rezaxr14/solar-panel-cleaning-robot/WORD-PDF-Docs/پروژه مکاترونیک فاز دوم بهراد مشهدی زمانی جلایر رضا ندیمی.pdf

ده

شک

ن
د ن ا

ي
و

ونن

فن
ومو

عل

گزارش پرژه ی مکاترونیک 1

### فاز دوم پروژه ربات تمیز کننده صفحات خورشیدی

### توسط:

### رضا ندیمی

### بهراد مشهدی زمانی جالیر

استاد درس:

### دکتر هادی

### نیمسال اول 1404-1405

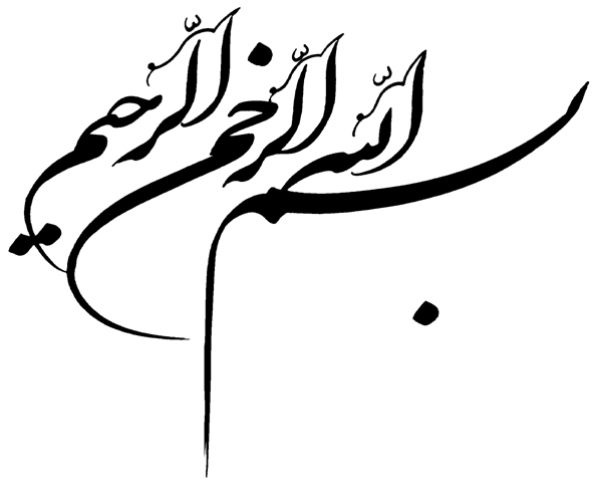
[picture p71: figure]

## فهرست

1-1پ یشگفتار | : 8
بخش دوم : فرآيند طراحی، سايزي نگ و انتخاب اجزای مکانیکی و الکترونیکی11 |
.2-1 مقدمه: رويکرد سیستمی در طراحی سخت افزار رباتیک12 |
2-2 .تحلیل دينامیکی ، سايزينگ موتور اصلی و طراحی سیستم انتقال قدرت: 12 |
2-2-1 .مدلسازی نیروهای مؤثر بر سیستم حرکتی ربات12 |
2-2-2 .اعمال ضريب ايمنی و تعیین نیروی طراحی 1۳ |
2-2-۳ .محاسبه گشتاور مورد نیاز در چرخ ها: 1۳ |
2-2-۴ .طراحی سیستم چرخ دنده و نسبت انتقال 1۳ |
2-2-۵ .محاسبه گشتاور موتور با لحاظ راندمان گیربکس 1۴ |
2-2-۶ .توزيع توان بین حرکت و سیستم برس تمیزکاری: 1۴ |
.2-2-7تحلیل کیفی و مهندس ی سیستم محرکه اصلی و انتقال قدرت 1۵ |
2-2-7 .تحلیل فیزيکی عبور از مانع ارتفاع ی و اعتبارسنجی گشتاور سیستم محرکه 1۶ |
2-۳ .بررسی، مقايسه و معرفی موتورهای الکتريکی موجود در بازار: 17 |
2-۳-1 .معرفی موتور گیربکسدار مدل37ZGA 18 | :
2-۳-2 .معرفی موتور پلهای23 NEMA : 19 |
2-۳-۳ .معرفی موتور گیربکسدار(23IG (Shayang : 21 |
2-۴ .انتخاب و سايزينگ سرووموتور چرخ جانبی برای عبور از ناهمترازی 22 |

2-۴-1 .محاسبه نیروی نرمال مؤثر بر سیستم2۳ |
2-۴-2 .تحلیل هندسی تماس چرخ جانبی با مانع 2۳ |
.2-۴-۳ محاسبه نیروی الزم برای باال رفتن از ناهمترازی 2۴ |
2-۴-۴ .محاسبه گشتاور مورد نیاز سرووموتور 2۴ |
2-۴-۵ .جمعبندی و نتیجهگیری مهندسی 2۵ |
2-۵-1 .معرفی سرووموتور – Delta سر ی2B-ASDA 2۵ |
2۵ | L7Nسری LS / Mecapion – | سرووموتور | معرفی. 2-۵-2
2۶ | Sigma-7 (SGM7E)سری Yaskawa – | سرووموتور | معرفی. 2-۵-۳
2-۶ .انتخاب و تحلیل سنسورهای مورد استفاده در سیستم27 |
2-۶-1 .سنسور موقعیتيابی 27 |
2-۶-2 .سنسور تشخیص پله و اختالف سطح) اولتراسونیک( 29 |
2-۶-۳ .سنسور تشخیص لبه)سنسور نوری( ۳1 |
2-۶-۴ .مقا يسه و انتخاب سنسورهای تشخیص لبه(Sensors Optical / IR (۳۳ |
-2-۶-۴سامانه بینايی و عمقياب ی مبتنی بر دوربینMini ZED : ۳۵ |
2-۶-۶ .انتخاب و تحلیل واحد پردازش مرکزی(32ESP (۳۶ | :
بخش ۳ : شبیه سازی ۳9 |
-۳-1مقدمه : ۴0 |
-۳-2شبیه سازی و طراحی سه بعدی در سالیدورک: ۴0 |
-۳-2-1تحلیل مکانیزم پولی–تسمه تنظیم ارتفاع برس: ۴1 |
-۳-2-2تحلیل انتخاب آرايش خروجی گیربکس و تخصیص آن به مکانیزم برس۴2 |
-۳-2-۳تحلیل خواص جرمی اسمبلی ربات تمیزکننده پنل خورشی دی۴۴ |
۳-2-۴مکانیزم چرخ های جانبی برای عبور از عدم همراستايی پنلها ۴7 |
۳-2-۵انکودر افزايشی شیاردار برا ی تعیین موقعیت خطی ربات: ۴9 |
-۳-۳شبیه سازی در متلب : ۵1 |
۶0 | Abstract

## فهرست اشکال

شکل1-2 تصویر موتور 37ZGA | 19
شکل 2-2 دیناشیت مربوط به موتور مورد نظر | 19
شکل 2-3 تصویر موتور پله ای 23NEMA | 21
شکل2-4 دیتاشیت برای موتور 23NEMA | 21
شکل2-5 تصویر موتور (23IG(SHAYANG | 22
شکل 2-6 لیست سررو های مورد نظر | 27
شکل 2-7 تصویر انکودر های انتخابی | 29
شکل 2-8 لیست سنسور های التراسونیک پ یشنهادی | 31
شکل9-2 سنوسر های نوری | 3⁵
شکل 2-10تصویر بلوک دیاگرام فعالیت های ربات | 38
شکل 3-1 طراحی سه بعدی ربات | 41
شکل3-2 تثویر موتور dc وگی ر بکس مورد نظر برای طراحی و خروجی های ان | 43
شکل | 3-3 44
46 | Mass Properties 3-3شکل
شکل | 3-5 47
شکل | 3-6 47
شکل 3-7نمونه تصویر وجود عدم هم راستایی در پنل های خورشیدی | 49
شکل 3-8 تصویر چرخ کناری در ربات برای جابجایی در عدم هم راستایی پنال های خورشیدی | 49
شکل 3-9 شبیه سازی ربات در سیمولینک | 53
شکل 3-10 سیکل رفت وبرگشت سهمرحله ای نشان | 54
شکل3-11 سرعت زاویه ای شفت موتور | 5⁵
شکل 3-12 تراژکتوری سفارشی 40 ثانیه ای با چرخشهای زمانی تتا | 57
شکل3-13 فایل ها ی کد برای باز کردن سیمولینک | 59
شکل3-14 سیمولینک های مورد نظر برای دریافت انیمیشن | 59

### چکیده

در مرحله اول اين پروژه، تمرکز بر تعريف نیازمندیهای عملکردی ربات و انتخاب قطعات کلیدی بود. تحلیل وظايف ربات منجر به

تعیین الزامات دقیق در زمینه گشتاور، سرعت و دقت حرکتی شد. در بخش انتخاب اکچويتورها ، بر اساس اين الزامات، محرکهای

اصلی )مانند موتورها يا جکهای خطی( با در نظر گرفتن نسبت توان به وزن بهینه انتخاب گرديدند. همزمان، فرآيند سايزينگ دقیق

برای اطمینان از ظرفیت کافی تمامی اجزای محرک انجام شد.

برای بخش حسگرها ، ترکیبی از سنسورهای موقعیت، نیرو و بینايی )در صورت لزوم( انتخاب شدند تا بازخورد دقیق محیطی و

وضعیت داخلی ربات فراهم شود. اين سنسورها بر اساس قابلیت اطمینان، نرخ نمونهبرداری و سازگاری با سیستم کنترل مرکزی

دسته بندی و نهايی شدند. در نهايت، تمامی اين اجزا در قالب يک طراحی مفهومی يکپارچه شدند. اين طراحی شامل شماتیک اولیه

مکانیزمها، محل قرارگیری اجزا و برآوردهای اولیه مصرف انرژی است که زيربنای طراحی تفصیلی مراحل بعدی خواهد بود. اين فاز

با موفقیت و تايید فنی تمامی انتخابهای اولیه به پايان رسید.
کلید واژه : انتخاب م حرک ، انتخاب سنسور ، طراحی مکانیکی، مدلسازی

# مقدمه

## 1-1پیشگفتار:

اين گزارش به تشريح فرآيند طراحی و توسعه يک سیستم رباتیک اختصاص دارد که هدف آن انجام حرکت در طول صفحه های خورشیدی و تمیز کاری در عین حال جابجايی به صفحات بعدی و تشخیص موانع و رد کردن ان ها در صورت توان است. طراحی رباتهای پیچیده نیازمند يک رويکرد سیستمی و چندرشتهای است که از تحلیل دقیق نیازمندیها آغاز شده و تا انتخاب دقیق اجزای سخت افزاری و نرمافزاری ادامه میيابد.

مرحله اول پروژه، که در اين گزارش ارائه میشود، بر پايهريزی چارچوب فنی و انتخاب اجزای حیاتی متمرکز بود. اين فاز شامل تعیین مشخصات عملکردی مورد نیاز، تجزيه و تحلیل بارگذاری ها و سپس انتخاب دقیق قطعاتی است که تضمین کننده دستیابی به اهداف طراحی باشند. در اين راستا، فرآيند اکچويتور سايزينگ به دقت انجام شد تا اطمینان حاصل شود که تمامی اجزای محرک )موتورها و سرووها( دارای توان و گشتاور کافی برای حرکت مطلوب هستند. همزمان، انتخاب مجموعهای از سنسورهای مناسب برای پايش وضعیت داخلی و تعامل با محیط، به عنوان ستون فقرات سیستم کنترل، مورد توجه قرار گرفت. اين تصمیمات اولیه، که نتیجه تلفیق تئوری مکانیک و دادههای عملکردی است، اساس طراحی فیزيکی و ساختار نهايی ربات را تشکیل میدهند.

## -1-2 هدف از اين الگو و دستورالعمل

هدف اصلی تدوين اين الگو و دستورالعمل، ايجاد چارچوبی منسجم و استاندارد برای فرآيند طراحی، مستندسازی و توسعه سیستم رباتیک است. اين سند با هدف اطمینان از انطباق تمامی مراحل طراحی با نیازمندیهای عملکردی، الزامات فنی و استانداردهای ايمنی تدوين شده است. هدف ديگر، تسهیل فرآيند تصمیمگیریهای مهندسی از طريق ارائه متدولوژی دقیق برای انتخاب قطعات )مانند موتور، سروو و سنسورها( و اکچويتور سايزينگ بر اساس تحلیلهای کمی و کیفی است.

اين الگو همچنین به منظور تضمین تداوم دانش فنی در تیم طراحی، ايجاد شفافیت در مراحل اجرايی و امکانپذيرسازی ارزيابیهای دقیق در فازهای بعدی )مانند ساخت و تست( عمل میکند. در نهايت، اين دستورالعمل راهکاری برای کاهش خطاهای طراحی، بهینه سازی مصرف انرژی و اطمینان از قابلیت اطمینان سیستم نهايی در شرايط عملیاتی واقعی ارائه میدهد.

### .1-2-1 توانايی عبور از موانع و عبورپذيری در محیط های ناهموار

يکی از اهداف بنیادين در طراحی اين ربات، تضمین قابلیت عملکرد پايدار در محیطهای دارای مانع و ناهمواری های سطحی است که در شرايط عملیاتی واقعی اجتنابناپذير هستند. برای تحقق اين هدف، استراتژی »عبور از موانع« در مرحله انتخاب اکچويتورها و طراحی مکانیسم چرخش محورهای محرک لحاظ شده است. با انجام محاسبات دقیق اکچويتور سايزينگ و اطمینان از گشتاور کافی، سیستم قادر است با غلبه بر نیروی اصطکاک و مقاومت ناشی از تغییر شیب، موانعی با ارتفاع مشخص را بدون گیر کردن يا از دست دادن تعادل پشت سر بگذارد. مکانیزم تعلیق و چیدمان چرخ ها/پاهای ربات به گونه ای بهینه سازی شده که در هنگام برخورد با مانع، نیروی عمودی الزم برای باال آوردن بدنه و عبور از آن با کمترين مصرف انرژی و حداکثر پايداری تأمین شود. اين قابلیت به ربات اجازه میدهد تا در صورت وجود خرابیهای سطحی، تیرهای سیمکشی، يا بلوکهای مانع، مسیر خود را به صورت مستقل و بدون نیاز به دخالت اپراتور ادامه دهد که اين امر برای اپلیکیشن های خودگردان حیاتی است.

### .1-2-2 مديريت انطباق و جابجايی در پنل های دارای اختالف ارتفاع

در سناريوی های عملیاتی که ربات بايد روی سطوحی نظیر پنل های خورشیدی يا ديوارهای بتنی حرکت کند، وجود اختالف ارتفاع يا شکافهای جزئی بین پنلها چالش اصلی محسوب میشود. اين گزارش تشريح میکند که چگونه سیستم طراحی شده با بهرهگیری از قابلیتهای کنترلی پیشرفته و انتخاب سروو-موتورهای با دقت باال، قادر است اين اختالف ارتفاعها را به صورت ايمن مديريت کند. هدف، جلوگیری از ايجاد شوک به بدنه و سنسورها و همچنین پیشگیری از لغزش يا سقوط ربات در زمان جابجايی روی لبههاست. با تحلیل دينامیک حرکت و تنظیم دقیق گشتاور سرووها، ربات میتواند با شیبهای مجاز و اختالف ارتفاعهای طراحیشده )مثالً تا چند سانتیمتر(، به تدريج و با هماهنگی محورهای مختلف حرکت کند تا نیروی ضربانی به حداقل برسد. اين رويکرد اطمینان حاصل میکند که حتی در صورت وجود ناهمواری های پیشبینینشده يا تغییرات جزئی در نصب پنلها، ربات همچنان ثبات خود را حفظ کرده و وظیفه خود را با موفقیت به انجام میرساند.

### .1-2-۳ استراتژی جابجايی طولی پس از تکمیل عملیات روی صفحات )سیستم ريلی عقب(

با توجه به نیاز به بازرسی يا تعمیر مداوم صفحات متعدد، طراحی مکانیکی ربات شامل يک سیستم ريلی اختصاصی در قسمت
1( است که امکان جابجايی سريع و دقیق پس از اتمام عملیات روی يک صفحه را فراهم می | عقب
کند. اين ريل به عنوان يک مسیر
2 | هدايتکننده
عمل کرده و با حذف وابستگی ربات به اصطکاک سطح زمین در لحظه جابجايی، دقت موقعیتيابی را افزايش میدهد.
هدف از اين طراحی، حذف زمان توقف طوالنی و کاهش فرسايش چرخ ها در حین تغییر محل از يک صفحه به صفحه مجاور است. پس از اتمام کار روی هر صفحه، سیستم میتواند بدنه را با استفاده از سروو-موتورهای ريلی به آرامی روی اين ريل جلو ببرد و در موقعیت شروع صفحه بعدی مستقر شود. اين مکانیزم نه تنها سرعت عملیات را افزايش میدهد، بلکه با ايجاد يک مسیر فیزيکی
۳ را در جابجايیهای تکراری به صفر نزديک میکند و امکان انجام عملیاتهای پی | مشخص، احتمال خطای مسیر
درپی را بدون نیاز
به تنظیم مجدد دستی فراهم میسازد.

### .1-2-۴ اصالح انحراف افقی و هم راستايی خودکار

يکی از چالشهای فنی در حرکت روی سطوح بزرگساخته، عدم دقت در قرارگیری اولیه يا انحراف جزئی محور حرکت ربات نسبت
۴ | به محور اصلی صفحات
است. برای مقابله با اين مسئله، در طراحی ربات امکانی لحاظ شده است تا در صورت وجود انحراف افقی،
ربات بتواند به صورت خودکار وضعیت خود را اصالح کرده و به مسیر صحیح بازگردد. اين قابلیت از طريق هماهنگی بین دادههای سنسورهای موقعیتياب )مانند اينورسینج يا سنسورهای فاصلهسنج( و کنترلوهای سروروها اعمال میشود. اگر ربات در هنگام حرکت روی ريل يا سطح پنل، نسبت به محور مرکزی انحراف داشته باشد، سیستم کنترلی با تغییر سرعت نسبی بین چرخهای چپ و راست )در رباتهای دو چرخ( يا با استفاده از مکانیزمهای چرخش مستقل، زاويه بدنه را اصالح کرده و آن را همراستا با مسیر میکند. اين

1 Rear Rail System
2 Guide Path
3 Deviation
4 Misalignment

۵ | مکانیزم »همراستايی خودکار
« تضمین میکند که حتی با وجود خطاهای اولیه در جايگذاری يا تغییرات مسیر، ربات همیشه در
مسیر مطلوب باقی مانده و از برخورد به لبه های پنلها يا افتادن از مسیر جلوگیری میشود که اين امر برای ايمنی و دقت عملیات حیاتی است.

5 Self-Alignment

## بخش دوم : فرآيند طراحی، سايزينگ و انتخاب اجزای مکانیکی و الکترونیکی

### .2-1 مقدمه: رويکرد سیستمی در طراحی سخت افزار رباتیک

اين بخش به تشريح روش شناسی جامع و محاسبات دقیق مهندسی مورد استفاده در فاز طراحی سختافزاری سیستم رباتیک میپردازد. هدف اصلی، استنتاج پارامترهای بهینه برای تمامی اجزای فعالکننده و حسکننده است، به گونهای که قیود دينامیکی و سینماتیکی مدل ربات به طور کامل محقق گردد. رويکرد اتخاذ شده، مبتنی بر تحلیل مدلسازی سیستم های دينامیکی و بهینه سازی پارامترهای کنترل است.

در گام نخست، با توجه به مشخصات طراحی شده در فاز مفهومی، نیازهای گشتاور و سرعت زاويهای برای هر درجه آزادی استخراج شد. اين استخراج، مبنای محاسبات سايزينگ اکچويتور قرار گرفت. برای اطمینان از توان الزم برای غلبه بر اينرسی، نیروی گرانش و نیروهای خارجی ناشی از عبور از موانع )مطابق با بخش -1 1-۳(، موتورهای اصلی بر اساس منحنیهای عملکردی انتخاب شدند. به موازات آن، سروو-موتورهای کمکی که مسئولیت تنظیم دقیق وضعیت و تصحیح خطاهای کوچک را بر عهده دارند، بر اساس الزامات مربوط به رزولوشن و زمان پاسخ دستهبندی و انتخاب گرديدند.

در ادامه، طراحی مکانیزم انتقال قدرت )شامل چرخدندهها و اتصاالت( بر اساس تحلیل مفهوم نسبت انتقال )( صورت پذيرفت تا تطابق بهینهای بین فضای عملیاتی موتور )حداکثر سرعت دورانی( و گشتاور مورد نیاز در مفاصل نهايی برقرار شود. سرانجام، برای حلقه بسته کنترل ، انتخاب سنسورها )شامل رمزگذارها ، سنسورهای اندازهگیری نیرو/گشتاور و سنسورهای ناوبری( با در نظر گرفتن معیارهايی چون نويز ، پهنای باند فرکانسی و يکپارچگی دادهها انجام شد. اين ترکیب هماهنگ از اجزای فعال و غیرفعال، زيربنای پیادهسازی الگوريتمهای پیشرفته کنترل حرکت در مراحل بعدی خواهد بود.

### 2-2 .تحلیل دينامیکی، سايزينگ موتور اصلی و طراحی سیستم انتقال قدرت:

### 2-2-1 .مدلسازی نیروهای مؤثر بر سیستم حرکتی ربات

با توجه به عملکرد ربات بر روی پنلهايی با زاويه شیب مشخص، اولین گام در سايزينگ اکچويتور، تحلیل نیروهای وارد بر سیستم حرکتی است. در اين پروژه، زاويه شیب پنلها برابر با:

2-1 =25∘ θ

در نظر گرفته شده است. مؤلفه نیروی وزن ربات در راستای شیب، که نیروی غالب در حرکت رو به باال محسوب میشود، از رابطه زير محاسبه میگردد:

Fgravity=mgsin(θ) | 2-2
با جايگذاری مقادير عددی:
)≈116.12N | 2-۳ 25∘ Fgravity=28.01×9.81×sin(

عالوه بر نیروی ناشی از گرانش، اثر عبور از موانع، ناهمواری سطح و مقاومتهای پیشبینینشده نیز لحاظ شده است. اين نیرو به صورت محافظه کارانه برابر با:

Fobstacle≈165.15N | 2-۴
در نظر گرفته شد. در نتیجه، نیروی پايه وارد بر سیستم برابر است با:
Fbare=Fgravity+Fobstacle=281.27N | 2-۵

### 2-2-2 .اعمال ضريب ايمنی و تعیین نیروی طراحی

به منظور تضمین عملکرد ايمن سیستم در شرايط غیرايدهآل، از ضريب ايمنی مکانیکی:

S.F1=2.25 | 2-۶
استفاده شده است. نیروی طراحی نهايی به صورت زير محاسبه میشود:
Fdesign=Fbare×S.F1 | 2-7

2-8

Fdesign=281.27×2.25≈632.86N

اين مقدار، مبنای محاسبات گشتاور چرخ ها و در نهايت موتور اصلی قرار گرفته است.

### 2-2-۳ .محاسبه گشتاور مورد نیاز در چرخ ها:

قطر خارجی چرخ ها برابر با ۶0 میلیمتر است، بنابراين شعاع مؤثر چرخ:

r=0.06m | 2-9
گشتاور کل مورد نیاز در مجموعه چرخ ها از رابطه زير به دست میآيد:
Twheels,total=Fdesign×r | 2-10
Twheels,total=632.86×0.06≈37.97N | 2-11
با توجه به اين که سیستم حرکتی از دو چرخ محرک استفاده میکند، گشتاور مورد نیاز برای هر چرخ برابر است با:
Twheel=Twheels,total/2≈18.98N | 2-12

### 2-2-۴ .طراحی سیستم چرخ دنده و نسبت انتقال

برای تطبیق گشتاور مورد نیاز چرخ ها با محدوده کاری موتور، از يک سیستم انتقال قدرت چندمرحلهای استفاده شده است. اين سیستم شامل چهار چرخدنده است که به صورت دو به دو با يکديگر درگیر هستند:

مرحله اول: نسبت دنده :

N1 = 92/20 | 2-1۳
مرحله دوم: نسبت دنده:
N2= 220/40 | 1۴-2

نسبت انتقال کل سیستم از حاصلضرب اين دو مرحله به دست میآيد:

I=92/20×220/40=25.3 | 2-1۵

اين نسبت انتقال، نقش کلیدی در افزايش گشتاور خروجی و کاهش سرعت زاويهای ايفا میکند و به گونهای انتخاب شده است که هم نیاز حرکتی ربات و هم نیاز عملکردی برس تمیزکاری را پوشش دهد.

### 2-2-۵ .محاسبه گشتاور موتور با لحاظ راندمان گیربکس

با در نظر گرفتن راندمان گیربکس:

η=85%=0.85 | 2-16
گشتاور مورد نیاز موتور از رابطه زير محاسبه میشود:
Tmotor= Twheel/I×η | 2-17
Tmotor=18.98/25.3×0.85≈0.88N | 2-18

اين مقدار، حداقل گشتاور نامی مورد نیاز موتور اصلی است که مبنای انتخاب موتور قرار گرفته است .

### 2-2-۶ .توزيع توان بین حرکت و سیستم برس تمیزکاری:

يکی از ويژگیهای مهم طراحی اين سیستم، استفاده همزمان از خروجی گیربکس برای حرکت ربات و چرخش برس تمیزکاری است. به دلیل نسبت انتقال باال، سرعت خروجی موتور به دو شاخه تقسیم میشود:

شاخه اول: ورودی چرخ های حرکتی با سرعت خطی طراحیشده برابر با:

v=10m/min | 2-19
شاخه دوم: ورودی برس تمیزکاری که به دلیل استفاده از نسبت های دنده متفاوت، دارای سرعت زاويهای باالتر نسبت به چرخ ها است.

اين افزايش سرعت برس، منجر به بهبود کیفیت عملیات تمیزکاری بدون نیاز به موتور مجزا شده و در نتیجه باعث کاهش وزن، مصرف انرژی و پیچیدگی سیستم میگردد. چنین طراحی ای نشاندهنده يک رويکرد بهینه سازی چندهدفه در طراحی مکانیکی– مکاترونیکی سیستم است.

### .2-2-7 تحلیل کیفی و مهندسی سیستم محرکه اصلی و انتقال قدرت

در طراحی سیستم حرکتی ربات، رويکرد اصلی بر پايه تحلیل جامع رفتار دينامیکی ربات در شرايط واقعی بهرهبرداری بنا نهاده شده است. با توجه به اين که ربات موظف به حرکت بر روی سطوح شیب دار با زاويه قابل توجه است، نیروی محرکه مورد نیاز نهتنها بايد بر مؤلفه وزن در راستای شیب غلبه کند، بلکه بايد توانايی مقابله با اثرات ناشی از ناهمواری سطح، اصطکاکهای متغیر و عبور از موانع موضعی را نیز داشته باشد. از اين رو، طراحی سیستم محرکه با ديدگاه محافظهکارانه و با لحاظ ضرايب ايمنی مناسب انجام شده تا عملکرد پايدار سیستم در بدترين شرايط کاری تضمین شود.

در اين راستا، ابتدا نیازمندیهای حرکتی ربات شامل سرعت خطی هدف، پايداری حرکتی و قابلیت عبور از موانع مشخص گرديد. سپس با تحلیل بارگذاری مکانیکی وارد بر چرخها، گشتاور مورد نیاز در سطح تماس با زمین استخراج شد. اين تحلیلها نشان داد که استفاده مستقیم از موتور بدون سیستم انتقال قدرت، نه از نظر گشتاور خروجی و نه از نظر بهرهوری انرژی، گزينه مناسبی نخواهد بود. به همین دلیل، طراحی يک سیستم چرخ دنده چندمرحلهای به عنوان واسط بین موتور و مصرف کننده نهايی نیرو، در دستور کار قرار گرفت.

سیستم انتقال قدرت طراحیشده شامل چهار چرخدنده است که به صورت دو مرحله کاهش دور به يکديگر متصل شدهاند. اين آرايش، امکان دستیابی به نسبت انتقال باال را فراهم میکند، در حالی که توزيع بار بین مراحل مختلف باعث کاهش تنشهای مکانیکی و افزايش طول عمر اجزا میشود. نسبت انتقال کل سیستم به گونهای انتخاب شده است که موتور در ناحیه کاری بهینه خود از نظر گشتاور و راندمان عمل کرده و در عین حال، گشتاور کافی برای حرکت ايمن ربات بر روی شیب تأمین گردد.

يکی از مالحظات مهم در اين طراحی، لحاظ کردن راندمان واقعی سیستم انتقال قدرت است. با توجه به تلفات ناشی از اصطکاک، لقی دندهها و اتالف انرژی در ياتاقانها، راندمان گیربکس کمتر از حالت ايدهآل در نظر گرفته شد. اين موضوع باعث شد انتخاب موتور نه صرفاً بر اساس گشتاور تئوريک، بلکه بر مبنای گشتاور مؤثر در خروجی گیربکس انجام شود. چنین رويکردی، ريسک کمکاری موتور و افزايش دمای کاری در شرايط بارگذاری باال را به حداقل میرساند.

از منظر معماری سیستم، طراحی انتقال قدرت به نحوی انجام شده است که يک موتور واحد بتواند به طور همزمان دو وظیفه کلیدی را انجام دهد: تأمین نیروی حرکتی ربات و به حرکت درآوردن برس تمیزکاری. در اين ساختار، خروجیهای مختلف گیربکس با نسبتهای دور متفاوت مورد استفاده قرار گرفتهاند، به طوری که سرعت چرخش برس به صورت ذاتی بیشتر از سرعت چرخهاست. اين اختالف سرعت کامالً هدفمند بوده و منجر به افزايش اثربخشی فرآيند تمیزکاری بدون نیاز به افزايش توان موتور يا افزودن اکچويتور مجزا میشود.

اين رويکرد يکپارچه در طراحی سیستم محرکه، نمونه ای از بهینه سازی مکاترونیکی است که در آن، کاهش وزن کلی، سادهسازی سیستم، کاهش مصرف انرژی و افزايش قابلیت اطمینان به صورت همزمان مدنظر قرار گرفته اند. در نهايت، نتايج حاصل از اين فرآيند طراحی نشان میدهد که موتور انتخابشده، در کنار سیستم چرخدنده طراحیشده، قادر است الزامات حرکتی و عملکردی ربات را با حاشیه ايمنی مناسب برآورده سازد و بستر الزم برای پیادهسازی الگوريتمهای کنترلی دقیق در مراحل بعدی پروژه را فراهم کند.

### 2-2-7 .تحلیل فیزيکی عبور از مانع ارتفاعی و اعتبارسنجی گشتاور سیستم محرکه

عالوه بر حرکت پايدار ربات بر روی سطوح شیب دار، يکی از چالشهای مهم در عملکرد سیستم حرکتی، توانايی عبور از موانع موضعی ناشی از تغییرات ناگهانی ارتفاع، اختالف تراز بین پنلها و ناهمواری های سطحی است. اين وضعیتها معموالً منجر به افزايش لحظه ای گشتاور مورد نیاز در چرخها شده و میتوانند بهعنوان شرايط بحرانی در طراحی سیستم محرکه در نظر گرفته شوند. از اين رو، بررسی فیزيک عبور از مانع بهعنوان يک سناريوی حدی، نقش مهمی در اعتبارسنجی سايزينگ موتور و سیستم انتقال قدرت ايفا میکند.

در اين تحلیل، ارتفاع مانع برابر با:

H=10mm=0.01m | 2-20
در نظر گرفته شده است که مقدار متداولی برای اختالف ارتفاع بین سطوح کاری ربات محسوب میشود. همچنین، با توجه به نتايج بخشهای پیشین، گشتاور نامی موتور برابر با:
Tmotor=0.88N | 2-21
فرض شده است. گشتاور قابل دستیابی در چرخها با در نظر گرفتن نسبت انتقال کل گیربکس و راندمان سیستم انتقال قدرت از رابطه زير به دست میآيد:
Twheel=Tmotor×GR×η | 2-22
Twheel=0.88×25.3×0.85=18.92N | 2-2۳
در لحظه ای که چرخ با مانع تماس پیدا میکند، شرايط تماس از حالت غلتش يکنواخت خارج شده و چرخ ناچار است حول لبه مانع دوران کند. در اين وضعیت، فاصله افقی مؤثر بین مرکز چرخ و نقطه تماس با مانع بهعنوان بازوی گشتاور مقاوم عمل میکند. اين فاصله بر اساس هندسه چرخ و ارتفاع مانع به صورت زير محاسبه میشود:

2-2۴ ⁰.5 )

2 −(r−h)

2
x=(r
که با جايگذاری شعاع چرخ m0.03=r و ارتفاع مانع m0.01=h :
≈0.022m | 2-2۵ ⁰.5 )

2
x=(2(0.03)(0.01)−(0.01)
در ادامه، گشتاور مورد نیاز برای عبور از مانع از حاصلضرب نیروی وارد بر چرخ در اين بازوی مؤثر به دست میآيد. با در نظر گرفتن نیروی معادل وارد بر سیستم حرکتی برابر با:

F≈275N | 2-2۶
گشتاور مقاوم الزم برای عبور از مانع به صورت زير محاسبه میشود:
Treq=F×x | 2-27
Treq=275×0.022≈6.15N | 2-28
در نهايت، برای ارزيابی حاشیه ايمنی سیستم در اين سناريوی بحرانی، ضريب ايمنی عبور از مانع به صورت نسبت گشتاور در دسترس چرخ ها به گشتاور مورد نیاز تعريف میشود:
F.S= Twheel/ Treq | 2-29
F.S=18.92/6.15≈3.08 | 2-۳0
مقدار به دستآمده برای ضريب ايمنی نشان میدهد که گشتاور خروجی سیستم محرکه بهطور قابل توجهی بزرگتر از گشتاور الزم برای عبور از مانع ارتفاعی مورد نظر است. اين نتیجه بیانگر آن است که موتور و سیستم انتقال قدرت طراحی شده، حتی در شرايط بحرانی عبور از موانع، دارای حاشیه ايمنی کافی بوده و از نظر مکانیکی دچار کمبود گشتاور نخواهند شد.

در نتیجه، اين تحلیل بهعنوان يک اعتبارسنجی تکمیلی تأيید میکند که گشتاور سايزشده در بخشهای پیشین، نهتنها برای حرکت يکنواخت ربات روی شیب مناسب است، بلکه توانايی عبور از موانع موضعی نظیر تغییرات ارتفاع سطح را نیز به صورت مطمئن فراهم میکند. بر اين اساس، در بخش بعدی میتوان با اطمینان وارد مرحله بررسی و مقايسه موتورهای الکتريکی موجود در بازار شد.

### 2-۳ .بررسی، مقايسه و معرفی موتورهای الکتريکی موجود در بازار:

پس از انجام تحلیلهای دينامیکی، تعیین بارگذاری واقعی سیستم حرکتی و محاسبه گشتاور و سرعت مورد نیاز موتور اصلی، گام بعدی در فرآيند طراحی، تطبیق نتايج تئوريک با گزينههای عملی موجود در بازار است. در اين مرحله، هدف صرفاً يافتن موتوری با گشتاور نامی کافی نیست، بلکه انتخاب يک راهحل مهندسی بهینه است که مجموعه ای از معیارهای عملکردی، الکتريکی، مکانیکی و اقتصادی را بهصورت همزمان برآورده سازد.

موتورهای الکتريکی تجاری، علیرغم شباهت ظاهری، دارای تفاوتهای قابلتوجهی در مشخصاتی نظیر منحنی گشتاور–سرعت، راندمان، توان نامی، ولتاژ کاری، جريان مصرفی، کالس عايقی، قابلیت کار پیوسته و سازگاری با سیستمهای کنترلی هستند. از اين رو، انتخاب موتور بدون بررسی دقیق ديتاشیتها و مقايسه سیستماتیک گزينه ها میتواند منجر به افزايش مصرف انرژی، کاهش طول عمر سیستم و يا محدوديت در عملکرد دينامیکی ربات شود.

در اين بخش، ابتدا مجموعهای از موتورهای الکتريکی متداول و در دسترس در بازار که از نظر مشخصات کلی با نیازمندیهای استخراج شده در بخشهای پیشین همخوانی دارند، معرفی میشوند. سپس هر موتور از منظر پارامترهای کلیدی نظیر گشتاور نامی و بیشینه، سرعت کاری، توان خروجی، بازه ولتاژ و جريان، ابعاد فیزيکی، جرم و قابلیت اتصال به گیربکس مورد تحلیل قرار

میگیرد. در ادامه، مزايا و محدوديتهای هر گزينه در کاربرد خاص اين ربات بررسی شده و در نهايت، مناسبترين موتور بهعنوان انتخاب نهايی پروژه پیشنهاد میشود.

اين رويکرد مرحله ای، تضمین میکند که انتخاب موتور نه بر اساس در دسترس بودن يا تجربههای پیشین، بلکه بر مبنای يک فرآيند مهندسی مستند، قابل دفاع و منطبق با الزامات عملکردی سیستم انجام پذيرد.

### 2-۳-1 .معرفی موتور گیربکسدار مدل۳7ZGA :

موتور 37ZGA يکی از موتورهای DC گیربکسدار پرکاربرد در سامانههای رباتیکی و مکانیزمهای حرکتی با ابعاد متوسط است که به دلیل ترکیب مناسب گشتاور خروجی، ابعاد فشرده و سادگی راهاندازی، در بسیاری از کاربردهای عملی مورد استفاده قرار میگیرد. اين موتور معموالً به يک گیربکس سیارهای يا اسپُر با قطر اسمی حدود ۳7 میلیمتر مجهز است که امکان دستیابی به گشتاورهای نسبتاً باال در سرعتهای خروجی پايینتر را فراهم میکند.

بر اساس اطالعات ارائه شده در ديتاشیت، گشتاور نامی خروجی موتور 37ZGA برابر با 1 نیوتنمتر است. اين مقدار گشتاور بیانگر توانايی موتور در تولید گشتاور پايدار و پیوسته در شرايط کاری نرمال، بدون ورود به ناحیه اضافهبار يا افزايش غیرمجاز دما و جريان مصرفی است. در نتیجه، گشتاور نامی 1 m·N بهعنوان يک معیار محافظهکارانه و قابل اتکا برای طراحی سیستم محرکه در نظر گرفته میشود.

در چارچوب طراحی انجامشده در اين پروژه، مقدار گشتاور نامی موتور 37ZGA با نیازهای استخراج شده از تحلیلهای دينامیکی و استاتیکی )حرکت روی شیب و عبور از مانع ارتفاعی( همخوانی اولیه دارد. بهويژه، با در نظر گرفتن وجود سیستم انتقال قدرت و امکان افزايش گشتاور مؤثر در سطح چرخ ها، اين موتور میتواند بهعنوان يک گزينه ی بالقوه برای تأمین گشتاور مورد نیاز سیستم حرکتی مطرح شود.

از سوی ديگر، استفاده از موتورهای گیربکسدار نظیر 37ZGA موجب کاهش نیاز به طراحی گیربکس سفارشی، سادهسازی معماری مکانیکی و افزايش قابلیت اطمینان کلی سیستم میشود. اين ويژگیها، در کنار دسترسی مناسب اين موتور در بازار و پشتیبانی گسترده از نظر قطعات يدکی، آن را به گزينهای عملی برای پیادهسازی نمونهی واقعی سیستم تبديل میکند.

در ادامه اين بخش، با مقايسهی دقیقتر موتور 37ZGA با ساير گزينه های موجود در بازار از نظر گشتاور، سرعت، راندمان، ابعاد و سازگاری با طراحی مکانیکی، امکان انتخاب نهايی موتور مناسب برای سیستم محرکه فراهم خواهد شد.

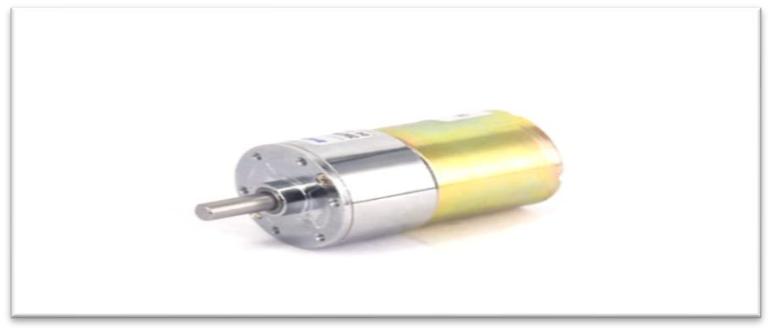
[picture p72: figure]

شکل1-2 تصوير موتور ۳7ZGA

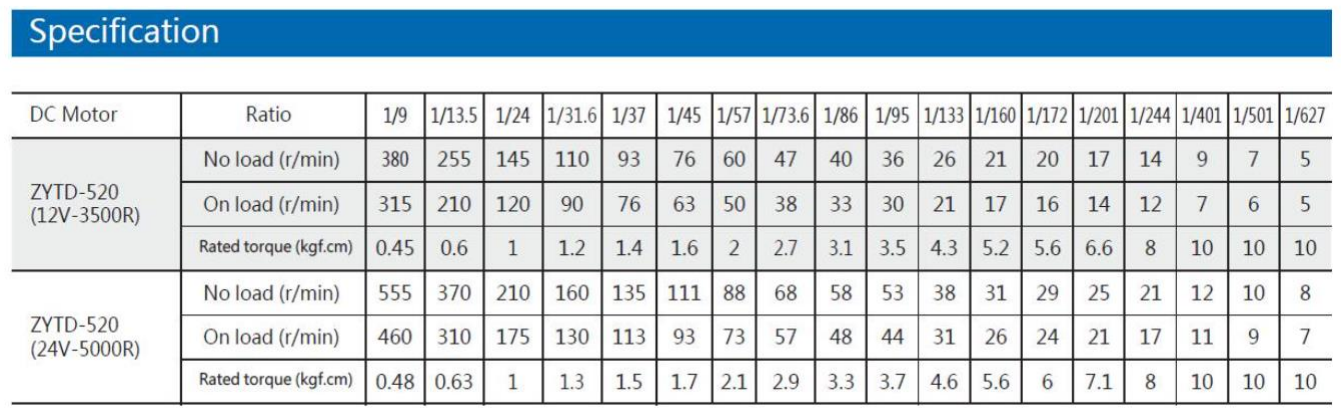
[picture p73: figure]

شکل -2 2 ديناشیت مربوط به موتور مورد نظر

### 2-۳-2 .معرفی موتور پله ای2۳ NEMA :

موتور 23 NEMA يکی از استانداردترين و پرکاربردترين موتورهای پلهای
۶
در سامانههای حرکتی صنعتی، نیمهصنعتی و
رباتیکی است. عبارت 23 NEMA به يک استاندارد ابعادی مشخص )ابعاد فلنج ۵7 × ۵7 میلیمتر( اشاره دارد که باعث شده اين موتور توسط شرکت های متعدد در سراسر جهان تولید شده و با طیف وسیعی از درايورها، کوپلینگها و اجزای مکانیکی سازگار باشد.

بر اساس مشخصات در نظر گرفتهشده در اين پروژه، گشتاور نامی موتور 23 NEMA برابر با 0٫9 نیوتن متر است. اين مقدار گشتاور، برای کاربردهايی که نیاز به کنترل دقیق موقعیت و سرعت در دورهای پايین دارند، مقدار متداول و قابل اتکايی محسوب

6 Stepper Motor

میشود. موتورهای پلهای از جمله 23 NEMA قادرند بدون استفاده از فیدبک موقعیت، حرکتهای گسسته و قابل پیشبینی ايجاد کنند که اين ويژگی در بسیاری از سامانههای حرکتی مزيت محسوب میشود.

از منظر تناسب با اين پروژه، موتور 23 NEMA چند ويژگی مهم دارد. نخست آنکه گشتاور مناسب آن در سرعتهای پايین، امکان تأمین نیروی محرکه الزم برای حرکت آرام و کنترل شده ربات را فراهم میکند. دوم، ساختار ساده و عدم نیاز ذاتی به انکودر يا سیستم کنترلی پیچیده، موجب کاهش پیچیدگی نرمافزاری و سختافزاری سیستم میشود. اين موضوع به ويژه در مراحل اولیه توسعه و ساخت نمونه آزمايشگاهی اهمیت دارد.

از نظر تولیدکنندگان، موتورهای 23 NEMA توسط شرکت های متعددی در سطح بینالمللی تولید میشوند که از جمله برندهای شناختهشده میتوان به Leadshine، Wantai، StepperOnline و Motor Oriental اشاره کرد. اين تنوع تولیدکننده موجب شده است که اين موتور در بازههای قیمتی مختلف و با کیفیتهای متفاوت در بازار موجود باشد.

از منظر دسترسی، موتور 23 NEMA يکی از در دسترسترين موتورهای صنعتی در بازار ايران محسوب میشود. اين موتور بهطور گسترده توسط فروشندگان تجهیزات اتوماسیون، CNC و رباتیک عرضه شده و تهیه آن بههمراه درايورهای سازگار، قطعات يدکی و متعلقات مکانیکی بهسادگی امکانپذير است. اين مزيت عملیاتی، ريسک تأمین قطعه و هزينههای نگهداری سیستم را بهطور قابل توجهی کاهش میدهد.

در مجموع، موتور پلهای 23 NEMA با وجود گشتاور نامی 0٫9 نیوتن متر، به دلیل استاندارد ابعادی، تنوع تولیدکننده، سهولت تأمین در بازار ايران و سادگی پیادهسازی کنترلی، میتواند بهعنوان يک گزينهی عملی و قابل اتکا برای سیستم حرکتی مورد بررسی قرار گیرد. با اين حال، انتخاب نهايی میان اين موتور و ساير گزينه ها نیازمند مقايسه دقیقتر از نظر راندمان، مصرف انرژی، رفتار دينامیکی و تطابق با نیازهای حرکتی پروژه خواهد بود که در ادامه به آن پرداخته میشود.

شکل 2-۳ تصوير موتور پله ای 2۳NEMA


تصوير2-۴ ديتاشیت برای موتور 2۳NEMA

### 2-۳-۳ .معرفی موتور گیربکسدار)2۳IG )Shayang :

موتور Shayang مدل 23IG يکی از موتورهای گیربکسدار صنعتی است که توسط شرکت Motor Shayang تولید میشود. اين شرکت يک تولیدکننده چینی فعال در حوزه موتورهای الکتريکی، موتورهای گیربکسدار و راهکارهای حرکتی برای کاربردهای صنعتی و رباتیکی است و محصوالت آن بهطور گسترده در بازارهای آسیايی و خاورمیانه مورد استفاده قرار میگیرند. سری 23IG بهطور خاص برای کاربردهايی طراحی شده است که نیاز به گشتاور نسبتاً باال در ابعاد جمعوجور دارند.

بر اساس مشخصات در نظر گرفتهشده در اين پروژه، گشتاور نامی خروجی موتور (23IG (Shayang برابر با 0٫98 نیوتنمتر است. اين مقدار گشتاور، بیانگر توانايی موتور در تأمین گشتاور پیوسته و پايدار در شرايط کاری نرمال بوده و میتواند بدون ورود به ناحیه اضافهبار، نیازهای حرکتی سیستم را برآورده سازد. نزديکی اين مقدار به گشتاور نامی ساير گزينههای بررسیشده، امکان مقايسه مستقیم و منصفانه میان موتورها را فراهم میکند.

از منظر تناسب با اين پروژه، موتور 23IG چند مزيت کلیدی دارد. نخست، وجود گیربکس داخلی باعث میشود گشتاور خروجی بهصورت مستقیم و بدون نیاز به طراحی يا انتخاب گیربکس خارجی در دسترس باشد که اين موضوع منجر به سادهسازی طراحی مکانیکی و کاهش حجم کلی سیستم میشود. دوم، رفتار يکنواخت موتورهای گیربکسدار در سرعت های پايین، آن را برای کاربردهايی که نیاز به حرکت کنترلشده و پايدار دارند، مناسب میسازد.

از نظر دسترسی و تأمین، موتورهای Shayang از جمله سری 23IG در بازار ايران به طور نسبی در دسترس هستند و توسط برخی تأمینکنندگان تجهیزات صنعتی و رباتیکی عرضه میشوند. اين موضوع، در کنار قیمت رقابتی محصوالت اين برند نسبت به نمونههای اروپايی يا ژاپنی، موجب شده است که اين موتور در پروژههای عملی و نمونهسازی، گزينهای اقتصادی و قابل اجرا محسوب شود.

در مجموع، موتور (23IG (Shayang با گشتاور نامی 0٫98 نیوتنمتر، ابعاد فشرده، وجود گیربکس داخلی و دسترسی مناسب در بازار، میتواند بهعنوان يکی از گزينههای قابل بررسی برای سیستم محرکه اين پروژه مطرح شود. انتخاب نهايی اين موتور در مقايسه با ساير گزينهها، نیازمند ارزيابی دقیقتر از نظر راندمان، دوام، رفتار دينامیکی و سازگاری با ساختار مکانیکی طراحیشده خواهد بود که در ادامه به آن پرداخته میشود.

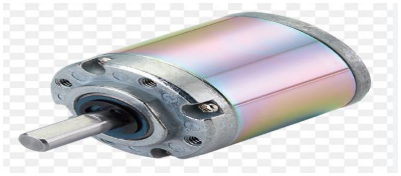
[picture p74: figure]

شکل2-۵ تصوير موتور )2۳IG)SHAYANG

### 2-۴ .انتخاب و سايزينگ سرووموتور چرخ جانبی برای عبور از ناهم ترازی

در محیط های واقعی، مسیر حرکت ربات همواره کامالً همتراز و همراستا با محور حرکتی اصلی نیست. اختالف سطح جانبی، فاصله بین پنلها و ناهماهنگیهای موضعی در امتداد عرض مسیر میتوانند منجر به ايجاد ناهمترازی شوند. در چنین شرايطی، چرخهای اصلی بهتنهايی قادر به حفظ پايداری حرکتی نبوده و احتمال گیرکردن، افزايش تنش مکانیکی يا انحراف مسیر وجود دارد. بهمنظور

رفع اين چالش، از چرخ جانبی کمکی مجهز به سرووموتور استفاده میشود که وظیفه آن کمک به عبور ربات از موانع جانبی و شکافهای عرضی است.

در اين طراحی، حداکثر اندازه ناهمترازی يا فاصله جانبی قابل عبور برابر با:

w=50mm=0.05m | 2-۳1
در نظر گرفته شده است که بیانگر بدترين حالت ناهمواری عرضی مسیر است. هدف از اين بخش، محاسبه نیروی الزم برای باال رفتن چرخ جانبی از اين مانع و در نهايت تعیین گشتاور طراحی مورد نیاز سرووموتور است.

### 2-۴-1 .محاسبه نیروی نرمال مؤثر بر سیستم

با توجه به جرم کل سیستم برابر با:

m=28.01kg | 2-32

و حرکت ربات روی سطحی با زاويه شیب:

2-۳۳ =25∘ θ
نیروی نرمال کل وارد بر سیستم از رابطه زير محاسبه میشود:
Ntotal=m⋅g⋅cos(θ) | 2-۳۴
)≈249.0N | 2-۳۵ 25∘ Ntotal=28.01×9.81×cos(

با فرض توزيع متقارن بار بین چرخ های جانبی، نیروی نرمال مؤثر بر هر چرخ جانبی برابر با نصف مقدار کل در نظر گرفته میشود:

Naux=Ntotal/2 | 2-۳۶
Naux≈124.5N | 2-۳7

### 2-۴-2 .تحلیل هندسی تماس چرخ جانبی با مانع

در لحظه تماس چرخ جانبی با لبه ناهمترازی، چرخ به جای غلتش آزاد، حول لبه مانع دوران میکند. در اين وضعیت، بازوی نیروهای وارد بر چرخ نقش تعیینکنندهای در نیروی مورد نیاز برای باال رفتن از مانع دارد.

نصف عرض شکاف جانبی بهعنوان فاصله افقی بین مرکز چرخ و لبه مانع در نظر گرفته میشود:

x=w/2=0.025m | 2-38

با فرض شعاع چرخ جانبی برابر با:

r=0.03m | 2-39

فاصله عمودی مؤثر بین مرکز چرخ و نقطه تماس )بازوی نیروی باالرونده( از رابطه هندسی زير محاسبه میشود:

2-40 ⁰.5 )

2 −x

2
y=(r
≈0.01658m | 2-41 ⁰.5 )

2 −0.025 ²
y=(0.03

### .2-۴-۳ محاسبه نیروی الزم برای باال رفتن از ناهم ترازی

برای شروع حرکت چرخ جانبی به سمت باال و عبور از مانع، تعادل گشتاورها حول لبه مانع برقرار میشود. در اين حالت، نیروی باالرونده چرخ Fclimbبايد گشتاوری معادل گشتاور ناشی از نیروی نرمال ايجاد کند:

Fclimb⋅y=Naux⋅x | 2-۴2
از اين رابطه، نیروی الزم برای باال رفتن چرخ جانبی به دست میآيد:
Fclimb=124.5×0.025/0.01658≈187.7N | 2-۴۳
اين نیرو، حداقل نیرويی است که سرووموتور بايد در تماس چرخ با مانع ايجاد کند تا عبور از ناهمترازی ممکن شود.

### 2-۴-۴ .محاسبه گشتاور مورد نیاز سرووموتور

گشتاور خام مورد نیاز در محور چرخ جانبی از حاصلضرب نیروی باالرونده در شعاع چرخ به دست میآيد:

Tbare=Fclimb⋅r | 2-۴۴
Tbare=187.7×0.03≈5.63N | 2-۴۵
با توجه به وجود عوامل عدم قطعیت نظیر اصطکاک، تلفات مکانیکی، ضربههای لحظهای و نیاز به حاشیه ايمنی مناسب، گشتاور طراحی نهايی با در نظر گرفتن يک گشتاور اضافی و ضريب ايمنی محاسبه میشود:
Tdesign=(Tbare+1.5)×2.25 | 2-۴۶

Tdesign≈(5.63+1.5)×2.25≈12.12N | 2-۴7

## 2-۴-۵ .جمعبندی و نتیجهگیری مهندسی

نتايج اين تحلیل نشان میدهد که برای عبور ايمن از ناهمترازی های جانبی تا حداکثر ۵0 میلیمتر ، سرووموتور چرخ جانبی بايد قادر به تأمین حداقل گشتاور طراحی 12 نیوتنمتر باشد. اين مقدار گشتاور شامل اثرات هندسی، توزيع بار، و ضرايب ايمنی الزم برای عملکرد پايدار سیستم در شرايط واقعی است.

بر اين اساس، استفاده از يک سرووموتور با گشتاور نامی باالتر از مقدار محاسبه شده، تضمین میکند که ربات در مواجهه با ناهمترازی های جانبی و شرايط ، بدون گیرکردن يا ايجاد تنشهای مخرب مکانیکی، قادر به حفظ پايداری و ادامه حرکت خواهد بود. اين بخش، مبنای انتخاب نهايی سرووموتور چرخ جانبی در مراحل بعدی طراحی قرار میگیرد.

### 2-۵-1 .معرفی سرووموتور – Delta سری2B-ASDA

سرووموتورهای Delta سری 2B-ASDA از جمله سرووهای AC صنعتی پرکاربرد هستند که بهطور گسترده در سامانههای اتوماسیون، رباتیک و ماشین آالت دقیق مورد استفاده قرار میگیرند. اين سری با تمرکز بر پاسخ دينامیکی مناسب، پايداری عملکرد و سهولت يکپارچه سازی با سیستم های کنترلی طراحی شده است و به همین دلیل گزينه ای متداول در پروژههای مهندسی کاربردی محسوب میشود.

يکی از ويژگیهای کلیدی 2B-ASDA، توانايی آن در تأمین گشتاور پايدار در بازه وسیعی از سرعتها است که برای کاربردهايی نظیر چرخ جانبی اصالح ناهمترازی اهمیت بااليی دارد. در چنین کاربردی، سرووموتور بايد بتواند در لحظات تماس با مانع، افزايش ناگهانی بار را بدون افت عملکرد يا ناپايداری کنترلی تحمل کند. معماری کنترلی اين سری بهگونهای است که پاسخ مناسبی در برابر اغتشاشات مکانیکی و تغییرات بار لحظه ای ارائه میدهد.

از منظر کنترلی، سروودرايوهای 2B-ASDA از حلقههای بسته موقعیت، سرعت و گشتاور پشتیبانی میکنند که اين موضوع امکان پیادهسازی استراتژی های کنترلی دقیق برای اصالح همراستايی سیستم را فراهم میسازد. همچنین، سازگاری مناسب با انکودرهای با رزولوشن باال، دقت عملکرد چرخ جانبی را در عبور از ناهمترازیهای عرضی تضمین میکند.

با توجه به دسترسی مناسب در بازار ايران، پشتیبانی فنی قابل قبول و قیمت رقابتی، سرووموتور 2B-ASDA Delta میتواند بهعنوان يکی از گزينه های عملی و اقتصادی برای تأمین گشتاور مورد نیاز چرخ جانبی در اين پروژه در نظر گرفته شود.

L7N | سری LS / Mecapion – | سرووموتور | معرفی | . 2-۵-2

سرووموتورهای Mecapion LS سری N7L از محصوالت رده صنعتی با تمرکز بر کارايی دينامیکی باال و دقت کنترلی مناسب هستند. اين سری حاصل همکاری فناورانه شرکت LS با برند Mecapion بوده و بهعنوان يکی از گزينههای قابل اعتماد در کاربردهای رباتیکی و سیستمهای حرکتی نیمهسنگین شناخته میشود.

ويژگی برجسته سری N7L، عملکرد نرم و پايدار آن در شرايط بارگذاری متغیر است. در کاربرد چرخ جانبی، سرووموتور بايد بتواند بهصورت لحظه ای گشتاور الزم برای باال رفتن از ناهمترازی را تولید کرده و بالفاصله پس از عبور از مانع، به وضعیت پايدار بازگردد. ساختار الکترومکانیکی اين سری بهگونه ای طراحی شده است که اين تغییرات سريع بار، منجر به نوسانات شديد يا خطای کنترلی نشود.

از منظر طراحی مهندسی، سری N7L برای کار در سیستم هايی با چرخه های کاری مکرر و بارهای گذرا مناسب است. اين موضوع با ماهیت عملکرد چرخ جانبی که بهصورت مقطعی و فقط در شرايط Misalignment فعال میشود، همخوانی بااليی دارد. همچنین، قابلیت تنظیم دقیق پارامترهای کنترلی، امکان تطبیق رفتار سروو با مدل دينامیکی سیستم مکانیکی طراحی شده را فراهم میسازد.

با توجه به کیفیت ساخت مناسب، پايداری عملکرد و حضور اين برند در بازار صنعتی ايران، سرووموتور N7L Mecapion/LS میتواند بهعنوان گزينهای میانی بین راهکارهای اقتصادی و سرووهای ردهباالی صنعتی مطرح شود.
Sigma-7 )SGM7E(سری Yaskawa – | سرووموتور | معرفی | . 2-۵-۳

سرووموتورهای Yaskawa سری -Sigma7 به عنوان يکی از پیشرفته ترين و دقیقترين سرووهای AC صنعتی در سطح جهانی شناخته میشوند. اين سری با هدف دستیابی به بیشترين دقت، پاسخ دينامیکی بسیار سريع و حداقل نوسان مکانیکی طراحی شده و در کاربردهای حساس رباتیکی، تجهیزات پزشکی و سیستمهای حرکتی با دقت باال مورد استفاده قرار میگیرد.

مدل E7SGM از اين سری، با بهرهگیری از انکودرهای با رزولوشن بسیار باال و الگوريتمهای کنترلی پیشرفته، قادر است تغییرات بار ناگهانی را با کمترين تأخیر و بیشترين پايداری جبران کند. در کاربرد چرخ جانبی برای عبور از ناهمترازی، اين ويژگی باعث میشود فرآيند باال رفتن از مانع بهصورت کامالً کنترلشده و بدون ضربه های مکانیکی شديد انجام شود.

يکی از مزايای مهم سری -Sigma،7 کاهش محسوس ارتعاشات و نويز مکانیکی در سرعتهای پايین و گشتاورهای باال است. اين ويژگی در لحظه تماس چرخ جانبی با لبه مانع، نقش کلیدی در افزايش عمر قطعات مکانیکی و جلوگیری از تنش های ناخواسته ايفا میکند. از ديدگاه مهندسی سیستم، استفاده از چنین سروويی باعث میشود رفتار واقعی سیستم به مدل تئوريک طراحی شده بسیار نزديک باشد.

اگرچه سرووموتورهای -Sigma Yaskawa7 از نظر هزينه در رده باالتری نسبت به ساير گزينهها قرار دارند، اما از منظر قابلیت اطمینان، دقت عملکرد و پايداری بلندمدت، يکی از بهترين انتخابها برای کاربردهای بحرانی و حرفهای محسوب میشوند و میتوانند گزينه مرجع برای انتخاب نهايی در اين پروژه باشند.

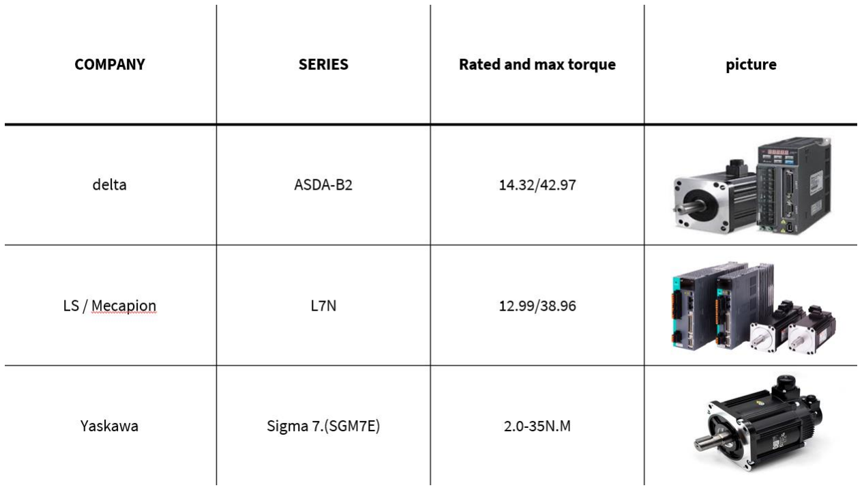
[picture p75: figure]

تصوير 2-۶ لیست سررو های مورد نظر

### 2-۶ .انتخاب و تحلیل سنسورهای مورد استفاده در سیستم

در اين پروژه، سنسورها بهمنظور تأمین اطالعات ضروری برای کنترل حرکت، تشخیص موانع و افزايش ايمنی عملکرد سیستم انتخاب شدهاند. ترکیب سنسورهای موقعیتی و محیطی به سیستم اجازه میدهد تا هم از وضعیت داخلی خود )موقعیت و جابجايی( و هم از شرايط مسیر حرکت آگاهی داشته باشد. در ادامه، سنسورهای مورد استفاده بهصورت مجزا معرفی میشوند.

### 2-۶-1 .سنسور موقعیت يابی

انکودر موقعیت به عنوان اصلیترين سنسور بازخورد حرکتی در سیستم، وظیفه اندازهگیری جابجايی زاويه ای و موقعیت نسبی اجزای متحرک را بر عهده دارد. اطالعات استخراج شده از اين سنسور بهطور مستقیم در حلقه بسته کنترل موقعیت و سرعت مورد استفاده قرار میگیرد و نقش کلیدی در دستیابی به حرکت دقیق و تکرارپذير سیستم ايفا میکند.

استفاده از انکودر در اين پروژه امکان پايش دقیق حرکت چرخ ها و محرکها را فراهم کرده و موجب میشود خطاهای ناشی از لغزش، تغییر بار يا اغتشاشات مکانیکی تا حد امکان جبران شوند. اين سنسور مبنای اصلی تحلیل های کنترلی و محاسبات موقعیتی سیستم محسوب میشود.

سنسور انکودر به عنوان منبع اصلی بازخورد موقعیتی سیستم، نقش تعیینکنندهای در دستیابی به دقت حرکتی مورد نیاز پروژه دارد. در اين بخش، دقت قابل دستیابی سیستم انکودر–چرخ بر اساس مشخصات مکانیکی و رزولوشن انکودر مورد تحلیل قرار میگیرد تا انطباق آن با نیازهای طراحی بررسی شود.

دقت مورد نیاز سیستم

دقت مطلوب برای اندازهگیری جابجايی خطی سیستم برابر با:

Desired Accuracy=1 mm | 2-۴8
محاسبه محیط چرخ

با فرض قطر چرخ برابر با mm 60=D، محیط چرخ از رابطه زير محاسبه میشود:

C=3.14×60=188.5 mm | 2-۴9
رزولوشن انکودر و تعداد پالسها

انکودر مورد استفاده دارای:

PPR=120 slots | 2-۵0

و نسبت تبديل کل سیستم برابر با:

Ntotal=25.3 | 2-۵1

بنابراين، تعداد کل پالسها به ازای يک دور کامل چرخ برابر است با:

2-۵2 Total Pulses per Wheel Revolution=PPR×Ntotal =120×25.3=3036 pulses

محاسبه رزولوشن خطی سیستم

رزولوشن خطی سیستم، که نشاندهنده میزان جابجايی خطی متناظر با هر پالس انکودر است، از رابطه زير به دست میآيد:

Resolution= Circumference/Total Pulses | 2-۵۳
=188.5/3036=0.062 mm
محاسبه ضريب اطمینان دقت

برای بررسی کفايت دقت سیستم نسبت به نیاز طراحی، ضريب اطمینان دقت بهصورت زير تعريف میشود:

2-۵۴

S.F= Desired Accuracy/Achieved Resolution =1.0/0.062=16.1

نتیجهگیری

نتايج محاسبات نشان میدهد که رزولوشن خطی سیستم انکودر– چرخ برابر با 0٫0۶2 میلیمتر است که بهطور قابل توجهی دقیقتر از دقت مورد نیاز طراحی )1 میلیمتر( میباشد. ضريب اطمینان دقت بهدستآمده برابر با 1۶٫1 بوده که نشاندهنده حاشیه ايمنی بسیار مناسب در اندازهگیری موقعیت است.

بنابراين، انکودر انتخاب شده نهتنها نیازهای دقت سیستم را برآورده میکند، بلکه از منظر مهندسی، ظرفیت کافی برای جبران خطاهای ناشی از لغزش، نويز اندازهگیری و اغتشاشات مکانیکی را نیز فراهم میسازد.

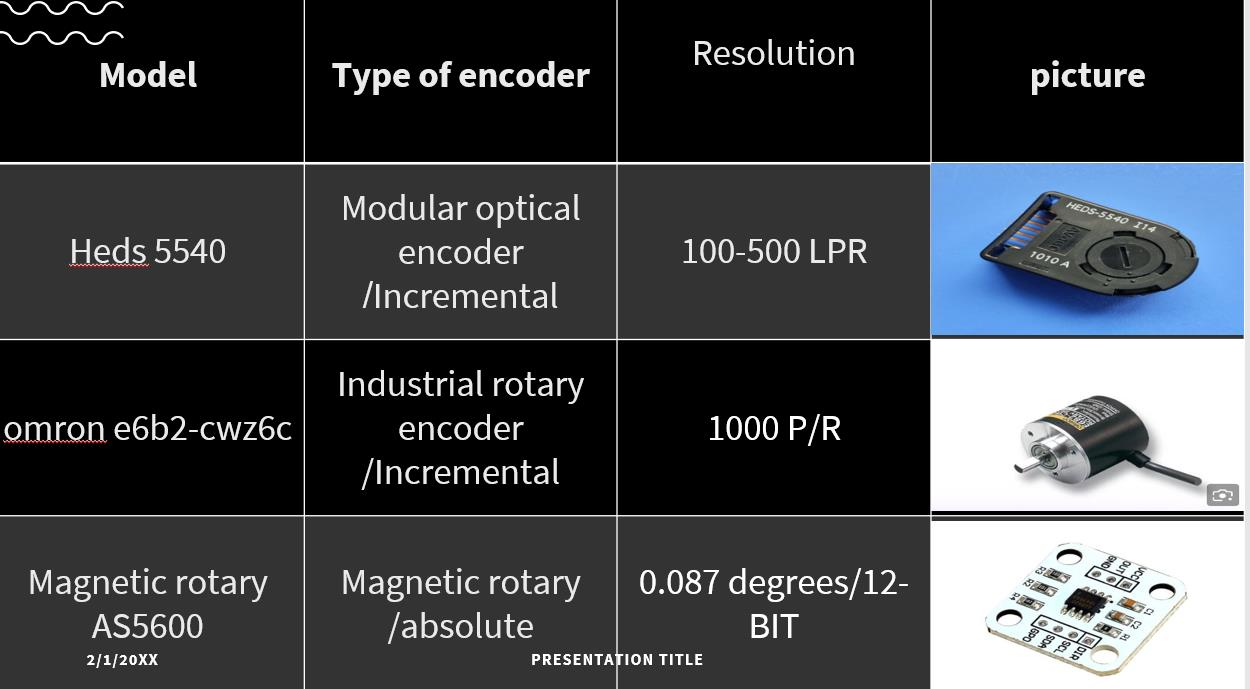
[picture p76: figure]

شکل 2-7 تصوير انکودر های انتخابی

### 2-۶-2 .سنسور تشخیص پله و اختالف سطح ) اولترا سونی ک(

سنسور اولتراسونیک برای تشخیص تغییرات ناگهانی ارتفاع، پلهها و موانع پیشرو در مسیر حرکت سیستم مورد استفاده قرار گرفته است. اين سنسور با اندازهگیری فاصله تا سطح مقابل، امکان شناسايی اختالف سطح را پیش از تماس مستقیم مکانیکی فراهم میکند.

نقش اصلی اين سنسور در سیستم، ايجاد آگاهی پیشدستانه نسبت به موانع ارتفاعی است تا کنترلکننده بتواند پیش از رسیدن چرخ ها به مانع، استراتژی حرکتی مناسب را فعال کند. به اين ترتیب، خطر ضربههای ناگهانی، تنشهای مکانیکی و ناپايداری حرکتی کاهش میيابد.

اختالف ارتفاع پله نسبت به موقعیت نصب سنسور از رابطه زير محاسبه میشود:

Δh=dmeasured−Hmount | 2-۵۵

که در آن dmeasured فاصله اندازهگیریشده توسط سنسور و Hmount ارتفاع نصب سنسور از سطح مرجع است.

تحلیل ناحیه پوشش پرتو اولتراسونیک

با توجه به زاويه پخش پرتو سنسور اولتراسونیک، عرض ناحیه پوششيافته پرتو روی سطح زمین از رابطه زير به دست میآيد:

W=2×Hmount×tan(θ/2) | 2-۵۶

با فرض:

2-۵7 =15∘ Hmount=50 mm,θ

داريم:

)≈13.1 mm | 2-۵8 7.5∘ W=2×50×tan(
اين مقدار نشان میدهد که سنسور قادر است تغییرات ارتفاع را در يک ناحیه نسبتاً متمرکز تشخیص دهد که برای شناسايی لبه پلهها مناسب است.

تحلیل دقت و ضريب اطمینان تشخیص پله

برای بررسی قابلیت تشخیص حداقل اختالف ارتفاع مورد نیاز، ضريب اطمینان تشخیص به صورت زير تعريف میشود:

S.F=Δhmin/R+N | 2-۵9

که در آن:

Δhmin حداقل ارتفاع پله مورد انتظار،

R رزولوشن سنسور،

N میزان نويز اندازهگیری است.

با فرض:

Δhmin=10 mm,R=3 mm,N=1 mm | 2-۶0
خواهیم داشت:
S.F=10/3+1=10/4=2.5 | 2-۶1
نتیجهگیری

نتايج بهدستآمده نشان میدهد که سنسور اولتراسونیک انتخابشده قادر است اختالف ارتفاعهای حداقل 10 میلیمتر را با ضريب اطمینان 2٫۵ تشخیص دهد. اين مقدار بیانگر کفايت دقت و پايداری عملکرد سنسور در مواجهه با نويز و محدوديتهای ذاتی اندازهگیری است و استفاده از اين سنسور را برای تشخیص پله و موانع ارتفاعی در سیستم توجیهپذير میسازد.


شکل 2-8 لیست سنسور های التراسونیک پیشنهادی

### 2-۶-۳ .سنسور تشخیص لبه)سنسور نوری(

سنسور مادون قرمز )IR )بهمنظور تشخیص لبه ها، انتهای مسیر و نواحی فاقد سطح پشتیبان در سیستم به کار گرفته شده است. اين سنسور با تحلیل بازتاب يا عدم بازتاب پرتو مادون قرمز از سطح مقابل، قادر به شناسايی شرايطی نظیر لبه پله، شکاف يا سقوط احتمالی است.

کاربرد اصلی سنسور IR در اين پروژه، خطرناکايش ايمنی حرکتی سیستم و جلوگیری از ورود ناخواسته به نواحی خطرناک است. اين سنسور بهعنوان يک اليه حفاظتی مکمل در کنار سنسور اولتراسونیک عمل کرده و اطالعات کیفی مهمی را برای تصمیمگیریهای کنترلی فراهم میسازد.

مشخصات کلیدی سیستم به شرح زير در نظر گرفته شده است:

زمان پاسخ مطلوب:

Tdesired<5 ms | 2-۶2
سرعت حرکت ربات:
v=10 m/min=166.7 mm/s | 2-۶۳
فاصله نصب سنسور از لبه ايمن:
Xs=50 mm | 2-۶۴
فرکانس مدوالسیون نوری:
f=38 kHz | 2-۶۵
تحلیل زمان واکنش سیستم

زمان واکنش کل سیستم از مجموع تأخیر اجزای مختلف تشکیل میشود:

Treact=Tsensor+TMCU+Tdriver | 2-۶۶
با فرض:

2-۶7

Tsensor = 1ms
TMCU = 1ms

Tdriver = 2ms
محاسبه فاصله واکنش:

فاصلهای که سیستم در مدت زمان واکنش طی میکند از رابطه زير محاسبه میشود:

Dreact=v×Treact = 166.7×0.004=0.67 mm | 2-۶8
محاسبه فاصله ترمز:

با فرض شتاب ترمزگیری ثابت به مقدار:

2-۶9 mm/s²
a=1000
و استفاده از معادله حرکت يکنواخت شتاب دار:
=2adbrake | 2-70 ² −v0

2
v
با قرار دادن:

2-71 mm/s²
v=0, v0=166.7 mm/s a=−1000
dbrake=13.89 mm | 2-72

محاسبه فاصله توقف کل:

فاصله توقف کل سیستم برابر است با مجموع فاصله واکنش و فاصله ترمز:

Dstop=Dreact+dbrake=14.56mm | 2-7۳
تحلیل ضريب اطمینان مکانیکی

برای ارزيابی ايمنی مکانیکی سیستم در تشخیص لبه، ضريب اطمینان بهصورت زير تعريف میشود:

S.Fmechanical= Xs/ Dstop =3.43 | 2-7۴

تحلیل ايمنی نوری

به منظور کاهش اثر نور محیط و افزايش نسبت سیگنال به نويز، سنسور IR با مدوالسیون فرکانسی ۳8 کیلوهرتز بهکار گرفته شده است. اين روش موجب افزايش قابلتوجه Ratio Noise-to-Signal شده و ضريب اطمینان نوری سیستم را در حدود:

S.Foptical≈100 | 2-7۵
قرار میدهد که نشاندهنده پايداری بسیار باالی تشخیص در شرايط نوری مختلف است.

نتیجهگیری

نتايج تحلیل نشان میدهد که سیستم تشخیص لبه مبتنی بر سنسور IR، با فاصله توقف کل 1۴٫۵۶ میلیمتر و ضريب اطمینان مکانیکی ،۳٫۴۳ از حاشیه ايمنی مناسبی برخوردار است. همچنین، استفاده از مدوالسیون نوری ۳8 کیلوهرتز موجب افزايش چشمگیر ايمنی نوری و کاهش حساسیت به نويز محیطی شده است.

در نتیجه، سنسور IR انتخابشده بهطور کامل الزامات ايمنی، سرعت پاسخ و قابلیت اطمینان مورد نیاز سیستم را برآورده میسازد.

### 2-۶-۴ .مقايسه و انتخاب سنسورهای تشخیص لبه)Sensors Optical / IR)

با توجه به اهمیت تشخیص دقیق و قابلاعتماد لبهها و پرتگاهها در ايمنی حرکتی سیستم، چندين فناوری سنسور نوری مورد بررسی و مقايسه قرار گرفت. هدف از اين مقايسه، انتخاب سنسوری با توازن مناسب میان دقت، سرعت پاسخ، پايداری در شرايط محیطی، پیچیدگی يکپارچهسازی و هزينه بوده است. جدول ارائهشده، خالصهای از سنسورهای منتخب در چهار رده عملکردی مختلف را نشان میدهد.

– E18-D80NK (Modulated IR) | اقتصادی | سنسور

سنسور NK80D18-Eبه عنوان يک گزينه اقتصادی و پرکاربرد مبتنی بر مادونقرمز مدولهشده انتخاب شده است. استفاده از مدوالسیون نوری )معموالً در حوالی ۳8 کیلوهرتز( باعث افزايش ايمنی در برابر نور محیط و کاهش تداخل نوری میشود. اين سنسور با ساختار ساده، خروجی ديجیتال و نصب آسان، گزينهای مناسب برای کاربردهای عمومی تشخیص لبه با هزينه پايین محسوب میشود و برای پروژههايی با محدوديت بودجه، انتخابی منطقی است.

– Sharp GP2Y0D810Z0F (Optical Triangulation)باال | دقت با | سنسور

سنسور F0Z810D0Y2GP Sharpاز فناوری مثلث بندی نوری (Triangulation Optical (بهره میبرد که دقت تشخیص فاصله باالتری نسبت به سنسورهای IR ساده فراهم میکند. اين نوع سنسورها نسبت به تغییرات بازتاب سطح حساستر بوده و دقت مکانيابی بهتری در فاصلههای کوتاه ارائه میدهند. اين ويژگی، آن را به گزينهای مناسب برای کاربردهايی با نیاز به دقت باالتر در تشخیص لبه و اختالف سطح تبديل میکند.

– VL53L0X / VL53L1X (Time-of-Flight) | پیشرفته | و | دقیق | فوق | سنسور

سنسورهای X0L53VLو X1L53VLمبتنی بر فناوری (ToF (Flight-of-Timeهستند که با اندازهگیری زمان پرواز پالس نوری، فاصله را با دقت بسیار باال محاسبه میکنند. اين سنسورها در برابر نور محیط عملکرد پايداری داشته و دقت میلیمتری ارائه میدهند. اگرچه پیچیدگی نرمافزاری و هزينه اين سنسورها باالتر است، اما برای کاربردهای پیشرفته، تحقیقاتی يا صنعتی با الزامات دقت بسیار باال، گزينهای ايدهآل محسوب میشوند.

– Omron E3F3 (Industrial Photoelectric) | مقاوم | و | صنعتی | سنسور

سنسور 3F3E Omronبه عنوان يک سنسور فتوالکتريک صنعتی برای محیطهای کاری سخت، ارتعاشدار و آلوده طراحی شده است. اين سنسور از نظر دوام مکانیکی، پايداری عملکرد و عمر کاری در سطح صنعتی قرار دارد و برای کاربردهای طوالنیمدت و صنعتی بسیار مناسب است. اگرچه هزينه و ابعاد آن نسبت به گزينههای ديگر بیشتر است، اما قابلیت اطمینان باالی آن در شرايط سخت، اين هزينه را توجیه پذير میسازد

جمعبندی انتخاب

با توجه به تحلیلهای انجامشده، سنسور IR مدولهشده )مانند NK80D18-E )به عنوان گزينه اصلی پروژه انتخاب شده است، زيرا:

- زمان پاسخ آن با الزامات ايمنی سیستم همخوانی دارد،
- ايمنی نوری مناسبی در برابر نور محیط ارائه میدهد،
- پیچیدگی پیادهسازی پايین و هزينه مناسبی دارد.

در عین حال، جدول مقايسه نشان میدهد که در صورت تغییر سطح نیازمندیها )افزايش دقت يا شرايط صنعتی سخت(، گزينههای جايگزين با فناوریهای پیشرفته تر نیز قابل استفاده خواهند بود.

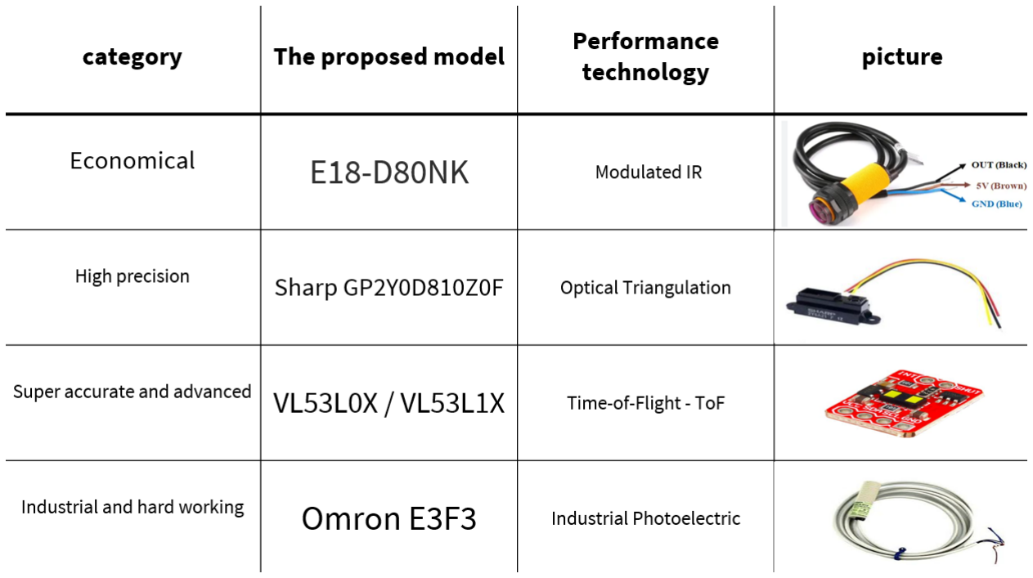
[picture p77: figure]

شکل-2 9 سنوسر های نوری

### -۶-۴ -2سامانه بینايی و عمق يابی مبتنی بر دوربینMini ZED :

به منظور ارتقای قابلیت ادراک محیطی سیستم و فراهمسازی اطالعات فضايی فراتر از تشخیص نقطهای سنسورهای نوری، از دوربین استريو Mini ZED به عنوان سامانه بینايی ماشین و عمقيابی سهبعدی استفاده شده است. اين دوربین با بهرهگیری از بینايی استريو، امکان استخراج نقشه عمق و بازسازی سه بعدی محیط اطراف ربات را بهصورت همزمان فراهم میکند .

معرفی فنیMini ZED

به منظور ارتقای سطح ادراک محیطی سیستم و غلبه بر محدوديتهای ذاتی سنسورهای نقطه ای، از دوربین استريو Mini ZED بهعنوان سامانه بینايی ماشین و عمق يابی سهبعدی استفاده شده است. اين دوربین با بهرهگیری از دو حسگر تصويری همزمان، امکان استخراج نقشه عمق پیوسته از محیط را از طريق محاسبه اختالف ديد میان تصاوير فراهم میسازد و بدين ترتیب اطالعات فضايی سه بعدی از سطوح، لبهها و اختالف ارتفاعها در اختیار سیستم کنترلی قرار میدهد. برخالف سنسورهای مادونقرمز يا ToF که صرفاً در يک نقطه يا راستای محدود اندازهگیری انجام میدهند، Mini ZED قادر است ساختار کلی محیط را در میدان ديد وسیعتری تحلیل نمايد.

در کاربرد حاضر، ربات با محیطی شامل پنلهای متوالی، تغییرات ارتفاع، لبهها و ناهنجاریهای سطحی مواجه است که تشخیص آن ها تنها با اتکا به سنسورهای موضعی میتواند منجر به تصمیمگیری های واکنشی و بعضاً ناپايدار شود. دوربین Mini ZED اين امکان را فراهم میکند که اختالف ارتفاع پنلها، شیب سطح و وجود لبه ها در فاصلهای پیش از رسیدن ربات به ناحیه بحرانی شناسايی شوند و بدين ترتیب تصمیمگیری ها از حالت صرفاً واکنشی به سطحی پیشبینانه ارتقا يابد. اين ويژگی بهويژه در افزايش ايمنی حرکت و پايداری عملکرد سیستم در سرعتهای باالتر نقش کلیدی ايفا میکند.

در معماری حسگری پیشنهادی، Mini ZED بهعنوان يک سنسور سطح باال در اليه ادراک سیستم عمل میکند، در حالی که سنسورهای مادونقرمز، ToF و انکودرهای حرکتی نقش سنسورهای سطح پايین و ايمنی را بر عهده دارند. دادههای عمق و تصوير استخراج شده از دوربین، برای تحلیل کلی محیط و شناسايی ساختارهای هندسی مورد استفاده قرار میگیرند، در حالی که سنسورهای نوری موضعی با زمان پاسخ بسیار کوتاه، تشخیص نهايی لبهها و شرايط بحرانی را در فاصله نزديک انجام میدهند. انکودرها نیز با تأمین اطالعات دقیق موقعیت و سرعت، همزمانسازی دادههای حرکتی با دادههای بینايی را ممکن میسازند.

ترکیب دادههای حاصل از Mini ZED با خروجی سنسورهای نوری و حرکتی، يک چارچوب Fusion Sensor چنداليه ايجاد میکند که منجر به افزايش دقت، قابلیت اطمینان و ايمنی سیستم میشود. در اين چارچوب، دوربین استريو وظیفه تشخیص زودهنگام و تحلیل پیوسته محیط را بر عهده دارد، در حالی که سنسورهای نقطه ای بهعنوان اليه افزونه ايمنی، صحت تشخیص را در ناحیه نزديک تأيید میکنند و در صورت بروز اختالل در پردازش تصوير يا شرايط نوری نامناسب، امکان واکنش مستقل و سريع را فراهم میسازند. اين افزونگی عملکردی، ريسک خطاهای ادراکی را به طور قابلتوجهی کاهش میدهد.

در مجموع، استفاده از دوربین Mini ZED در کنار سنسورهای IR، ToF و انکودرها، يک سامانه ادراکی ترکیبی و مقیاسپذير ايجاد میکند که ضمن پوشش نیازهای فعلی پروژه، بستر مناسبی برای توسعه الگوريتم های پیشرفتهتر پردازش تصوير، تصمیمگیری هوشمند و ارتقای سیستم به سطوح باالتر خودکارسازی در آينده فراهم میسازد.

### 2-۶-۶ .انتخاب و تحلیل واحد پردازش مرکزی)۳2ESP ):

به منظور پیادهسازی واحد پردازش مرکزی سیستم کنترلی و حسگری، از ريزکنترل گر 32ESP استفاده شده است. انتخاب اين پردازنده بر مبنای الزامات پروژه شامل پردازش همزمان دادههای چندسنسوره، ارتباط بالدرنگ با سامانههای ادراکی، پاسخدهی سريع به شرايط ايمنی و قابلیت توسعه پذيری نرمافزاری صورت گرفته است. 32ESP با برخورداری از معماری دوهستهای، فرکانس کاری باال و پشتیبانی ذاتی از پروتکلهای ارتباطی متنوع، بستری مناسب برای يک سامانه رباتیکی چنداليه فراهم میکند.

در معماری پیشنهادی، 32ESP نقش واحد پردازش سطح پايین و بالدرنگ را بر عهده دارد. دادههای سنسورهای موضعی شامل سنسورهای مادونقرمز تشخیص لبه، سنسورهای ToF و انکودرهای حرکتی، مستقیماً به 32ESP متصل شده و با تأخیر بسیار کم پردازش میشوند. اين امر امکان پیادهسازی منطقهای ايمنی، توقف اضطراری، اصالح همراستايی و کنترل حرکت را بدون وابستگی به سامانه پردازش تصوير فراهم میسازد. وجود وقفههای سخت افزاری، تايمرهای دقیق و واحدهای PWM داخلی، کنترل دقیق محرکها و واکنش آنی به شرايط بحرانی را ممکن میکند.

از سوی ديگر، 32ESP به عنوان واسط ارتباطی میان اليه ادراک سطح باال و اليه کنترلی عمل میکند. دادههای پردازششده حاصل از دوربین استريو Mini ZED که معموالً روی يک پردازنده قدرتمندتر يا سیستم جانبی پردازش میشوند، از طريق ارتباط سريال يا شبکهای به 32ESP منتقل شده و در تصمیمگیریهای حرکتی لحاظ میگردند. بدين ترتیب، پردازشهای سنگین بینايی از وظايف بالدرنگ جدا شده و پايداری زمانی سیستم تضمین میشود.

يکی از مزيت های کلیدی 32ESP، پشتیبانی همزمان از UART، C2I، SPI، PWM و ADC در کنار توان پردازشی کافی است که امکان اتصال همزمان چندين سنسور ناهمگون را بدون نیاز به سخت افزار واسط اضافی فراهم میسازد. اين ويژگی، پیچیدگی سخت افزاری سیستم را کاهش داده و قابلیت اطمینان کلی را افزايش میدهد. عالوه بر اين، قابلیت اجرای سیستم عامل بالدرنگ )FreeRTOS )بر روی 32ESP، پیادهسازی معماری نرمافزاری چندوظیفه ای را امکانپذير میسازد که در آن وظايف حسگری، کنترلی و ارتباطی بهصورت مستقل و همزمان اجرا میشوند.

در مقايسه با گزينههای رايج ديگر، مانند Uno Arduino يا Mega، 32ESP از نظر توان پردازشی، حافظه، قابلیت چندوظیفه ای و سرعت ارتباطی برتری محسوسی دارد و محدوديتهای اين بردها در مديريت دادههای چندسنسوره را برطرف میکند. در مقابل ريزپردازندههايی نظیر Pi Raspberry، 32ESP با مصرف توان کمتر، زمان پاسخ قطعیتر و عدم وابستگی به سیستم عاملهای غیر بالدرنگ، برای وظايف کنترلی و ايمنی گزينهای مناسبتر محسوب میشود. همچنین در مقايسه با برخی میکروکنترلرهای صنعتی، 32ESP تعادل بهینهای میان هزينه، دسترس پذيری، توان پردازشی و انعطافپذيری ارائه میدهد که با ماهیت پژوهشی–کاربردی اين پروژه همخوانی دارد.

در مجموع، استفاده از 32ESP بهعنوان واحد پردازش مرکزی، امکان پیادهسازی يک معماری کنترلی پايدار، مقیاسپذير و ايمن را فراهم کرده است که بهطور مؤثر دادههای سنسورهای موضعی را پردازش نموده، با سامانه بینايی Mini ZED همافزايی داشته و نیازهای کنونی و توسعه های آتی سیستم رباتیکی را بهخوبی پوشش میدهد.


شکل 2-10تصوير بلوک دياگرام فعالیت های ربات

# بخش ۳ : شبیه سازی

### -۳-1مقدمه :

به منظور ارزيابی صحت نتايج حاصل از مراحل طراحی مفهومی، تحلیل دينامیکی و سايزينگ اجزای سیستم، شبیهسازی بهعنوان يک ابزار کلیدی در اين پژوهش مورد استفاده قرار گرفته است. شبیهسازی امکان بررسی رفتار سیستم در شرايط مختلف کاری را پیش از پیادهسازی عملی فراهم میسازد و نقش مهمی در کاهش ريسک های طراحی و افزايش قابلیت اطمینان عملکرد دارد. در اين فصل، مدل ارائه شده در فصل قبل از دو منظر مکمل مورد تحلیل قرار میگیرد: شبیهسازی تحلیلی–کنترلی و شبیهسازی فیزيکی– سه بعدی.

در بخش نخست، با استفاده از محیط MATLAB، مدل دينامیکی سیستم استخراج شده و عملکرد محرک ها، سیستم انتقال قدرت و الگوريتمهای کنترلی در سناريوهای مختلف مورد بررسی قرار میگیرد. اين شبیهسازی امکان تحلیل پاسخ زمانی، رفتار گذرا، شرايط بدترين حالت و تطابق نقطه کاری موتور با مقادير طراحیشده را فراهم میسازد. در بخش دوم، شبیه سازی سه بعدی با هدف بررسی تعامل فیزيکی ربات با محیط، شامل عبور از موانع، اختالف ارتفاع پنلها و اصالح ناهمراستايی انجام میشود. ترکیب اين دو رويکرد شبیه سازی، يک اعتبارسنجی جامع و چنداليه از عملکرد سیستم ارائه داده و مبنای اطمینانی برای ورود به مرحله ساخت و آزمايش عملی فراهم میکند.

### -۳-2 شبیه سازی و طراحی سه بعدی در سالیدورک:

به منظور بررسی رفتار فیزيکی و حرکتی ربات در شرايط واقعی بهرهبرداری، شبیه سازی سهبعدی سیستم با استفاده از نرمافزار SolidWorks انجام شده است. در اين مرحله، مدل کامل ربات بهصورت اسمبلی سه بعدی شامل کلیه اجزای مکانیکی، محرکها و زيرسامانههای عملکردی ايجاد گرديد تا امکان تحلیل تعامل بین اجزا و محیط فراهم شود. استفاده از شبیه سازی سه بعدی اين امکان را فراهم میسازد که عالوه بر ارزيابی سینماتیکی و دينامیکی حرکت، اثرات هندسی، توزيع جرم، قیود حرکتی و تماسهای مکانیکی نیز بهصورت واقعگرايانه مورد بررسی قرار گیرند.

مدل سه بعدی ارائه شده شامل بدنه اصلی، سیستم حرکتی، مکانیزمهای جانبی و اجزای عملیاتی ربات است که به صورت ماژوالر طراحی شدهاند. اين رويکرد ماژوالر عالوه بر تسهیل فرآيند مونتاژ و توسعه، امکان تعريف دقیق قیود حرکتی و شبیه سازی سناريوهای مختلف کاری را فراهم میکند. همچنین، با اختصاص خواص فیزيکی نظیر جرم، مرکز جرم و اينرسی به هر يک از اجزا، مدل شبیه سازی شده قابلیت بازنمايی رفتار واقعی سیستم را دارا بوده و مبنای مناسبی برای اعتبارسنجی نتايج تحلیلهای انجامشده در فصل طراحی و سايزينگ فراهم مینمايد.

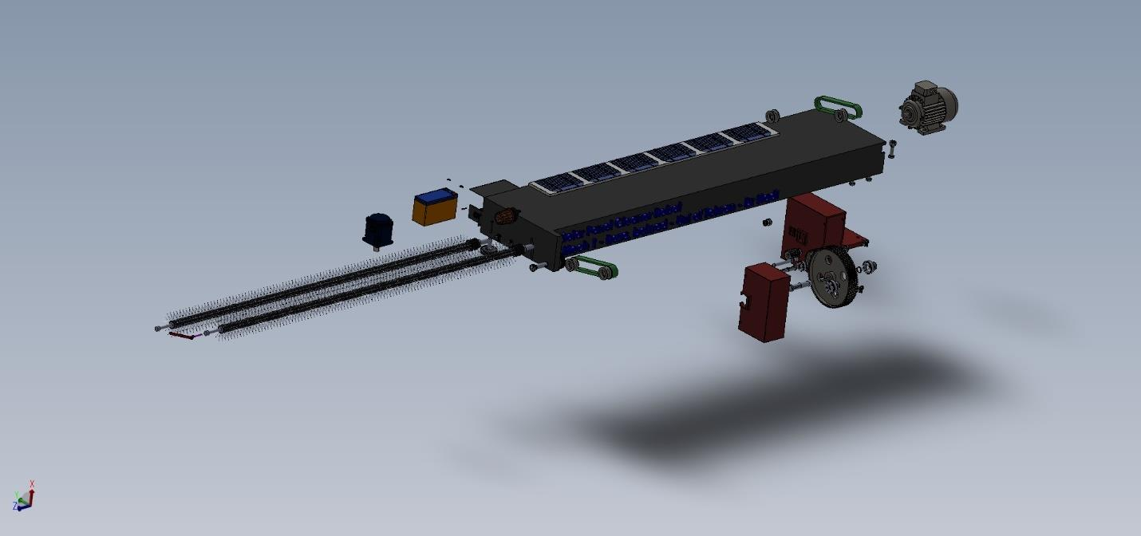
[picture p78: figure]

شکل 1-۳ طراحی سه بعدی ربات

### -۳-2-1 تحلیل مکانیزم پولی– تسمه تنظیم ارتفاع برس:

در طراحی مکانیزم برس تمیزکاری، از يک سامانه پولی–تسمه بهمنظور کنترل موقعیت عمودی يکی از برس های هرزگرد استفاده شده است. اين مکانیزم نقش کلیدی در جلوگیری از دررفتگی برس در شرايط تغییر جهت حرکت )رفت و برگشت( و همچنین تنظیم يکنواخت نیروی تماس برس با سطح ايفا میکند. با اعمال جابهجايی کنترلشده به پولی متحرک، امکان باال آوردن يا پايین بردن برس هرزگرد فراهم شده و بدين ترتیب، تنش وارد بر تسمه و برس در محدوده مجاز نگه داشته میشود.

مدلسازی سینماتیکی مکانیزم

شعاع پولی:

rp=20 mm=0.02 m | 1-۳
جابهجايی عمودی:
Δh=rp⋅Δθ=0.02×2π≈0.0314 m | 2-۳
گشتاور موردنیاز روی شفت پولی
Tp=Fdesign×rp= 50×0.02=1.0 N | 3-3
لحاظ راندمان تسمه–پولی
Tmotor=0.88 N.M / Ngear1=4.3 | ۴-۳

گشتاور مورد نیاز برای برس :

Tp=Fbrush×rp=25×0.02=0.5N,S.F=6.43 | 5-3
Tdesign=0.5×6.43/0.85≈3.78N.m | 6-3

اين نتیجه بیانگر آن است که با در نظر گرفتن اثر تقويت گشتاور ناشی از گیربکس، موتور انتخابشده نهتنها توانايی تأمین گشتاور مورد نیاز مکانیزم تنظیم برس را دارد، بلکه از حاشیه ايمنی مناسبی نیز برخوردار است. در نتیجه، عملکرد پايدار مکانیزم در شرايط کاری مختلف و در سیکلهای رفت و برگشت حرکت ربات تضمین میشود.

### -2-2 -۳تحلیل انتخاب آرايش خروجی گیربکس و تخصیص آن به مکانیزم برس

مطابق با تحلیلهای ارائهشده در بخشهای پیشین، سیستم انتقال قدرت ربات بهگونه ای طراحی شده است که يک موتور الکتريکی از طريق يک مجموعه چرخ دنده چندمرحله ای، توان و گشتاور موردنیاز دو زيرسیستم اصلی شامل مکانیزم برس تمیزکاری و سامانه حرکتی را تأمین نمايد. در اين راستا، انتخاب محل برداشت توان از گیربکس )خروجی اول يا خروجی دوم( نقش تعیینکنندهای در عملکرد نهايی سیستم دارد.

در آرايش نهايی انتخابشده، خروجی مرحله اول گیربکس به مکانیزم برس اختصاص داده شده است. دلیل اصلی اين انتخاب آن است که در صورت اتصال برس به خروجی مرحله دوم گیربکس، بهدلیل افزايش بیشازحد نسبت کاهش دور، سرعت زاويهای برس بهشدت کاهش يافته و عمالً به مقاديری میرسد که برای فرآيند تمیزکاری مؤثر کافی نخواهد بود. در چنین شرايطی، اگرچه گشتاور بااليی در اختیار برس قرار میگیرد، اما سرعت دورانی پايین باعث کاهش انرژی جنبشی تماس برس با سطح پنل شده و کارايی فرآيند پاکسازی بهطور محسوسی افت میکند.

در مقابل، با تخصیص خروجی مرحله اول گیربکس به برس، سرعت دورانی مناسبتری در محور برس حاصل میشود. اين موضوع بهويژه در شرايط کاری تعريف شده برای ربات، يعنی تمیزکاری در حالت خشک، اهمیت بااليی دارد. در حالت خشک، بهدلیل عدم حضور سیال و کاهش نیروهای مقاوم هیدرودينامیکی، نیاز اصلی فرآيند تمیزکاری، تأمین سرعت دورانی کافی برس برای جداسازی ذرات گردوغبار از سطح پنل است. آرايش انتخابشده اين امکان را فراهم میکند که حتی در سرعت حرکتی ربات در حدود 10 متر بر دقیقه، برس همچنان از سرعت دورانی قابل قبول و مؤثری برخوردار باشد و عملکرد تمیزکاری بدون افت کیفیت انجام شود.

از منظر دينامیکی، اين پیکربندی منجر به ايجاد يک توازن مطلوب بین سرعت دورانی برس و گشتاور در دسترس میشود. بهعبارت ديگر، سیستم بهجای تأمین گشتاور مازاد و غیرضروری برای برس، تمرکز خود را بر حفظ سرعت مناسب تماس قرار میدهد که در کاربرد موردنظر، معیار اصلی کارايی است. اين موضوع نهتنها باعث بهبود عملکرد تمیزکاری میشود، بلکه از اتالف توان و افزايش تنشهای غیرضروری در اجزای مکانیکی نیز جلوگیری میکند.

با توجه به تحلیل های سايزينگ موتور، انتخاب نسبت های چرخدنده و بررسی حاشیههای ايمنی ارائه شده در بخش قبل، میتوان نتیجه گرفت که مجموعه موتور و گیربکس انتخابشده بهعنوان هسته اصلی سیستم محرکه، از پتانسیل کافی برای پاسخگويی

همزمان به نیازهای حرکتی ربات و مکانیزم برس برخوردار است. آرايش خروجیها بهگونهای انجام شده است که هر زيرسیستم در محدوده بهینه عملکرد خود کار کند و اين امر نشاندهنده يک طراحی هدفمند و مبتنی بر نیازهای واقعی کاربرد است.

در مجموع، تخصیص خروجی مرحله اول گیربکس به مکانیزم برس، يک انتخاب مهندسی آگاهانه است که با در نظر گرفتن شرايط کاری، نوع تمیزکاری )خشک(، سرعت حرکتی ربات و الزامات دينامیکی سیستم انجام شده و نقش مهمی در تضمین کارايی، پايداری و قابلیت اطمینان عملکرد ربات ايفا میکند.

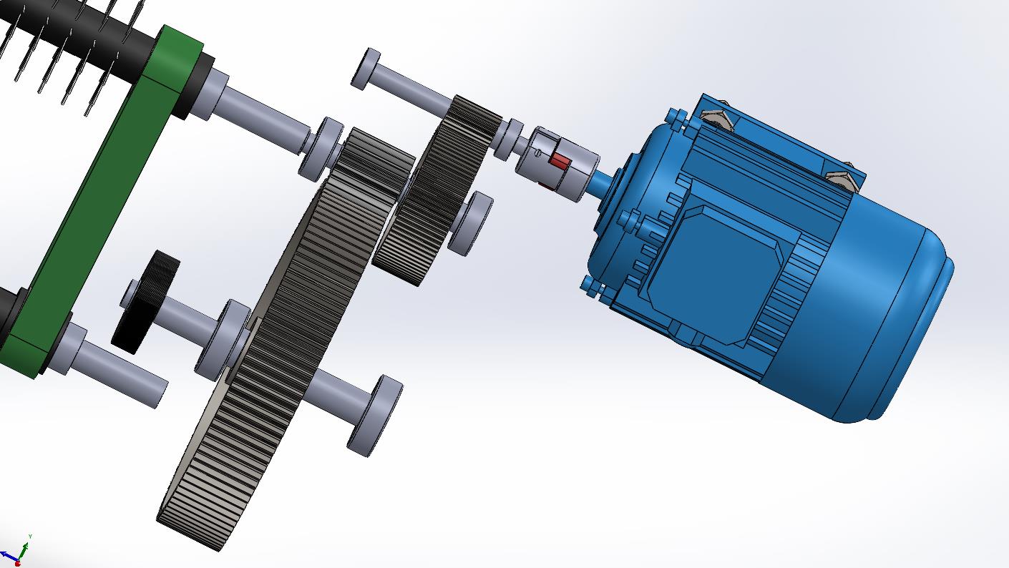
[picture p79: figure]

شکل2-۳ تثوير موتور dc وگیر بکس مورد نظر برای طراحی و خروجی های ان

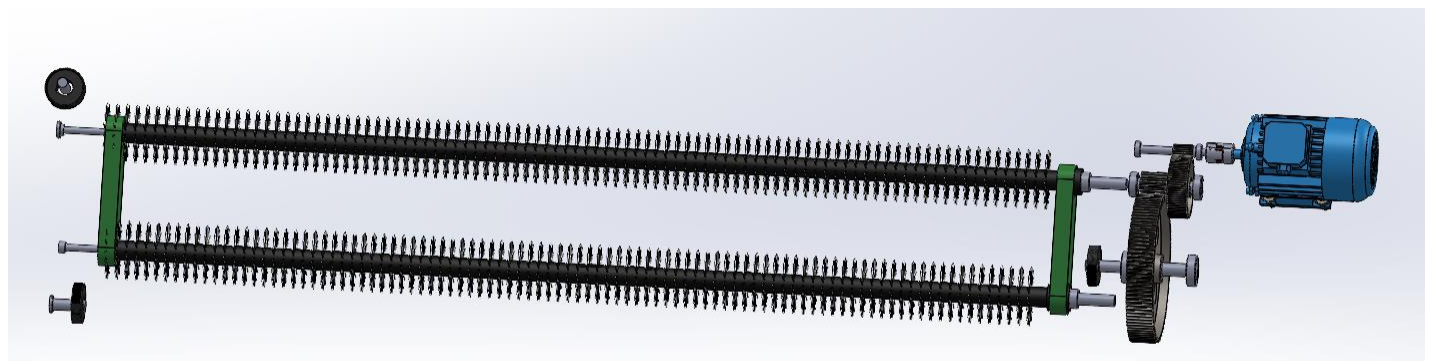
[picture p80: figure]

شکل۳-۳

### -2-۳ -۳تحلیل خواص جرمی اسمبلی ربات تمیزکننده پنل خورشیدی

خواص جرمی اسمبلی نهايی ربات تمیزکننده پنل خورشیدی با استفاده از ابزار Properties Mass در نرمافزار SolidWorks استخراج و تحلیل شده است. اين تحلیل با هدف ارزيابی پايداری دينامیکی سیستم، صحت فرضیات طراحی و اعتبارسنجی نتايج بهدستآمده از مراحل سايزينگ اجزای مکانیکی انجام شده است. بر اساس نتايج حاصل، جرم کل اسمبلی برابر با حدود kg28.01 بهدست آمد که اين مقدار در بازه پیشبینیشده در مرحله طراحی قرار داشته و با توان و گشتاور قابل تأمین توسط موتور و گیربکس انتخابشده سازگاری کامل دارد. اين میزان جرم بهگونه ای است که ضمن ايجاد نیروی نرمال کافی برای حفظ تماس پايدار با سطح پنل، منجر به افزايش بار غیرضروری بر سامانه حرکتی نشده و امکان عبور ايمن از ناپیوستگیها و درزهای بین پنلها را فراهم میکند.

مختصات مرکز جرم سیستم نشان میدهد که بخش عمده جرم ربات در نواحی پايینی شاسی و نزديک به سطح پنل متمرکز شده است، بهطوری که مرکز جرم در راستای عمودی در موقعیتی پايینتر از مرکز هندسی اسمبلی قرار دارد. اين توزيع جرمی باعث کاهش گشتاورهای واژگونی، افزايش پايداری حرکتی و بهبود رفتار دينامیکی ربات بهويژه در حرکت روی سطوح شیبدار يا لغزنده میشود. چنین آرايشی همچنین منجر به يکنواخت تر شدن توزيع نیرو بین چرخ ها و برس تمیزکاری شده و از ايجاد نوسانات ناخواسته در حین حرکت جلوگیری میکند.

تحلیل ممانهای اصلی لختی حول مرکز جرم نشان میدهد که ممان لختی حول محور عمودی سیستم بهمراتب بزرگتر از ممانهای لختی حول دو محور ديگر است. اين ويژگی بیانگر مقاومت باالتر سیستم در برابر دوران ناخواسته حول محور قائم بوده و نقش مهمی در حفظ راستای حرکتی ربات و کاهش انحرافات زاويهای ايفا میکند. چنین رفتاری بهويژه در کاربردهايی که ربات بايد مسیرهای طولی نسبتاً مستقیم را طی کند، از اهمیت بااليی برخوردار است و کنترل سیستم را سادهتر و پايدارتر میسازد.

عالوه بر اين، محاسبه ممانهای لختی حول دستگاه مختصات مرجع اسمبلی امکان استفاده مستقیم از اين داده ها را در شبیه سازی های دينامیکی فراهم میکند. اين اطالعات بهعنوان ورودی مدلهای شبیهسازی حرکتی، برای بررسی پاسخ سیستم در

شرايط شتابگیری، ترمز و عبور از ناپیوستگیهای سطح مورد استفاده قرار میگیرند و نقش کلیدی در پیشبینی رفتار واقعی ربات ايفا میکنند.

در مجموع، نتايج بهدستآمده از تحلیل خواص جرمی نشان میدهد که طراحی انجامشده از نظر جرم کل، توزيع جرم و ويژگیهای اينرسی کامالً منطبق با اهداف عملکردی سیستم است. اين نتايج نهتنها صحت فرضیات به کاررفته در مراحل سايزينگ موتور، گیربکس و مکانیزم برس را تأيید میکنند، بلکه مبنای مناسبی برای ورود به فاز شبیه سازی دينامیکی و تحلیل رفتار حرکتی ربات در شرايط کاری واقعی فراهم میآورند.


Mass Properties ۴-۳شکل

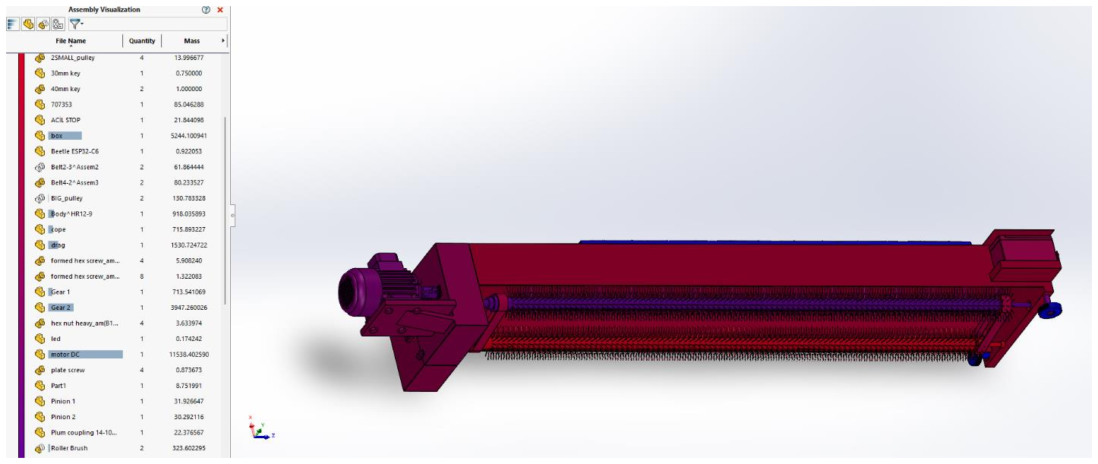
[picture p81: figure]

شکل۵-۳

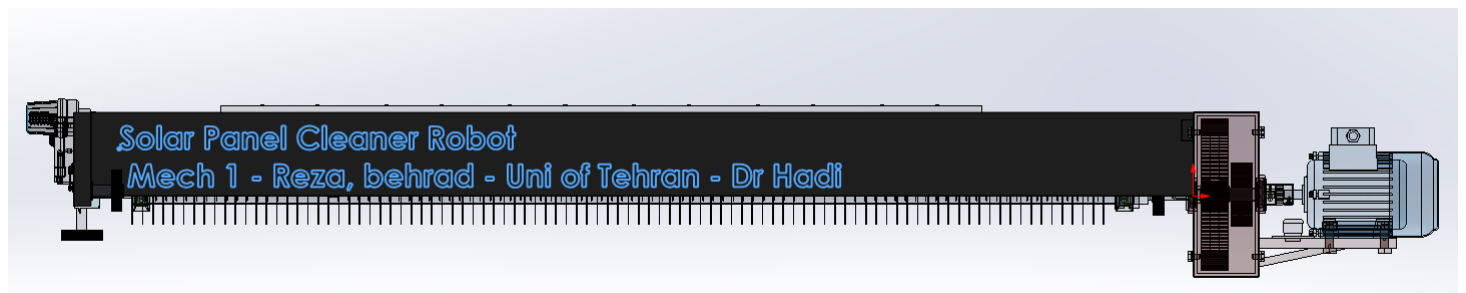
[picture p82: figure]

شکل ۶-۳

### ۳-2-۴مکانیزم چرخ های جانبی برای عبور از عدم همراستايی پنل ها

يکی از چالشهای اساسی در طراحی ربات های تمیزکننده پنل خورشیدی، وجود عدم همراستايی جانبی بین پنلهای مجاور است. اين عدم همراستايی که معموالً به دلیل خطاهای نصب، تلرانسهای سازهای يا تغییرات حرارتی ايجاد میشود، میتواند مانعی جدی برای حرکت پیوسته و پايدار ربات در راستای طولی پنلها باشد. تصاوير ارائهشده، مکانیزم چرخهای جانبی طراحیشده برای حل اين مسئله را نشان میدهند.

در تصوير اول، نمايی واقعی از آرايش پنلهای خورشیدی نمايش داده شده است که در آن اختالف جانبی بین لبههای دو پنل مجاور بهصورت واضح مشخص شده است. اين تصوير نشان میدهد که در برخی موارد، لبه پنل بعدی نسبت به پنل قبلی دارای جابهجايی افقی قابلتوجهی است )در حدود چند ده میلیمتر(. چنین شرايطی، در صورت نبود مکانیزم جبران کننده، میتواند باعث برخورد شاسی ربات با لبه پنل، گیرکردن سیستم حرکتی يا خروج ربات از مسیر حرکتی شود.

در تصوير دوم، مدل سهبعدی مکانیزم پیشنهادی در طراحی حاضر نمايش داده شده است. در اين آرايش، مجموعه ای از چرخ های جانبی هدايتکننده در دو طرف شاسی تعبیه شدهاند که وظیفه آنها، تعامل کنترلی با لبههای جانبی پنلها است. اين چرخها بهگونه ای طراحی شدهاند که در صورت بروز عدم همراستايی، ابتدا با لبه پنل بعدی تماس پیدا کرده و نیروی جانبی الزم را برای اصالح تدريجی موقعیت ربات اعمال کنند. بهاينترتیب، ربات بدون نیاز به توقف کامل يا انجام مانورهای پیچیده کنترلی، قادر به تطبیق مسیر حرکتی خود با موقعیت واقعی پنل بع دی خواهد بود.

از منظر عملکردی، اين مکانیزم نوعی غیرفعال را فراهم میکند. بهعبارت ديگر، اصالح مسیر ربات نه از طريق اعمال فرمان کنترلی مستقیم، بلکه از طريق برهمکنش مکانیکی بین چرخهای جانبی و لبه پنل انجام میشود. اين رويکرد باعث کاهش پیچیدگی سیستم کنترلی، افزايش قابلیت اطمینان و کاهش وابستگی عملکرد ربات به دقت باالی سنسورها میشود.

همچنین، قرارگیری چرخ های جانبی در ارتفاع و موقعیتی کنترلشده نسبت به مرکز جرم ربات، موجب میشود که نیروهای جانبی ايجادشده در فرآيند اصالح مسیر، منجر به ناپايداری يا ايجاد گشتاورهای واژگونی قابلتوجه نشوند. اين موضوع با نتايج تحلیل خواص جرمی و پايین بودن مرکز جرم سیستم همراستا بوده و به حفظ پايداری حرکتی ربات کمک میکند.

در مجموع، مکانیزم چرخهای جانبی ارائهشده، يک راهحل ساده اما مؤثر برای عبور از ناپیوستگیها و عدم همراستايیهای جانبی بین پنلهای خورشیدی محسوب میشود. اين طراحی امکان حرکت پیوسته، ايمن و بدون توقف ربات را در محیطهای واقعی نصب پنل فراهم کرده و نقش مهمی در افزايش قابلیت عملیاتی و تطبیقپذيری سیستم ايفا میکند.

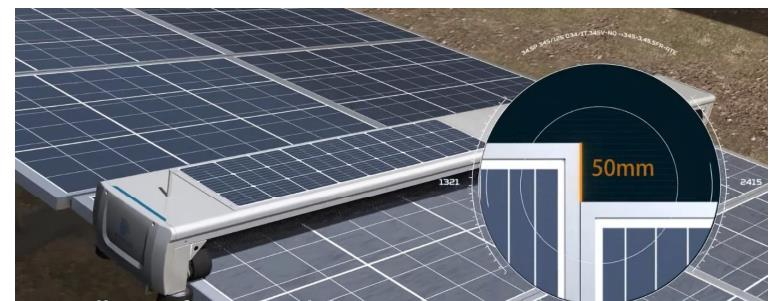
[picture p83: figure]

شکل 7-۳نمونه تصوير وجود عدم هم راستايی در پنل های خورشیدی

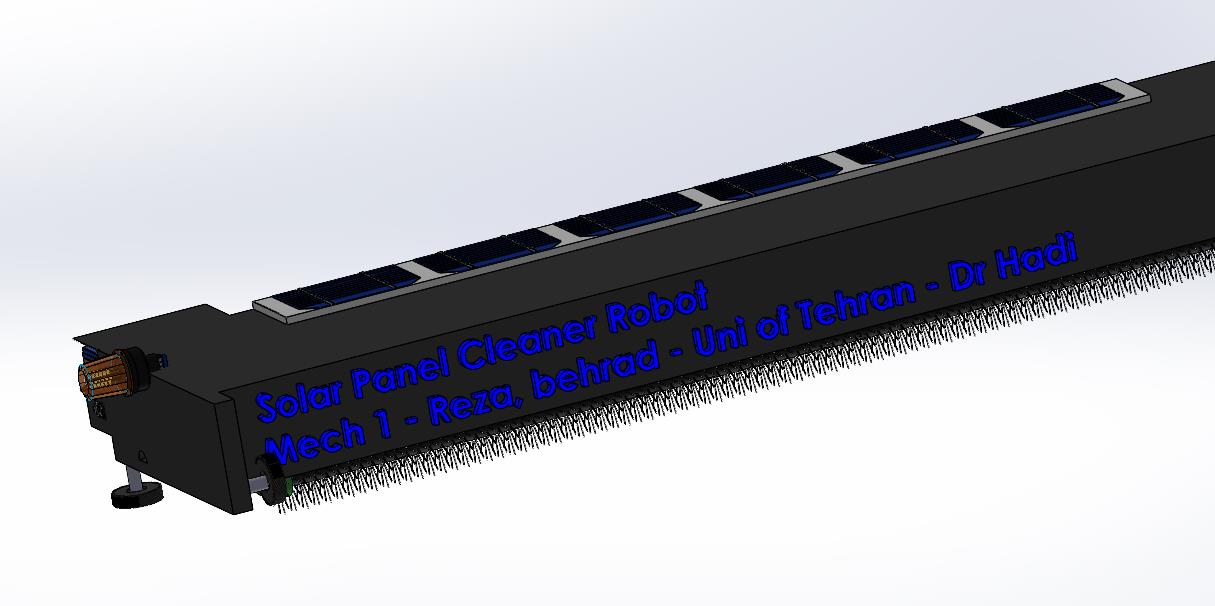
[picture p84: figure]

شکل 8-۳ تصوير چرخ کناری در ربات برای جابجايی در عدم هم راستايی پنال های خورشیدی

### -2-۵ ۳انکودر افزايشی شیاردار برای تعیین موقعیت خطی ربات:

برای تعیین موقعیت دقیق ربات تمیزکننده بر روی صفحات خورشیدی، از يک انکودر افزايشی ديسکی با 120 شیار نوری استفاده شده است که تصوير آن در شکل مربوطه نشان داده شده است. اين انکودر از نوع Encoder Incremental Optical بوده و شامل يک ديسک مدور شیاردار، منبع نور )LED مادون قرمز( و گیرنده نوری )فتوديود يا فتوترانزيستور( است. با چرخش ديسک، عبور و انسداد متناوب نور از شیارها باعث تولید پالسهای ديجیتال میشود که مستقیماً با زاويه چرخش شفت متصل به چرخ يا گیربکس متناسب است.

در اين انکودر، ديسک شامل 120 شیار يکنواخت در محیط خارجی است؛ بنابراين در هر دور کامل چرخش شفت، 120 پالس مجزا تولید میشود. اين ويژگی امکان اندازهگیری دقیق جابهجايی زاويه ای و در نتیجه، تبديل آن به جابهجايی خطی ربات را فراهم میکند. از آنجا که انکودر بهصورت مستقیم يا غیرمستقیم به محور چرخ محرک متصل شده است، سیگنالهای خروجی آن اطالعات دقیقی از حرکت واقعی ربات روی سطح پنل ارائه میدهند.

از منظر مدلسازی، رزولوشن زاويهای انکودر به صورت زير تعريف میشود:

Δθ=2π/ N | 7-۳
که در آن 120=N تعداد شیارها است. در نتیجه، حداقل زاويه قابل تشخیص توسط انکودر برابر خواهد بود با:
Δθ=2π/120≈0.052rad | 8-۳

با در نظر گرفتن شعاع مؤثر چرخ محرک R، رزولوشن خطی سیستم پوزيشنینگ به صورت زير محاسبه میشود:

Δx=R⋅Δθ=2πR/120 | 9-۳
اين رابطه نشان میدهد که با انتخاب مناسب قطر چرخ، میتوان به دقت خطی مطلوب برای حرکت روی پنلهای خورشیدی دست يافت. در طراحی حاضر، اين مقدار به حدی است که تغییرات موقعیت ربات در مقیاس کسری از میلیمتر قابل تشخیص بوده و برای کنترل حرکت يکنواخت، توقف دقیق و هماهنگی با مکانیزم برس کامالً کافی است.

از نظر عملکردی، استفاده از انکودر افزايشی شیاردار مزايای متعددی برای اين کاربرد به همراه دارد. نخست آنکه ساختار ساده و مقاوم آن، انکودر را برای محیطهای بیرونی و نیمهصنعتی مناسب میسازد؛ محیطی که پنلهای خورشیدی معموالً در معرض گردوغبار، تابش مستقیم خورشید و تغییرات دمايی قرار دارند. دوم آنکه خروجی ديجیتال پالسی اين انکودر بهراحتی توسط میکروکنترلر انتخابشده )32ESP )قابل پردازش بوده و امکان شمارش پالسها در وقفههای سختافزاری با دقت زمانی باال را فراهم میکند.

همچنین، به دلیل ماهیت افزايشی انکودر، اطالعات موقعیت بهصورت نسبی نسبت به نقطه شروع حرکت محاسبه میشود. اين ويژگی با ماهیت عملکرد ربات تمیزکننده که حرکت آن عمدتاً خطی و تکرارشونده روی رديف های پنل است، کامالً سازگار بوده و نیاز به انکودر مطلق پرهزينه را از بین میبرد. در صورت نیاز، با تعريف يک نقطه مرجع اولیه ، میتوان موقعیت مطلق ربات را نیز با دقت مناسب تعیین کرد.

در مجموع، انکودر افزايشی 120 شیاره بهکاررفته در اين سیستم، يک راهحل کمهزينه، دقیق و قابل اطمینان برای پوزيشنینگ ربات روی صفحات خورشیدی محسوب میشود. دقت زاويهای مناسب، رزولوشن خطی کافی، سازگاری با سیستم کنترلی و مقاومت در برابر شرايط محیطی، اين انکودر را به گزينهای مناسب برای کاربرد حاضر تبديل کرده و نقش کلیدی در تحقق حرکت پايدار و کنترل شده ربات ايفا میکند.

## -۳-۳شبیه سازی در متلب :

در اين بخش، مدل شبیه سازی توسعه يافته در محیط Simulinkو Multibody Simscape بهمنظور بررسی رفتار دينامیکی و سینماتیکی ربات تمیزکننده پنل خورشیدی تشريح میشود. هدف از اين مدل، ايجاد يک ارتباط مستقیم و فیزيکی بین حرکت تجويزی ربات و مدل سهبعدی واقعی استخراج شده از نرمافزار SolidWorks است، به گونهای که اثر جرم، اينرسی، قیود مکانیکی و تبديل چارچوبهای مرجع بهصورت واقعی در شبیه سازی لحاظ گردد.

ساختار کلی مدل

ساختار کلی مدل شامل سه بخش اصلی است:

.1 تولید سیگنالهای حرکتی )Signals Motion )

.2 تبديل و اعمال حرکت در چارچوبهای مرجع مختلف

.3 اتصال به اسمبلی صلب سهبعدی ربات

اين ساختار به صورت هدفمند انتخاب شده است تا امکان بررسی رفتار مکانیکی ربات در شرايط حرکتی مختلف بدون درگیر شدن مستقیم با مدلسازی پیچیده کنترل موتور فراهم شود.

ورودیهای حرکتی سیستم

در مدل حاضر، حرکت ربات توسط سه سیگنال اصلی تعريف میشود:

- )t)xsignal : جابجايی خطی ربات در راستای طول پنل خورشیدی
- )t)zsignal : جابجايی عمودی ربات برای مدلسازی عبور از ناهمواریها، پلهها يا misalignment
- )t)θsignal : زاويه چرخش ربات حول محور عرضی که بیانگر تغییر وضعیت زاويه ای ربات نسبت به سطح پنل است

اين سیگنالها بهصورت موقعیت مطلق تعريف شدهاند تا حرکت ربات بهطور دقیق و قابلکنترل بر اساس سناريوهای حرکتی مورد نظر اعمال شود. انتخاب اين رويکرد باعث میشود تحلیل شبیهسازی بر رفتار مکانیکی و سینماتیکی سیستم متمرکز شود.

مشتقگیری زمانی و تولید سرعتها

از آن جا که بلوکهای حرکتی در محیط Multibody Simscapeبرای اعمال حرکت نیازمند نرخ تغییر مکان و دوران هستند، سیگنالهای موقعیت ورودی پس از ورود به مدل، از طريق بلوکهای مشتق گیر (Δt/Δu (به سیگنالهای سرعت تبديل میشوند. برای هر يک از مؤلفه های حرکتی، فرآيند مشتقگیری بهصورت مستقل انجام شده است:

x(t)→x˙(t) , z(t)→z˙(t) , θ(t)→θ˙(t) | 10-۳

اين ساختار باعث میشود اعمال حرکت به مدل چندجسمی مطابق با الزامات فیزيکی محیط شبیه سازی انجام شود و از بروز ناپايداری عددی جلوگیری گردد.

ادغام سیگنالها و اعمال حرکت چنددرجه آزادی

پس از مشتق گیری، سیگنالهای سرعت خطی و زاويه ای در قالب يک بردار يا باس سیگنال ادغام میشوند. اين کار بهمنظور اعمال همزمان حرکت انتقالی و دورانی به ربات انجام شده است. با اين روش، حرکت ربات بهصورت حرکت صفحه ای مدل سازی شده و کوپل بین جابجايی و چرخش بهطور طبیعی در سیستم لحاظ میشود.

بلوکهای Transform و تبديل چارچوب ها

در مدل حاضر، مجموعهای از بلوکهای Transform برای تعريف و تبديل چارچوبهای مرجع استفاده شدهاند. اين بلوکها نقش اساسی در انتقال صحیح حرکت بین فريمهای مختلف دارند که شامل موارد زير است:

- چارچوب مرجع زمین )Frame World )
- چارچوب پنل خورشیدی
- چارچوب بدنه ربات
- چارچوب اجزای فرعی مانند برس و مکانیزمهای کمکی

وجود چندين بلوک Transform نشاندهنده آن است که مدل بهصورت کامالً consistent-Frame طراحی شده و حرکت ربات در هر مرحله در چارچوب مرجع صحیح اعمال میشود. اين موضوع برای جلوگیری از خطاهای سینماتیکی و نتايج غیرواقعی در شبیه سازی ضروری است.

مدل اجسام صلب

در سمت چپ مدل، چندين بلوک RIGID_1_solars مشاهده میشود که نمايانگر بخشهای ثابت سیستم مانند پنلهای خورشیدی يا اجزای محیطی هستند. اين اجسام بهصورت صلب و بدون درجه آزادی در نظر گرفته شدهاند تا شرايط مرزی واقعی محیط کاری ربات شبیهسازی شود.

در سمت راست مدل بلوک RIGID_1_assem_cleaner_panel_Solar3x قرار دارد که نمايانگر اسمبلی کامل ربات تمیزکننده پنل خورشیدی است. اين بلوک شامل خواص جرمی، مرکز جرم و ممانهای اينرسی استخراج شده از مدل سهبعدی SolidWorks بوده و رفتار دينامیکی واقعی ربات را در شبیهسازی بازتولید میکند.

سیگنالهای فیزيکی و ارتباطSimscape–Simulink :

در اين مدل، خطوط قرمز رنگ بیانگر سیگنالهای فیزيکی در محیط Simscape هستند. اين سیگنالها مستقیماً کمیت های فیزيکی مانند سرعت و نرخ دوران را منتقل میکنند و تفاوت اساسی با سیگنالهای معمول Simulink دارند. استفاده از اين نوع سیگنالها نشان میدهد که مدل حاضر يک شبیه سازی فیزيکمحور و مبتنی بر قوانین مکانیک چندجسمی است.

فلسفه طراحی مدل

مدل حاضر بهگونهای طراحی شده است که:

- حرکت ربات بهصورت تجويزی و قابلکنترل اعمال شود
- اثر جرم، اينرسی و قیود مکانیکی بهصورت واقعی لحاظ گردد
- تمرکز شبیه سازی بر اعتبارسنجی طراحی مکانیکی و رفتار حرکتی سیستم باشد

به همین دلیل، از مدلسازی مستقیم موتور، گیربکس و کنترلکننده در اين مرحله صرفنظر شده و اين بخشها بهعنوان ورودی حرکتی معادل در نظر گرفته شدهاند. اين رويکرد باعث کاهش پیچیدگی مدل و افزايش پايداری عددی شبیه سازی شده است.


شکل 9-۳ شبیه سازی ربات در سیمولینک

-3-3-1نمودار های خروجی متلب :


شکل 10-۳ سیکل رفتوبرگشت سهمرحلهای نشان در اين شکل، پروفیل حرکت ربات تمیزکننده در طول يک سیکل رفتوبرگشت سهمرحلهای نشان داده شده است. محور افقی زمان شبیهسازی )بر حسب ثانیه( و محور عمودی جابهجايی خطی را نمايش میدهد. منحنی آبی رنگ بیانگر موقعیت ربات در راستای طول پنل )X – حرکت جلو/عقب( و منحنی قرمز رنگ بیانگر موقعیت عمودی ربات )Z – حرکت باال/پايین( است. همانگونه که در عنوان نمودار ذکر شده، مسیر بر اساس روش درونیابی قطعهای pchip تولید شده است که باعث پیوستگی مشتق اول و حذف شکست های تند در سرعت و شتاب میشود؛ در نتیجه پروفیل حرکتی از نظر دينامیکی نرم و قابلقبول برای يک سیستم مکانیکی واقعی است.

منحنی آبی نشان میدهد که ربات در سه بازه زمانی مجزا، حرکت رفتوبرگشت روی سطح پنل را انجام میدهد. در هر سیکل، موقعیت X از صفر شروع شده، به حداکثر مقدار خود میرسد و سپس مجدداً به نزديکی مقدار اولیه بازمیگردد، که اين رفتار با عملکرد واقعی ربات در طی سه بار جاروبکردن سطح پنل سازگار است. شکل سینوسیمانند منحنی آبی و نبود گوشههای تیز در آن، نشاندهنده اين است که تغییرات سرعت و شتاب ناگهانی نبوده و مسیر حرکت برای جلوگیری از ضربههای مکانیکی به شاسی و سیستم انتقال قدرت، بهصورت نرم طراحی شده است.

منحنی قرمز، تغییرات ارتفاع ربات را در حین انجام اين سه سیکل نشان میدهد. در ابتدا، ربات در ارتفاع صفر )تماس با سطح شروعی پنل( حرکت میکند. سپس، در حدود زمان میانی سیکل اول، ارتفاع آن بهصورت کامالً نرم تا حدود ۳ واحد افزايش يافته و در يک بازه زمانی ثابت نگه داشته میشود. اين بخش متناظر با حالتی است که ربات به لبه يا اختالف تراز بین دو رديف پنل رسیده و برای عبور از آن، توسط مکانیزم تنظیم ارتفاع، به باال منتقل میشود. در ادامه، در حوالی آغاز سیکل سوم، ارتفاع Z مجدداً بهصورت نرم تا حدود ۶ واحد افزايش میيابد که میتواند بیانگر عبور از يک عدمهمترازی بزرگتر يا يک پله دوم در مسیر باشد. در انتهای نمودار، کاهش تدريجی ارتفاع تا صفر مشاهده میشود که نشان میدهد ربات پس از پايان سیکل کاری، به سطح اولیه باز میگردد.

تطبیق زمانی بین تغییرات X و Z نشان میدهد که افزايش ارتفاع دقیقاً در نواحیای رخ میدهد که ربات به انتهای مسیر يک پنل رسیده و آماده جابهجايی به رديف بعدی است؛ در حالی که در میانه هر سکشن تمیزکاری )بخش میانی هر قوس آبی(، ارتفاع ثابت باقی میماند تا برس با سطح پنل در تماس پايدار قرار داشته باشد. اين همزمانی و توالی منطقی بین حرکت طولی و عمودی، تأيید میکند که الگوريتم تولید مسیر، رفتار واقعی ربات در عبور از لبه ها و ناهمترازی ها را بهدرستی بازتولید کرده است.

به طور کلی، شکل بهدستآمده نشان میدهد که:

.1 مسیر حرکتی ربات در هر سه سیکل، تکرارشونده، نرم و از نظر سینماتیکی قابل قبول است؛

.2 تغییرات ارتفاع بدون پرش ناگهانی و با رمپهای صاف انجام شده که برای جلوگیری از بارهای شوکی روی مکانیزم پولی– تسمه و گیربکس ضروری است؛

.3 هماهنگی زمانی بین حرکت طولی و عمودی، با سناريوی کاری تعريفشده برای ربات )تمیزکاری چندباره يک رديف پنل
و عبور از لبه ها( مطابقت دارد.

بنابراين، میتوان نتیجه گرفت که خروجی اين بخش از شبیهسازی، مسیر حرکتی طراحیشده برای ربات را بهصورت واقعبینانه و از نظر دينامیکی قابل اجرا نمايش میدهد و بهعنوان ورودی برای مدل چندجسمی Simscape و تحلیلهای بعدی دينامیکی، کامالً معتبر و مناسب است.


شکل11-۳ سرعت زاويه ای شفت موتور

هدف از اين آزمايش بررسی رفتار دينامیکی موتور DC از نظر سرعت زاويه ای محور خروجی آن در واحد زمان است. در اين مطالعه، سرعت چرخش محور بر حسب دور بر دقیقه، در بازه زمانی ۳0 ثانیه اندازهگیری و رسم شده است. دادهها نشاندهنده تغییرات متناوبی از سرعت مثبت و منفی هستند که نشان از تغییر جهت چرخش محور موتور در طی زمان دارد.

نمودار نشان داده شده در شکل فوق، رابطه بین زمان )Time )در محور افقی و سرعت چرخش محور موتور )RPM )در محور عمودی را نمايش میدهد.

در ادامه، تحلیل دقیق ويژگیهای نمودار آورده شده است:

.1 دامنه تغییرات:

سرعت محور موتور بین حدود 10⁴×+2.5 و 10⁴×−2 دور بر دقیقه تغییر میکند. اين دامنه نشان میدهد که موتور دارای توانايی بااليی در تغییر جهت و سرعت است.

.2 رفتار تناوبی:

الگوهای نوسانی در نمودار نشان میدهند که موتور بهطور دورهای شتاب میگیرد و سپس در جهت مخالف میچرخد. اين رفتاری معمول در سیستم هايی است که از ورودی سیگنال سینوسی يا پالس PWM دوطرفه استفاده میکنند.

.3 نواحی صفر سرعت )0 = RPM):

در چند بازه زمانی )حدوداً در ،۵ ،10 ،1۵ 20 و 2۵ ثانیه(، سرعت محور به صفر میرسد. اين نقاط نرخ تغییر جهت چرخش را نشان میدهند، به عبارتی لحظهای که موتور متوقف شده و جهت حرکت عوض میشود.

.4 شیب تغییرات سرعت:

افزايش و کاهش ناگهانی در شیب نمودار بیانگر وجود گشتاورهای لحظه ای زياد و يا پاسخ سريع موتور به ورودی کنترل است. اين تغییرات سريع معموالً به علت پاسخ موتور به تغییر ولتاژ کنترلی يا سیگنال ورودی است.

.5 پايداری سیستم:

با وجود نوسانات در سرعت، دامنه رفتار موتور در بازه زمانی ثابت باقی مانده است که نشاندهنده پايداری نسبی سیستم در برابر تغییر جهت است.

نوسانات در نمودار نشان میدهند که محور موتور به صورت رفت و برگشتی میچرخد؛ يعنی ابتدا در جهت مستقیم )مثبت( با RPM زياد میچرخد، سپس سرعت کاهش يافته و وارد جهت مخالف میشود. اين نوع رفتار ممکن است مربوط به سیگنال کنترلی متناوب )مثالً موج سینوسی يا مربعی متقارن( يا سیستم بار مکانیکی متناوب باشد.

در حالت واقعی، چنین سیگنالی ممکن است از کنترلکنندهای که هدفش شبیهسازی حرکت نوسانی يا کنترل وضعیت زاويه ای است، ناشی شده باشد.


شکل 12-۳ تراژکتوری سفارشی ۴0 ثانیهای با چرخشهای زمانی تتا نمودار حاضر که تحت عنوان »تراژکتوری سفارشی ۴0 ثانیهای با چرخشهای زمانی تتا« ارائه شده است، تحلیل دينامیکی يک سیستم متحرک را در سه مؤلفه موقعیت افقی(X (، موقعیت عمودی (Z (و میزان دوران زاويهای (Theta (در واحد زمان نمايش میدهد. در اين تحلیل، محور افقی بیانگر زمان بر حسب ثانیه و محور عمودی نشان دهنده دامنه تغییرات هر متغیر است که برای موقعیتها بر حسب متر و برای دوران بر حسب درجه تنظیم شده است. با بررسی رفتار متغیر X که با رنگ آبی مشخص شده، مشاهده میشود که سیستم در بازه ابتدايی تا ثانیه ،17 يک حرکت رفت و برگشتی با اوج دامنه تقريبی 9.۳ متر را تجربه میکند و پس از يک توقف کوتاه در مبدأ، مجدداً در ثانیه 20 وارد فاز حرکتی دوم شده و با شیبی تندتر به همان اوج دامنه باز میگردد و در نهايت در ثانیه 28 به مقدار صفر میل میکند. همزمان با اين فرآيند، متغیر موقعیت Z با رنگ قرمز که از ثانیه 12 فعال شده است، رفتاری پلهای و صعودی را به نمايش میگذارد؛ به طوری که ابتدا يک نوسان کوتاه تا ارتفاع ۳ متر انجام داده و پس از بازگشت لحظه ای به صفر در ثانیه ،17 مجدداً صعود کرده و در بازه ثانیه 20 تا 27 در ارتفاع ثابت ۶ متر پايدار میماند که اين نشاندهنده حفظ ارتفاع در حین حرکت افقی است، و در نهايت با يک شیب ماليم در ثانیه ۳۳ به سطح زمین يا مبدأ باز میگردد. در اليه سوم اين تحلیل، متغیر دوران تتا با رنگ مشکی قرار دارد که رفتاری کامالً زمانبندی شده و دقیق را نشان میدهد؛ اين متغیر تا ثانیه 21 بدون تغییر باقی مانده و سپس دو پالس دورانی متقارن را تجربه میکند؛ پالس اول يک چرخش مثبت تا 2 درجه در ثانیه 22 و پالس دوم يک چرخش معکوس تا منفی 2 درجه در ثانیه 27 است که احتماالً جهت اصالح زاويه يا تغییر جهت حرکت در فاز نهايی مسیر تعبیه شده است. از منظر پیادهسازی در نرمافزار متلب، اين نمودار حاصل ادغام سه سیگنال مجزا در يک دستگاه مختصات با استفاده از دستور on hold است که در آن برای تولید دادههای X و Z از توابع تکهای يا درونيابی اسپالين جهت ايجاد انحناهای نرم استفاده شده و برای سیگنال تتا از توابع ضربهای يا گوسی با پهنای باند محدود بهره گرفته شده است تا تغییرات ناگهانی و بازگشت به صفر به دقت مدلسازی شود. هماهنگی زمانی بین اين سه پارامتر نشاندهنده يک سیستم کنترل هوشمند است که در آن تغییرات ارتفاعی و دورانی دقیقاً در لحظات کلیدی جابهجايی افقی رخ میدهند تا يک مسیر حرکتی سهبعدی پیچیده و پیشتعريف شده را با دقت باال دنبال کنند. در مجموع، اين نمودار به خوبی توانايی سیستم را در تفکیک وظايف حرکتی و حفظ پايداری در فازهای مختلف عملیاتی در يک بازه زمانی ۳۵ ثانیهای به تصوير میکشد.

فايل سیمولینک

در اين پروژه، به منظور بررسی عملکرد ربات در شرايط حرکتی مختلف، شش شبیهسازی مجزا در محیط نرمافزار MATLAB طراحی و اجرا شده است. هر يک از اين شبیه سازیها رفتار ربات را در يک سناريوی مشخص بررسی میکنند و زمان مورد نیاز برای اجرای هر سناريو در کنار فايل مربوطه مشخص شده است. هدف از انجام اين شبیهسازی ها تحلیل عملکرد سیستم کنترلی و بررسی پاسخ دينامیکی ربات در شرايط گوناگون عملیاتی میباشد.

برای نمايش بهتر رفتار حرکتی ربات، خروجی هر يک از اين شبیهسازیها به صورت انیمیشن نیز تولید شده است. اين انیمیشنها در پوشه ای با عنوان »Animation »ذخیره شدهاند و امکان مشاهده بصری نحوه حرکت ربات در طول فرآيند شبیه سازی را فراهم میکنند. استفاده از نمايش انیمیشنی کمک میکند تا تغییرات موقعیت، جهت حرکت و عملکرد کلی ربات در طول زمان به شکل دقیقتر و قابل درکتری مورد بررسی قرار گیرد.

برای اجرای صحیح شبیه سازی و جلوگیری از بروز خطا يا کمبود داده در محیط Simulink–MATLAB، الزم است قبل از اجرای مدل اصلی، تعدادی از فايلهای کدنويسی تکمیلی بهمنظور مقداردهی متغیرها و آمادهسازی فضای کاری اجرا شوند. بهصورت دقیق تر، کاربر بايد ابتدا در محیط MATLAB پنج فايل کد اصلی پروژه را در دسترس قرار دهد و سپس پیش از فشردن کلید Run در مدل Simulink، ترتیب اجرای فايلهای مقداردهی بهصورت زير رعايت شود:

و | CALCULATE_TRAJECTORY.m | ،FINAL2.m | ،FINAL.m | فايل | چهار | ابتدا
m.TRAJECTORY_CALCULATE_MODIFIED بايد بهترتیب يا بهصورت متوالی اجرا شوند تا تمامی متغیرهای مرتبط با مسیر حرکتی، پارامترهای سینماتیکی، ضرايب مکانیکی و دادههای ورودی مربوط به دينامیک در Workspace بارگذاری گردند. اين مرحله به MATLAB اجازه میدهد هنگام آغاز شبیهسازی، کلیه متغیرهای مورد نیاز برای اجرای صحیح مدل در دسترس بلوکهای Simulink بوده و هیچ ارجاع نامعینی در حین اجرا به وجود نیايد.

پس از اطمینان از اجرای کامل اين چهار فايل و حضور تمامی مقادير در فضای کاری، کاربر میتواند مدل اصلی شبیهسازی )فايل پنجم با پسوند .slx )را باز کرده و فرآيند شبیهسازی را آغاز کند. در اين حالت، مدل بهصورت خودکار از دادههای تولیدشده در مرحله پیشپردازش استفاده کرده و نتايج حرکت، نیروها و پاسخ سینماتیکی مطابق با پارامترهای تعريفشده در اسکريپت های فوق محاسبه میشود. اين روش باعث يکپارچگی بین بخش کدنويسی و شبیهسازی گرافیکی شده و تضمین میکند که نتايج حاصل از مدل با دادههای طراحی تحلیلی و محاسبات مسیر همخوانی کامل داشته باشند.

الزم به ذکر است که ساختار برنامه به گونهای طراحی شده است که پیش از اجرای فايلهای مربوط به شبیه سازی ها، چهار فايل اولیه که در ابتدای مجموعه کدها قرار دارند بايد اجرا شوند. اين فايلها شامل توابع و پارامترهای پايه مورد نیاز برای شبیه سازی هستند و اجرای آن ها موجب مقداردهی اولیه متغیرها، تعريف توابع مورد استفاده و آمادهسازی محیط شبیهسازی میشود. پس از اجرای اين فايلهای پايه، فايلهای مربوط به شش شبیهسازی مختلف بدون مشکل اجرا شده و نتايج مورد نظر از جمله نمودارها و انیمیشن های مربوط به حرکت ربات تولید خواهند شد.

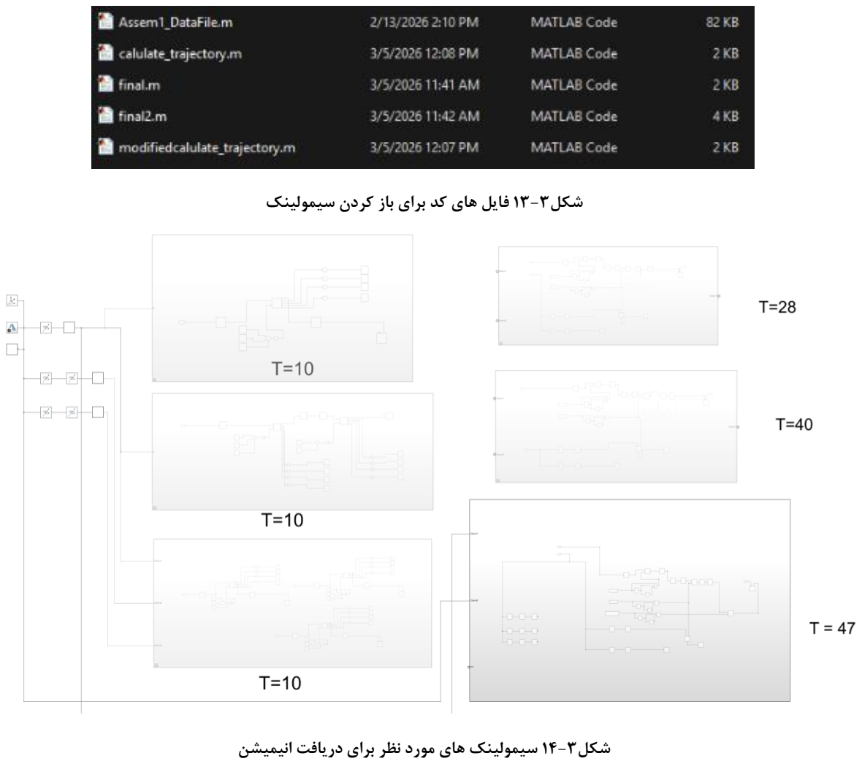
[picture p85: page 59]

شکل1۳-۳ فايل های ک د برای باز کردن سیمولینک

شکل1۴-۳ سیمولینک های مورد نظر برای دريافت انیمیشن

Abstract

In the first phase of this project, the focus was on defining the robot’s functional requirements and selecting its key components. Analysis of the robot’s tasks led to the determination of precise requirements in terms of torque, speed, and motion accuracy. In the actuator selection stage, based on these requirements, the primary actuators (such as motors or linear actuators) were selected while considering an optimal power-to-weight ratio. At the same time, a detailed sizing process was carried out to ensure sufficient capacity for all actuation components.

For the sensing system, a combination of position, force, and vision sensors (where necessary) was selected to provide accurate environmental feedback and information about the robot’s internal state. These sensors were finalized based on reliability, sampling rate, and compatibility with the central control system. Finally, all these components were integrated into a unified conceptual design. This design includes preliminary schematics of the mechanisms, the placement of components, and initial estimates of energy consumption, which form the foundation for the detailed design stages that follow. This phase was successfully completed with the technical validation of all initial selections.

Keywords: actuator selection, sensor selection, mechanical design, modeling.

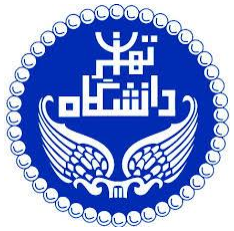
[picture p86: figure]

University of Tehran

Faculty of New Sciences and technologies

Department of Mechatronics Engineering Solar panel clear robot report phase2

By:
Reza nadimi

Behrad mashadi zamani jalayer

Lecturer:
DR.Hadi

winter 2026
