rezaxr14/solar-panel-cleaning-robot/PICS/01.png

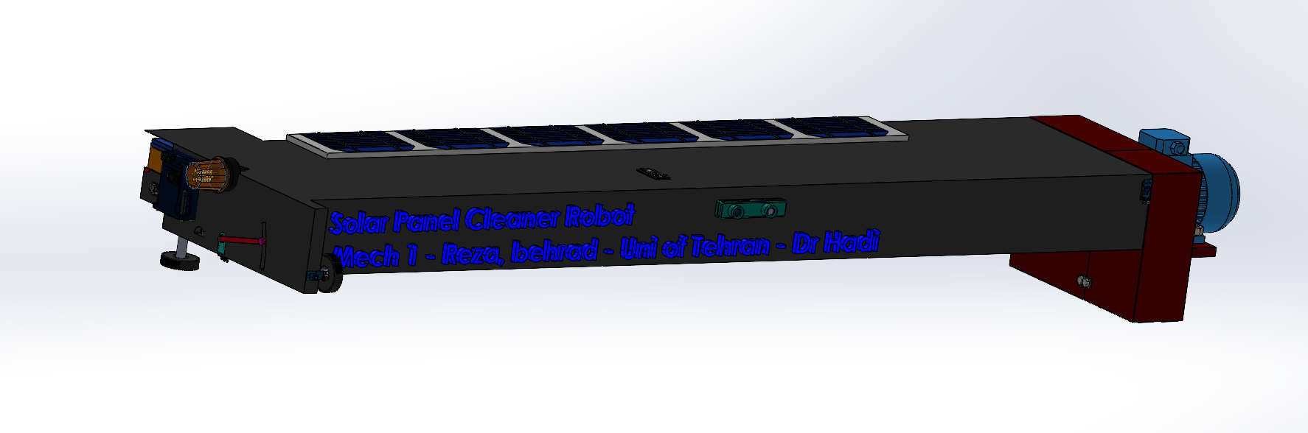
PICS/01.png
