rezaxr14/solar-panel-cleaning-robot/PICS/02.png

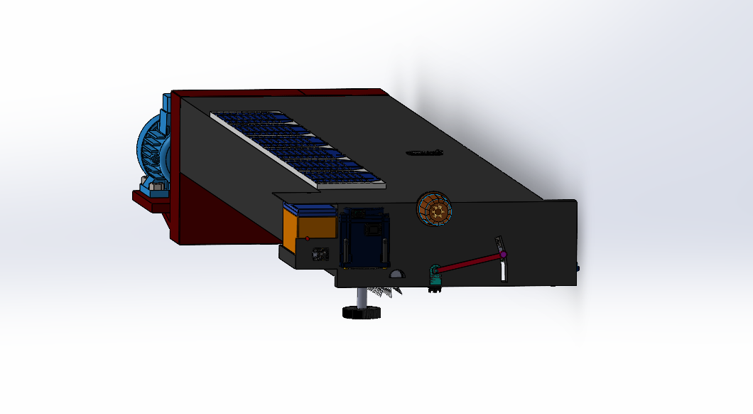
PICS/02.png
