rezaxr14/solar-panel-cleaning-robot/PICS/03.png

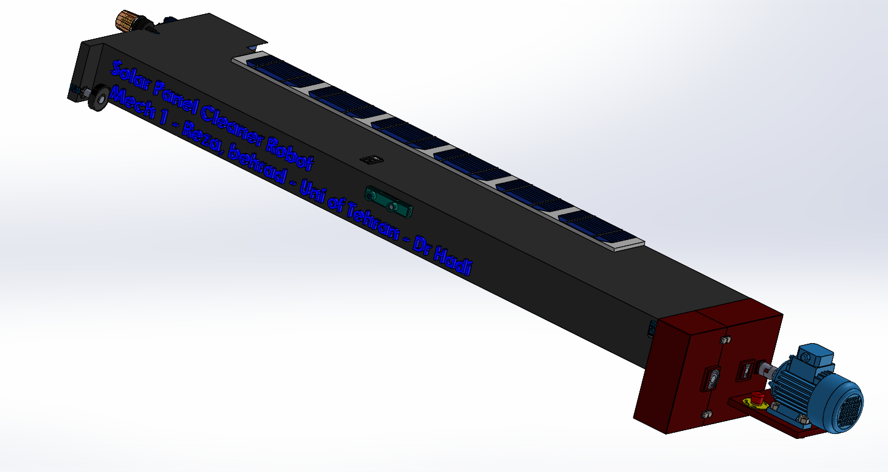
PICS/03.png
