rezaxr14/solar-panel-cleaning-robot/PICS/05.png

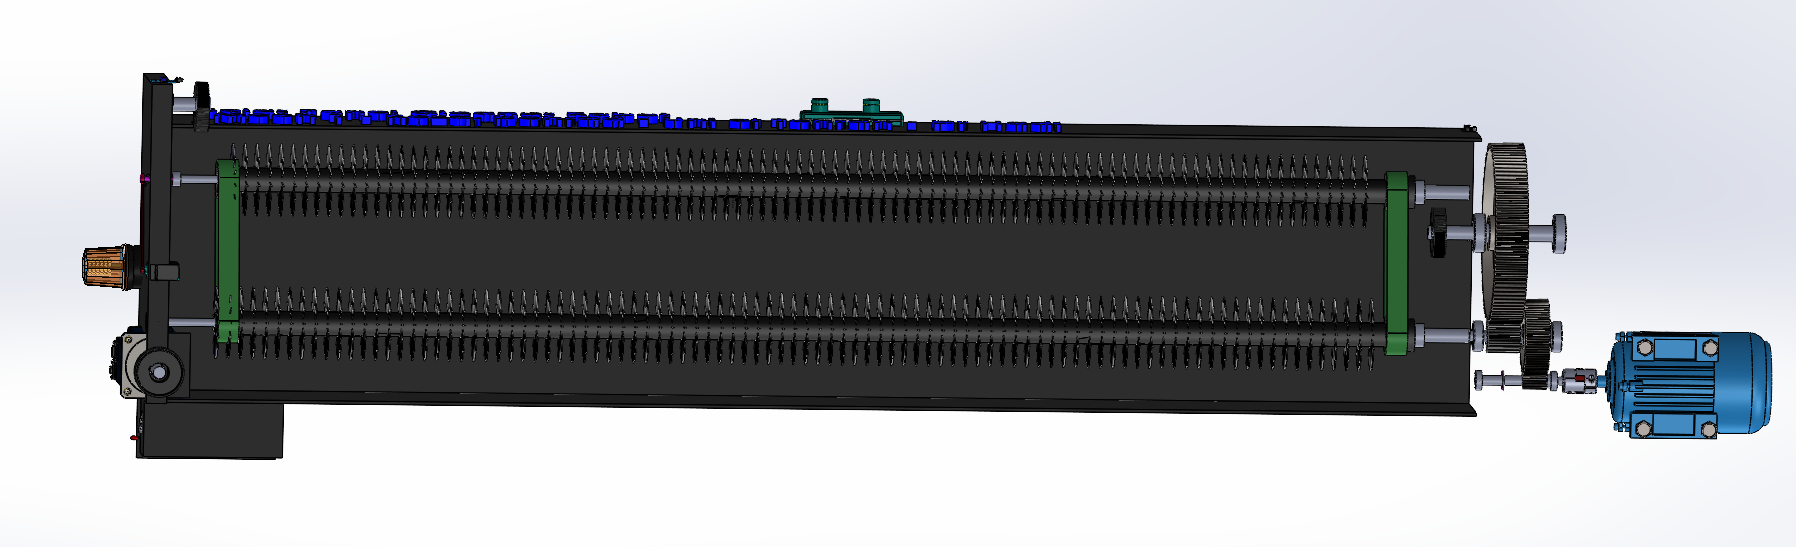
PICS/05.png
