rezaxr14/solar-panel-cleaning-robot/PICS/07.png

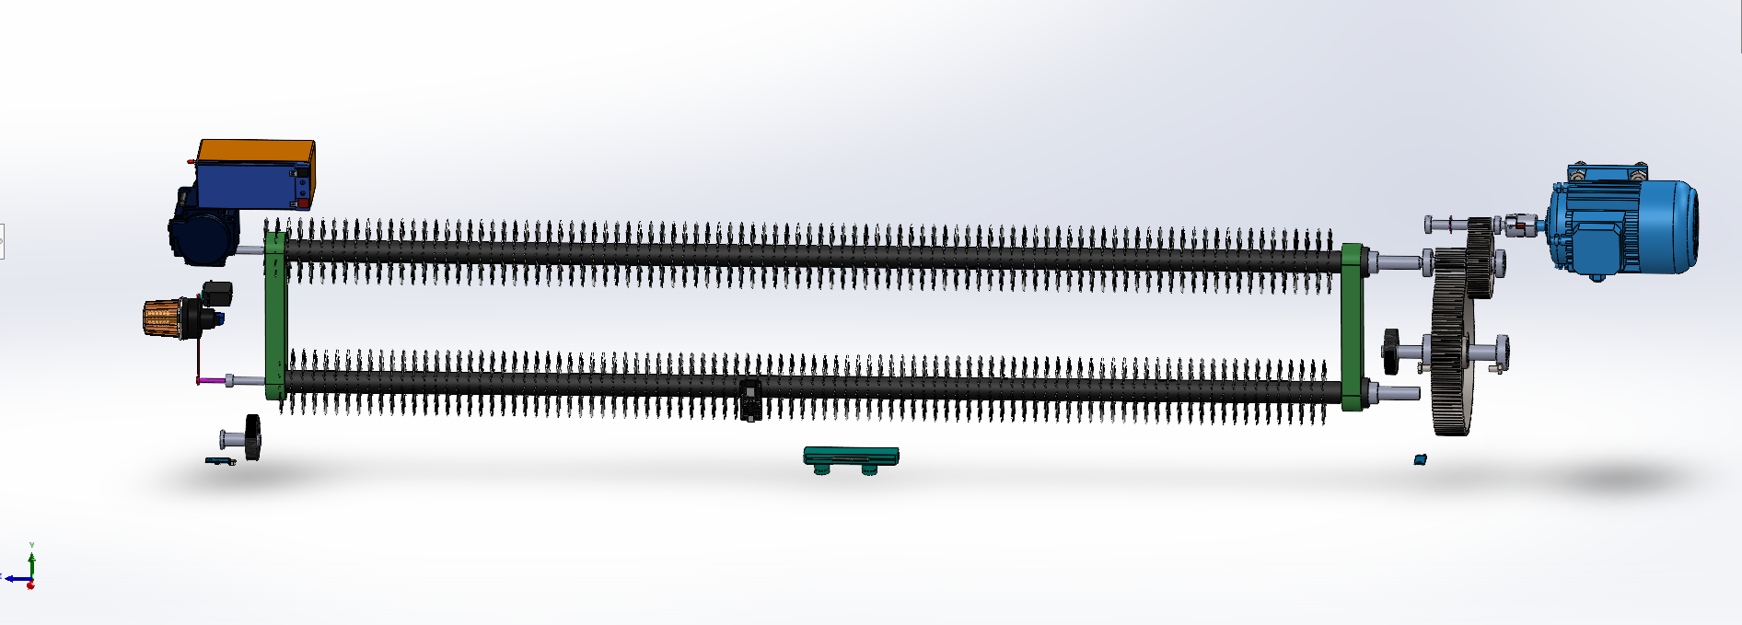
PICS/07.png
