rezaxr14/solar-panel-cleaning-robot/PICS/08.png

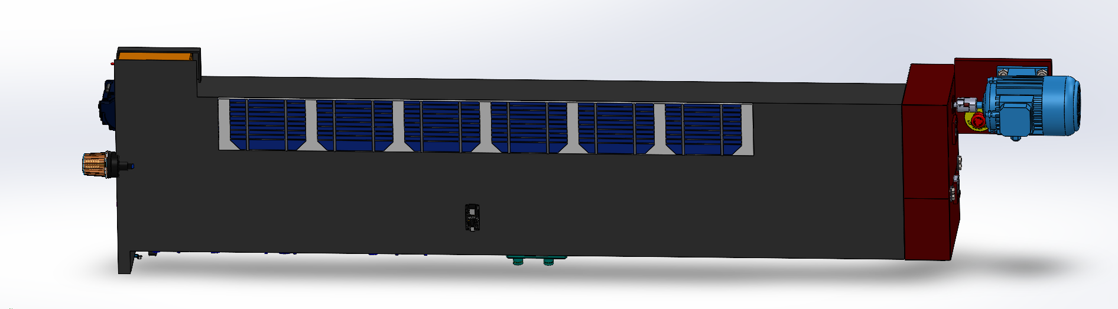
PICS/08.png
