rezaxr14/solar-panel-cleaning-robot/PICS/10.png

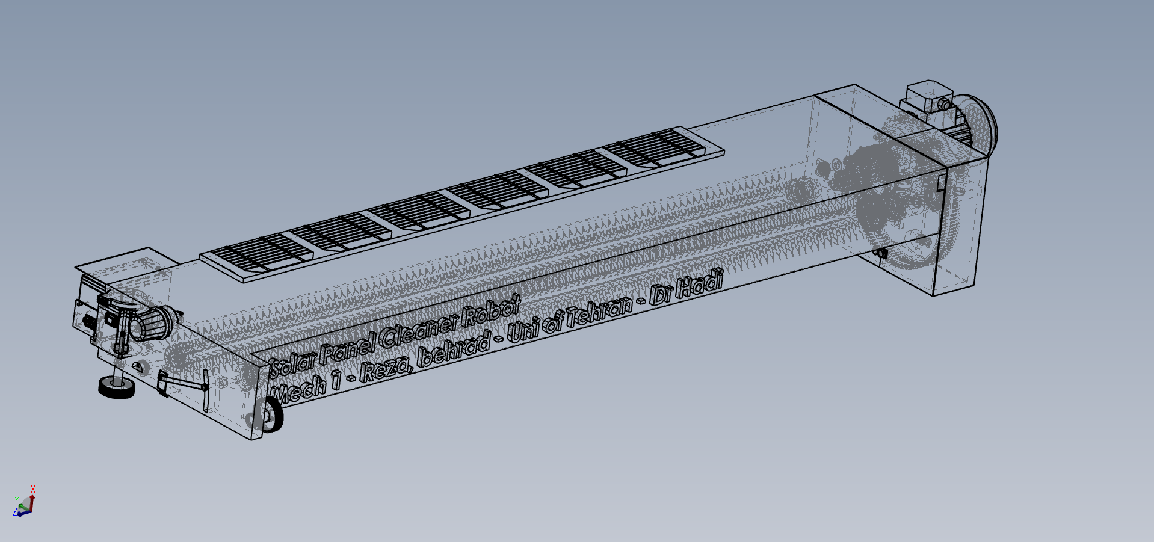
PICS/10.png
