rezaxr14/solar-panel-cleaning-robot/PICS/14.png

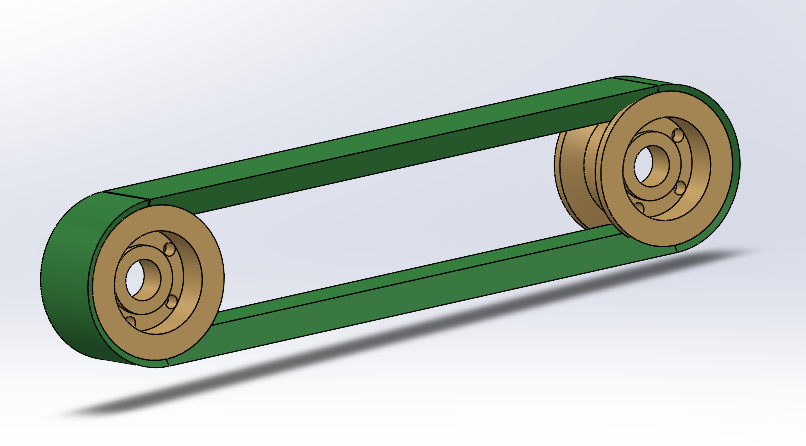
PICS/14.png
