rezaxr14/solar-panel-cleaning-robot/PICS/15.png

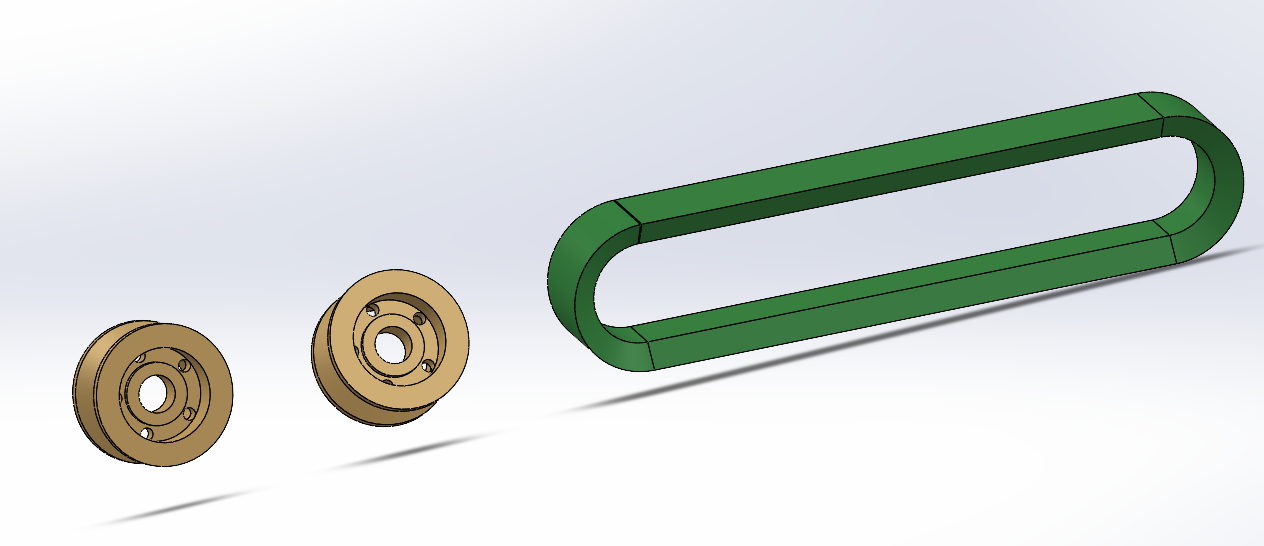
PICS/15.png
