rezaxr14/solar-panel-cleaning-robot/PICS/17.png

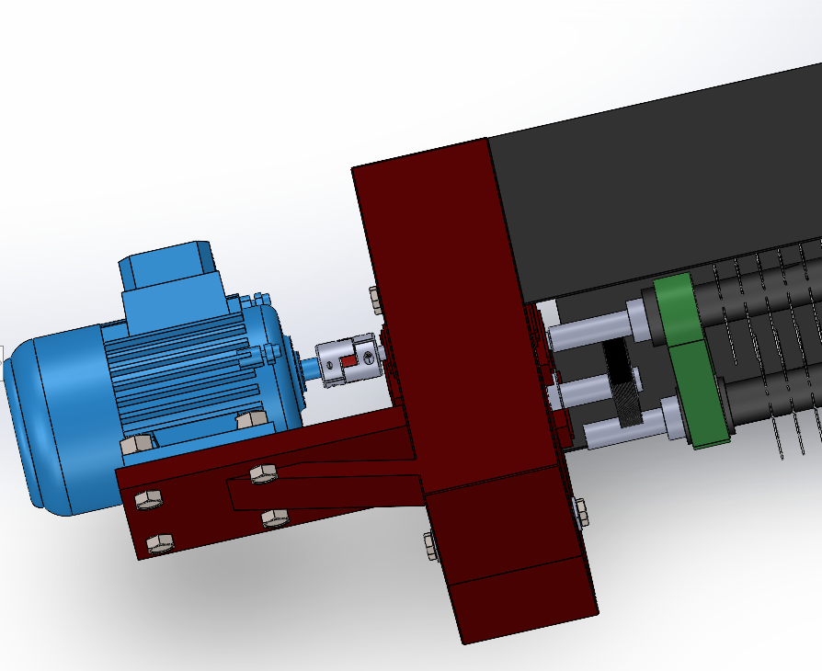
PICS/17.png
