rezaxr14/solar-panel-cleaning-robot/PICS/18.png

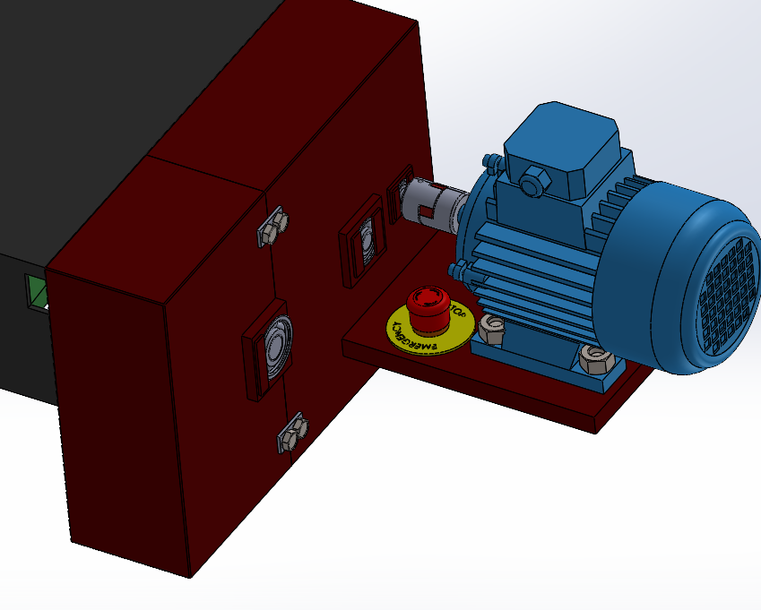
PICS/18.png
