rezaxr14/solar-panel-cleaning-robot/PICS/20.png

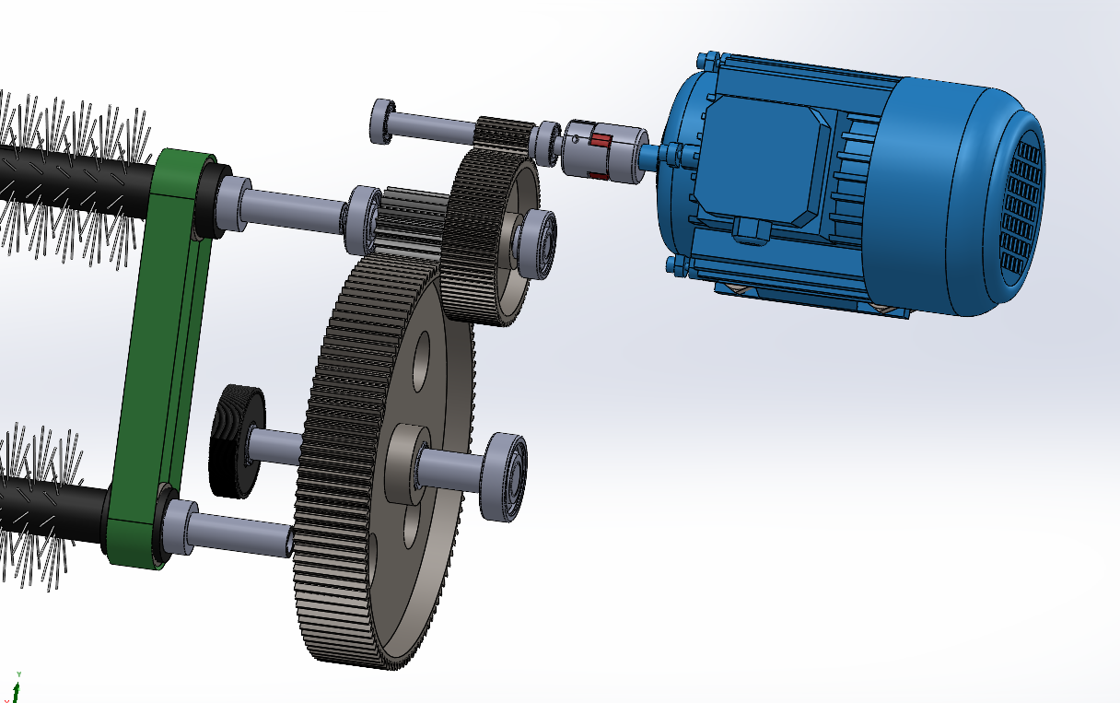
PICS/20.png
