rezaxr14/solar-panel-cleaning-robot/PICS/24.png

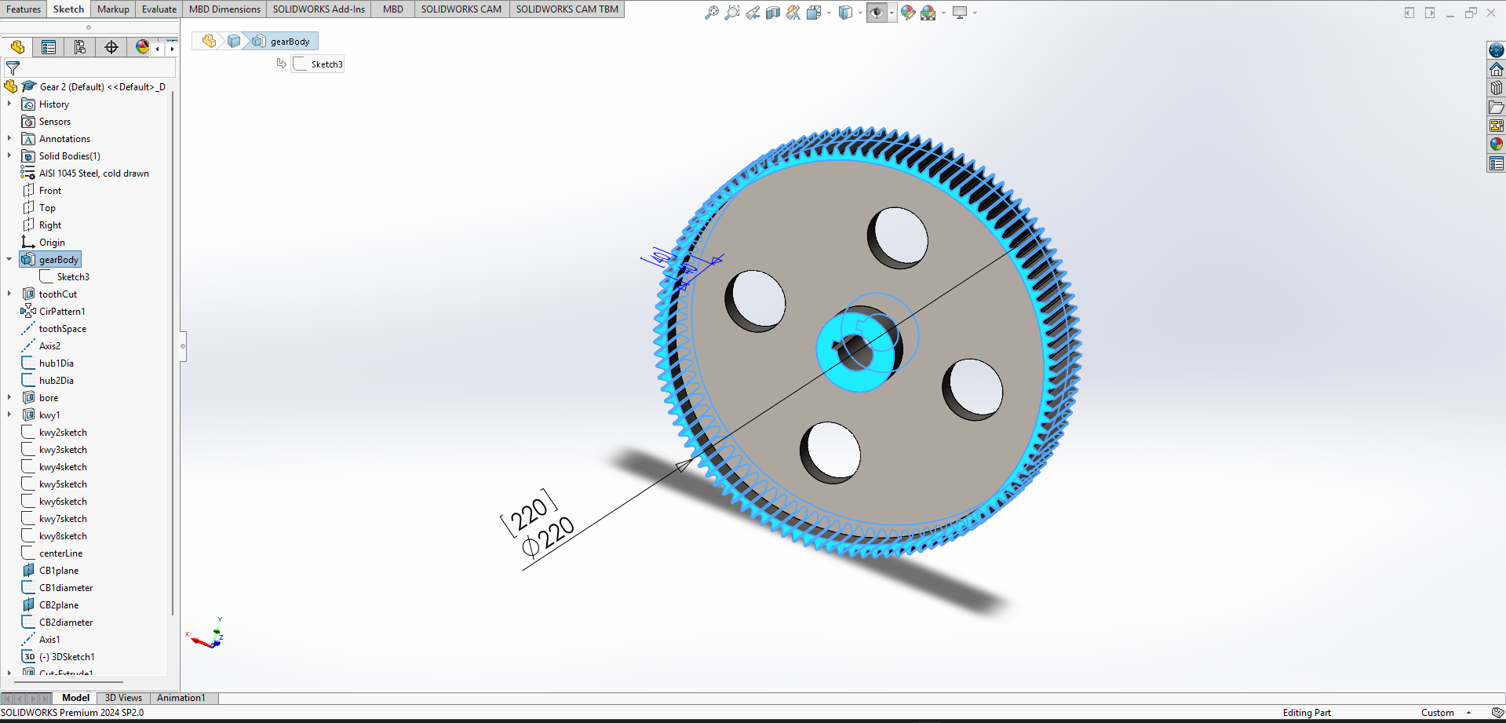
PICS/24.png
