rezaxr14/solar-panel-cleaning-robot/PICS/25.png

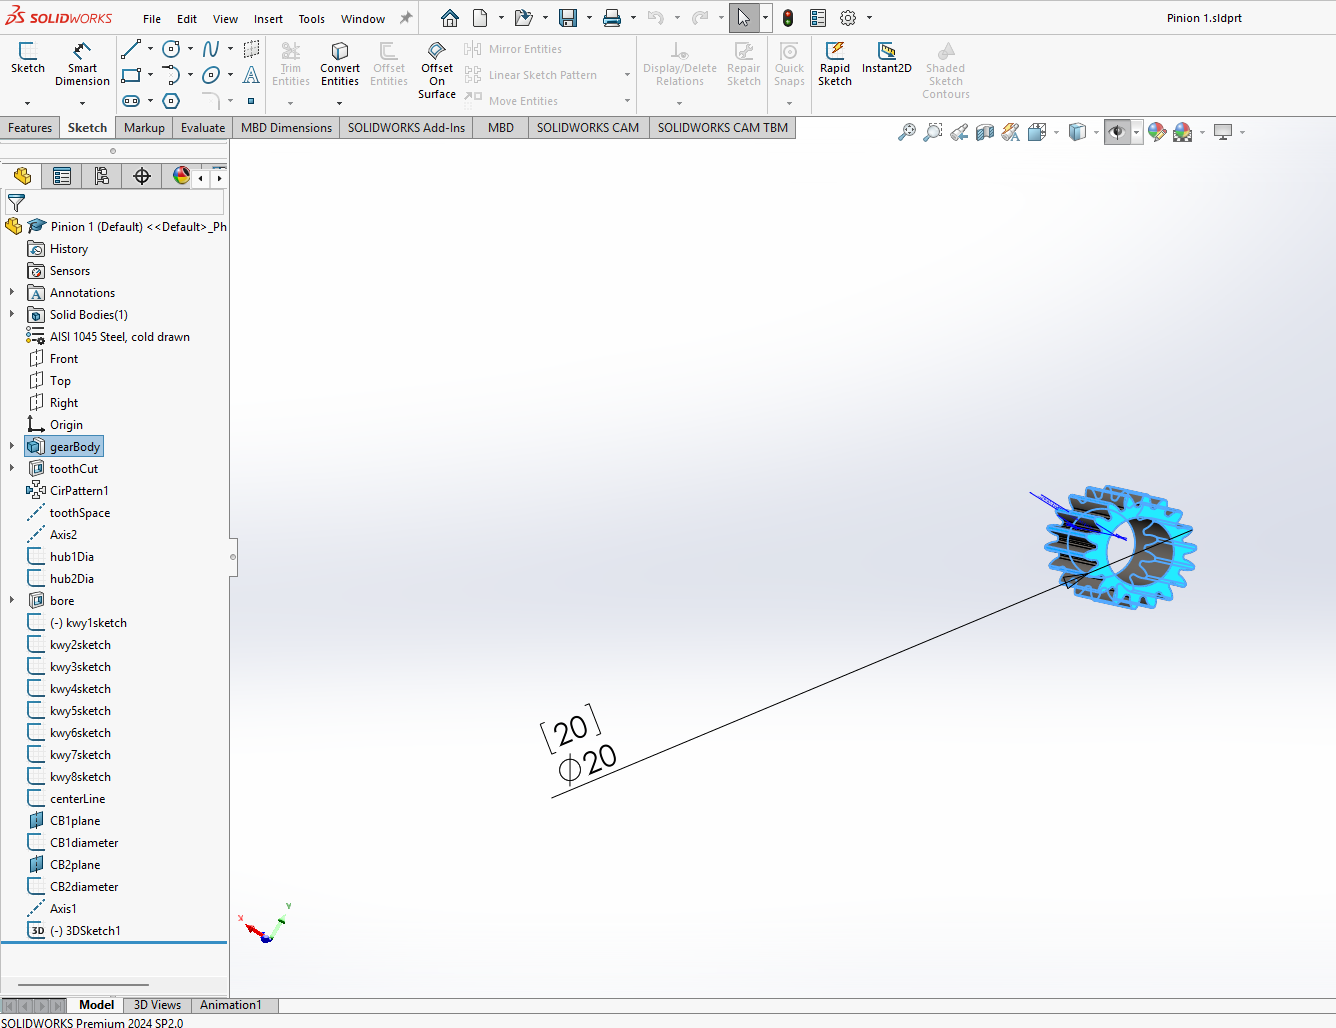
PICS/25.png
