rezaxr14/solar-panel-cleaning-robot/PICS/26.png

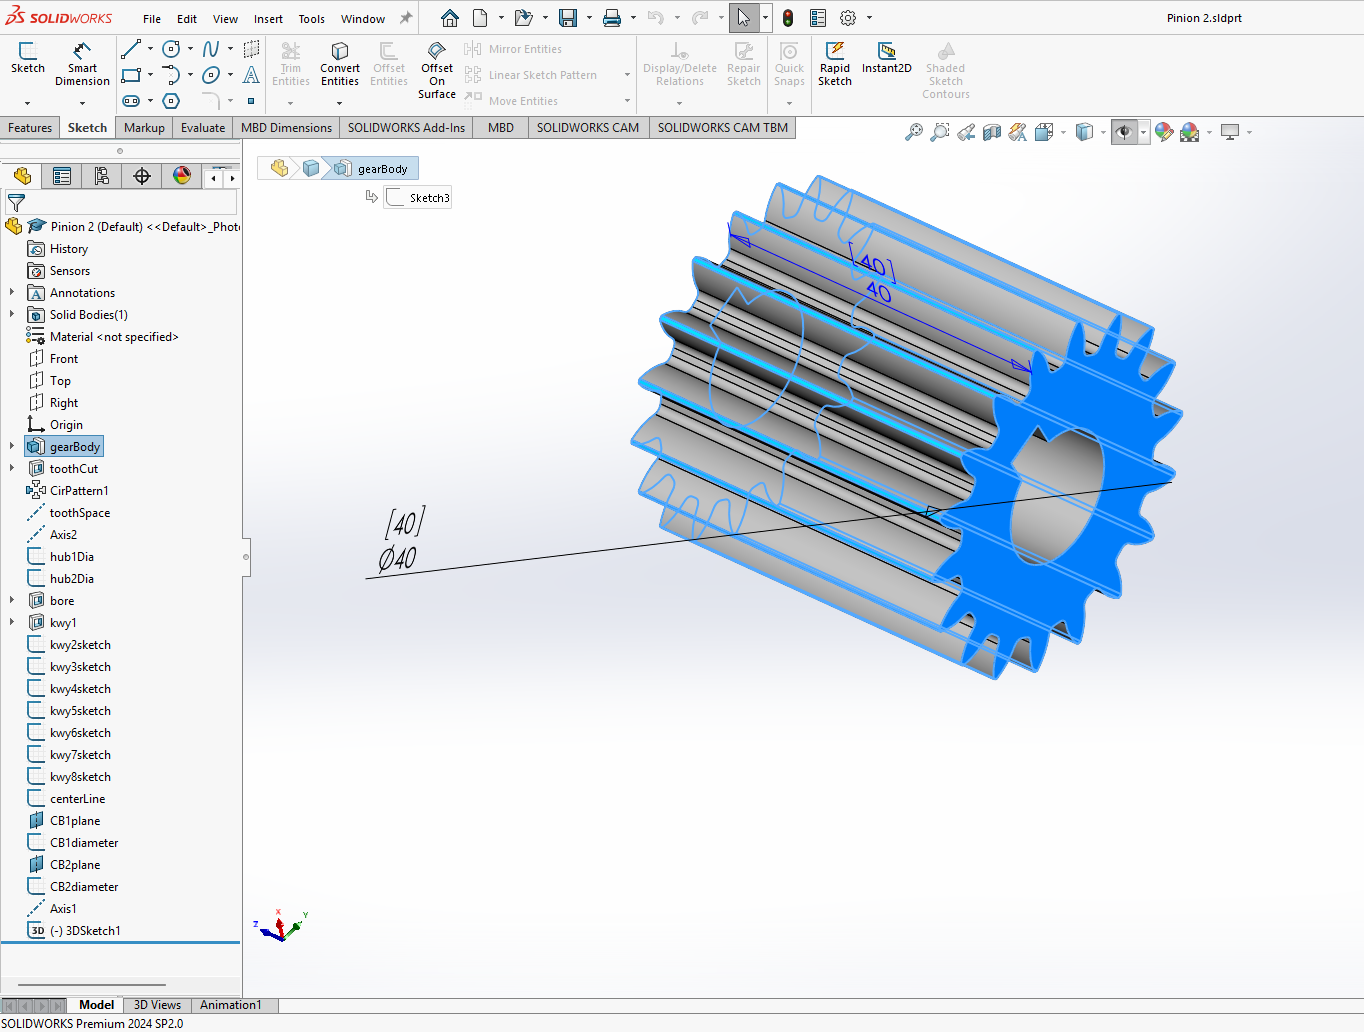
PICS/26.png
