rezaxr14/solar-panel-cleaning-robot/PICS/27.png

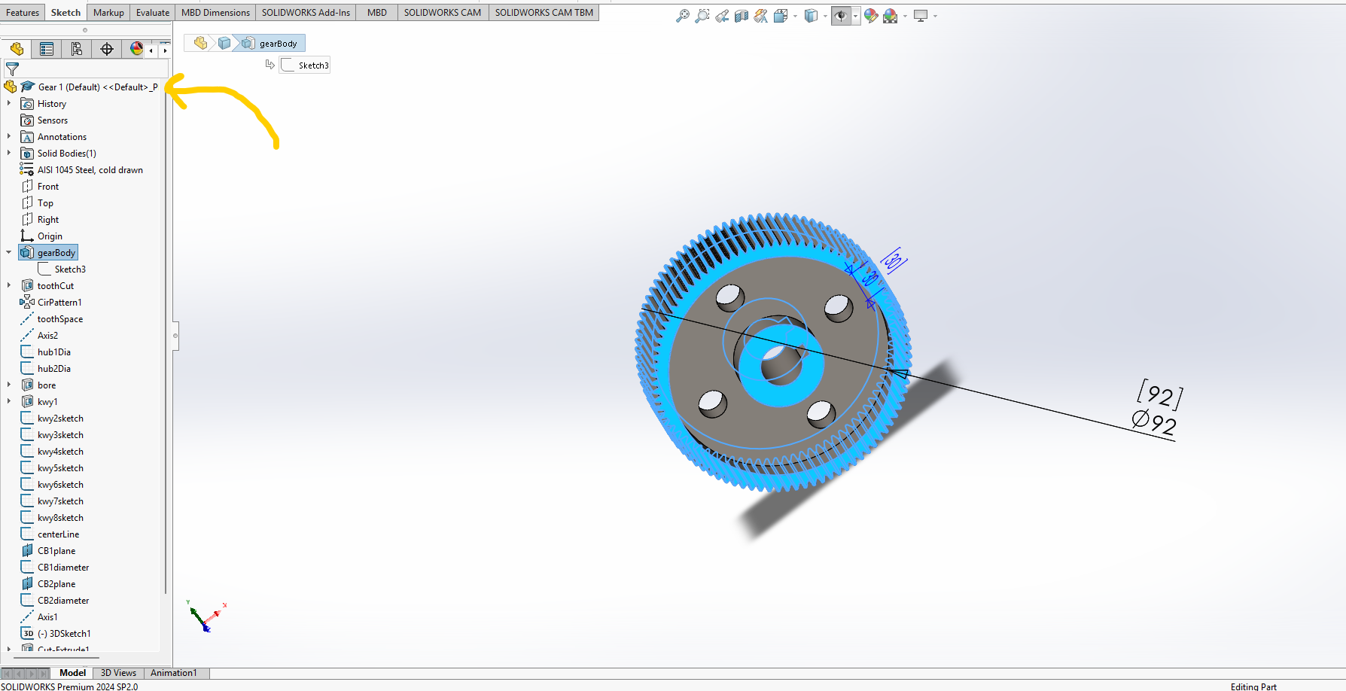
PICS/27.png
