rezaxr14/solar-panel-cleaning-robot/PICS/29.png

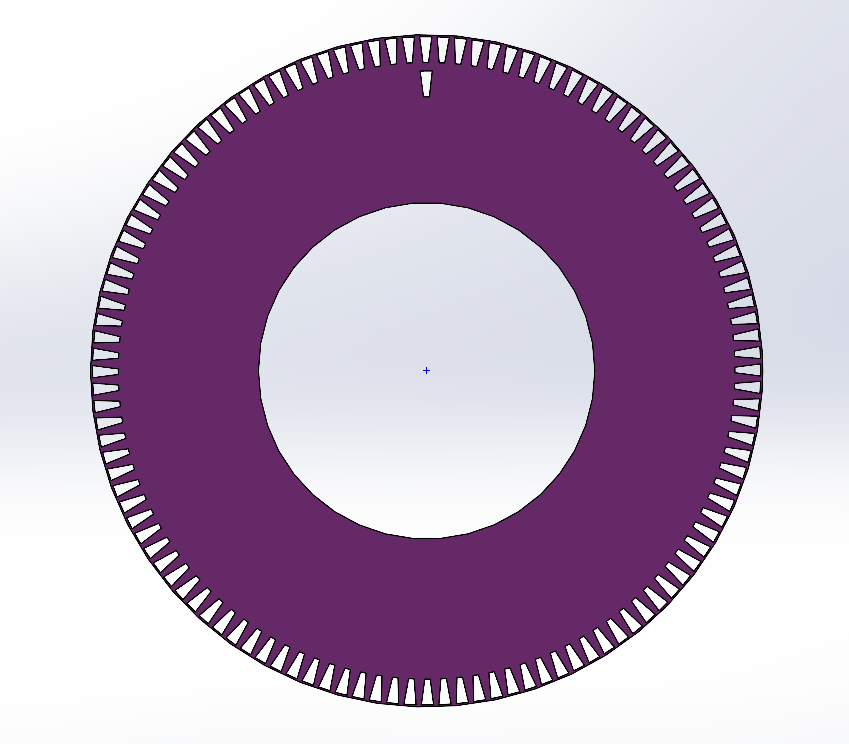
PICS/29.png
