rezaxr14/solar-panel-cleaning-robot/PICS/30.png

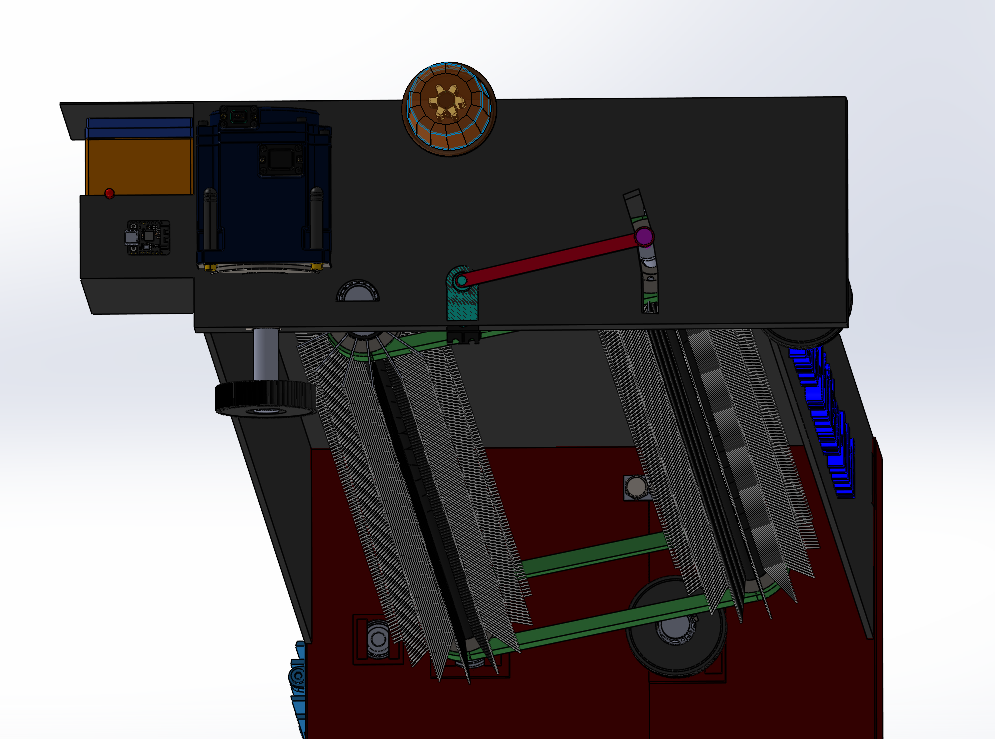
PICS/30.png
