rezaxr14/solar-panel-cleaning-robot/PICS/32.png

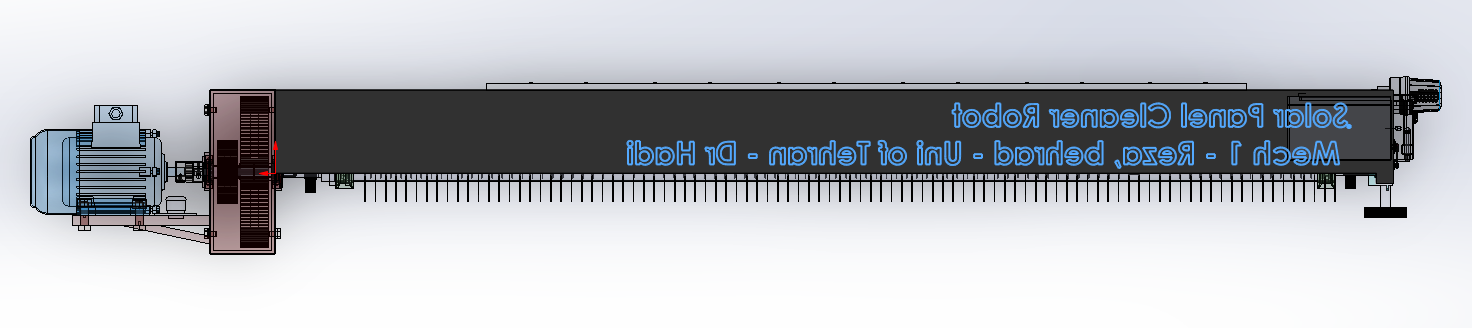
PICS/32.png
