rezaxr14/solar-panel-cleaning-robot/PICS/34.png

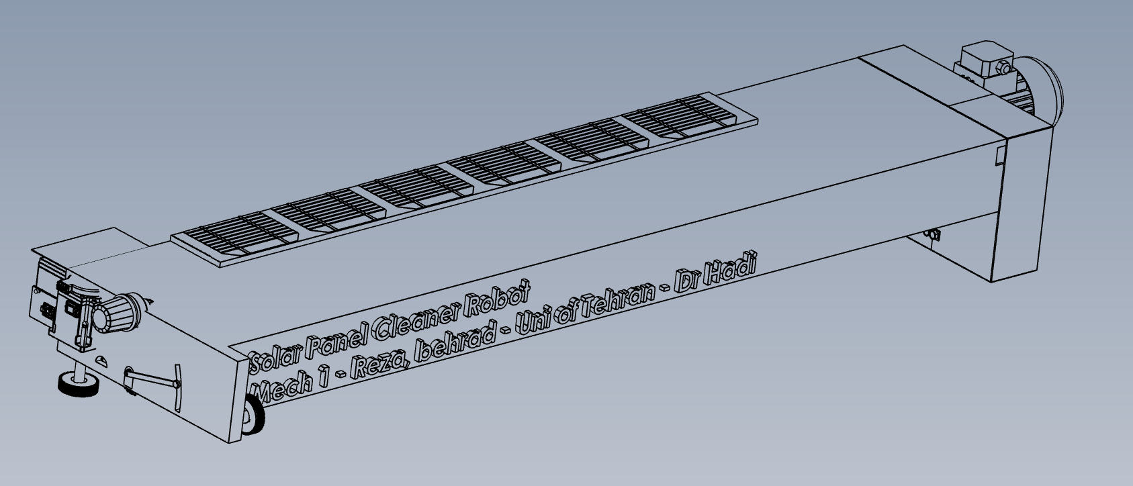
PICS/34.png
