rezaxr14/solar-panel-cleaning-robot/PICS/35.png

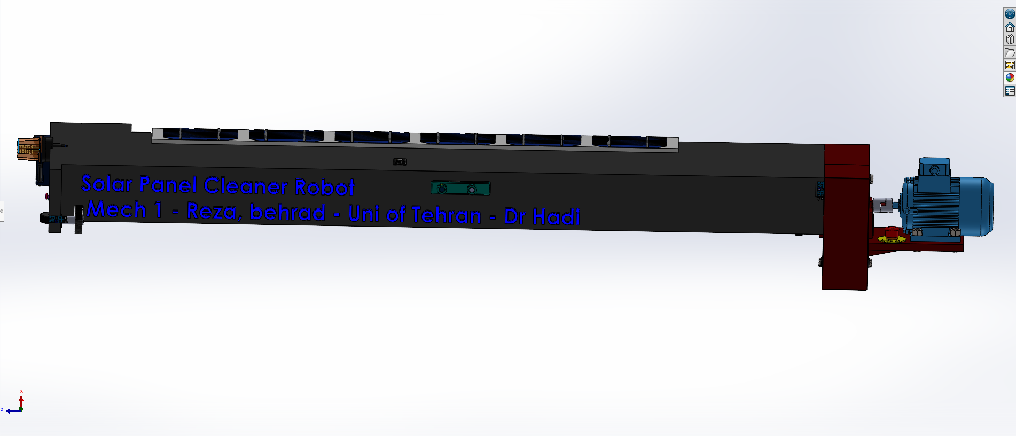
PICS/35.png
