rezaxr14/solar-panel-cleaning-robot/PICS/36.png

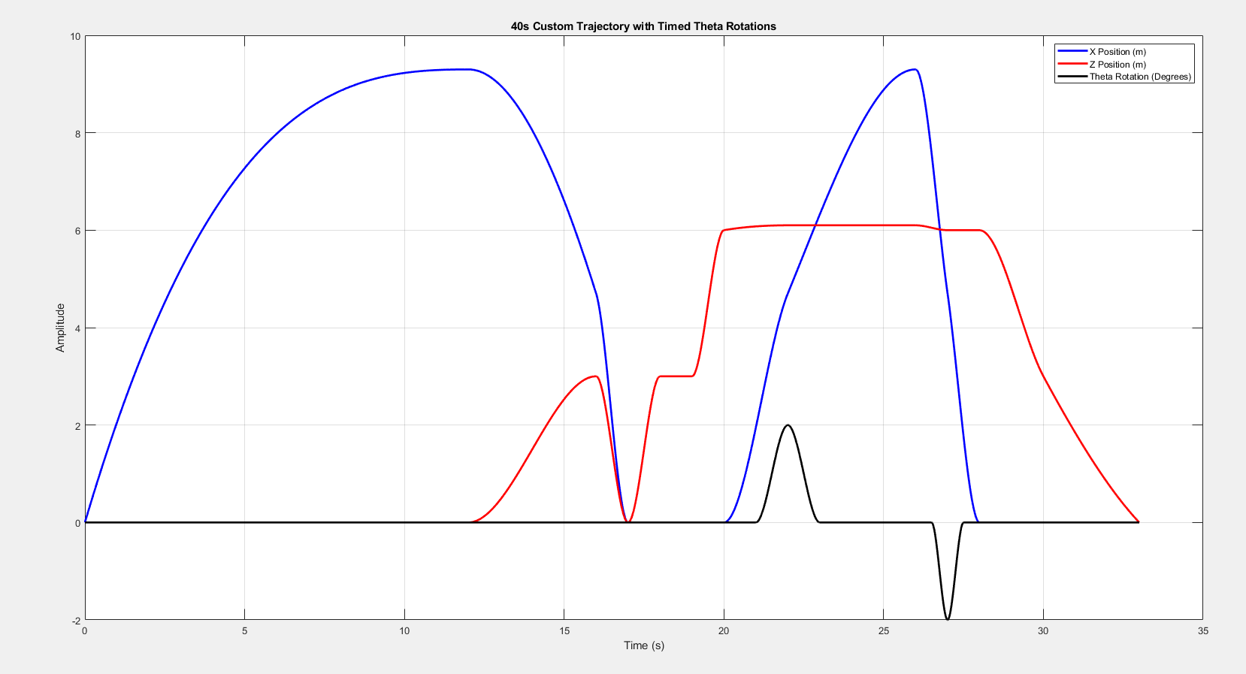
PICS/36.png
