rezaxr14/solar-panel-cleaning-robot/PICS/37.png

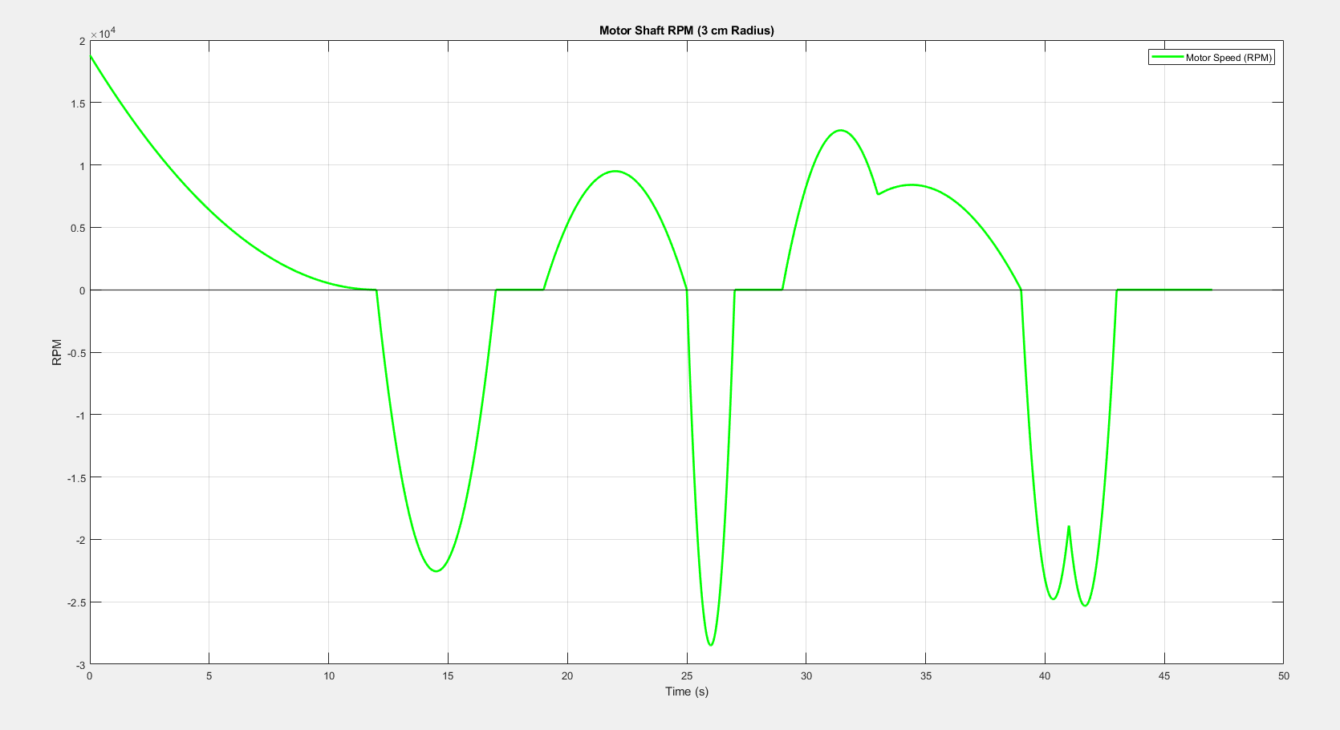
PICS/37.png
