rezaxr14/solar-panel-cleaning-robot/PICS/38.png

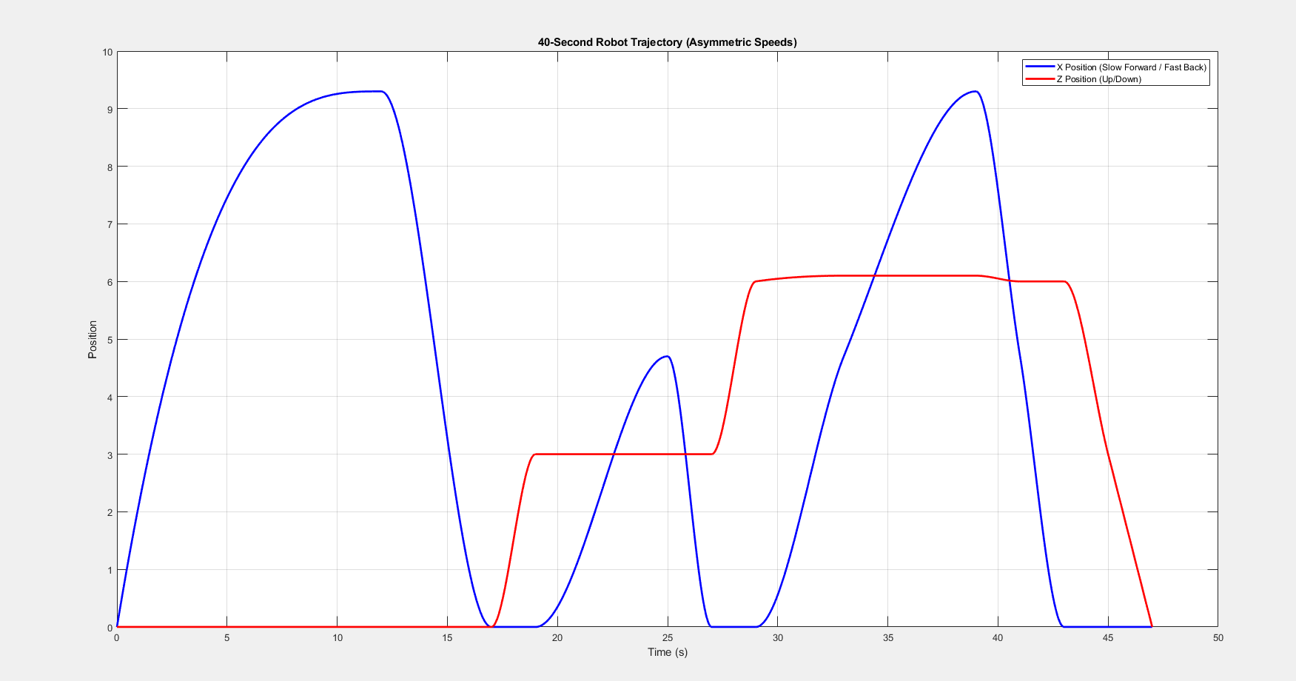
PICS/38.png
