rezaxr14/solar-panel-cleaning-robot/PICS/39.png

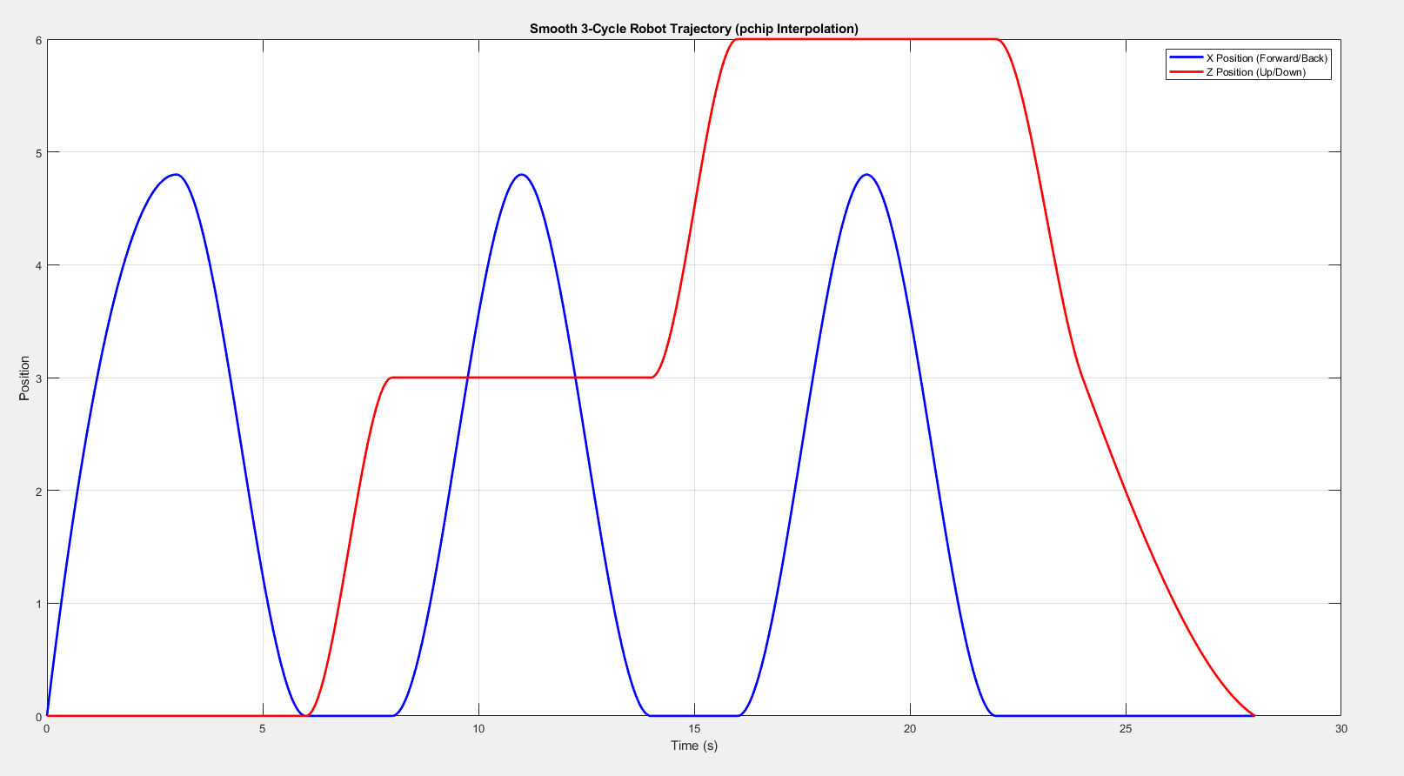
PICS/39.png
