rezaxr14/solar-panel-cleaning-robot/PICS/42.png

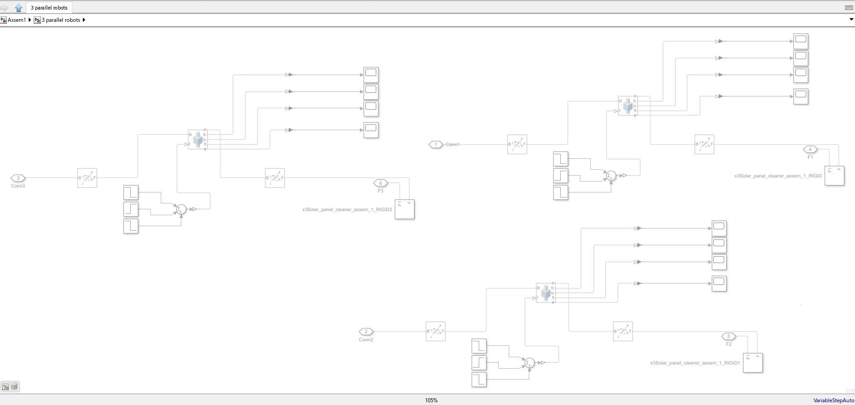
PICS/42.png
