rezaxr14/solar-panel-cleaning-robot/PICS/43.png

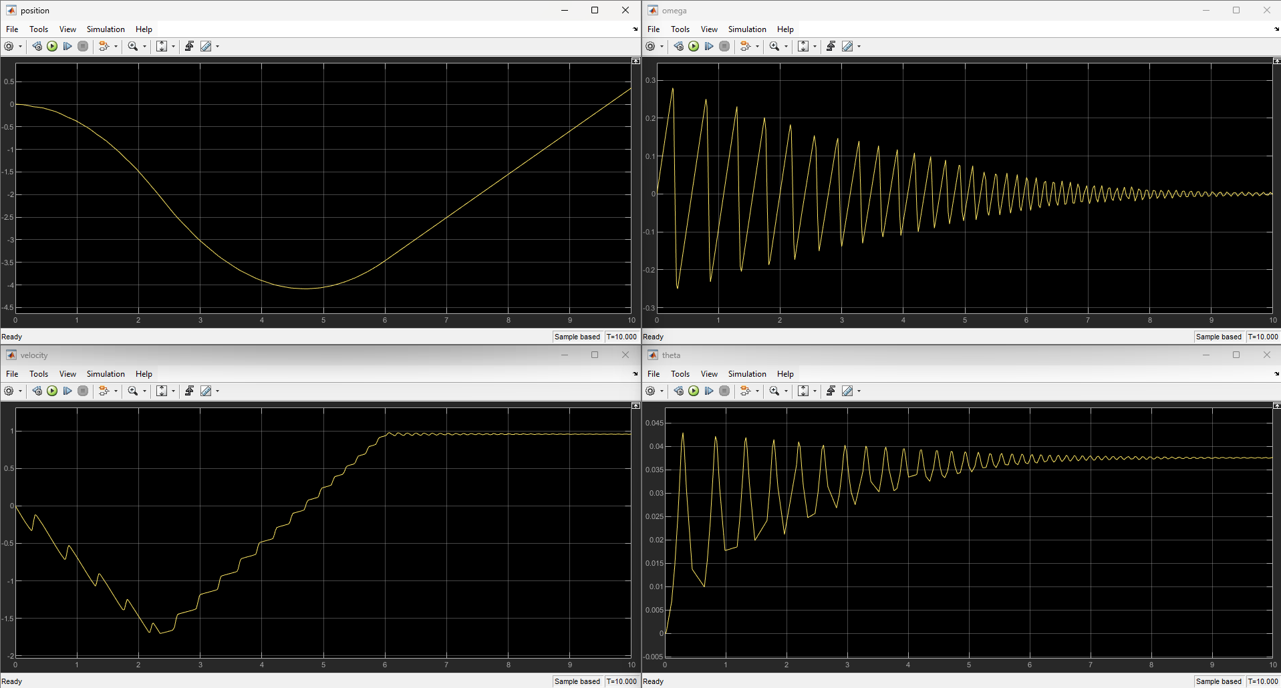
PICS/43.png
