rezaxr14/solar-panel-cleaning-robot/Solid/skf_bearing_6303_2.SLDASM

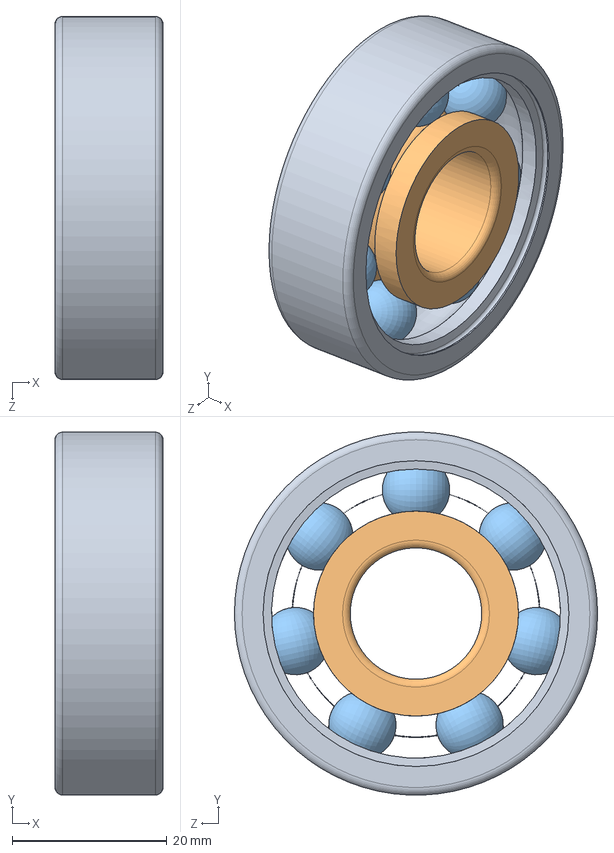
[picture p114: CAD file, 2026-04-28]
Solid/skf_bearing_6303_2.SLDASM
14.0 x 47.0 x 47.0 mm
skf_bearing_6303_2_01
skf_bearing_6303_2_02
skf_bearing_6303_2_03
