rezaxr14/solar-panel-cleaning-robot/Solid/FINAL_PROJECT_MECHATRONICS_1_Reza_behrad.SLDASM

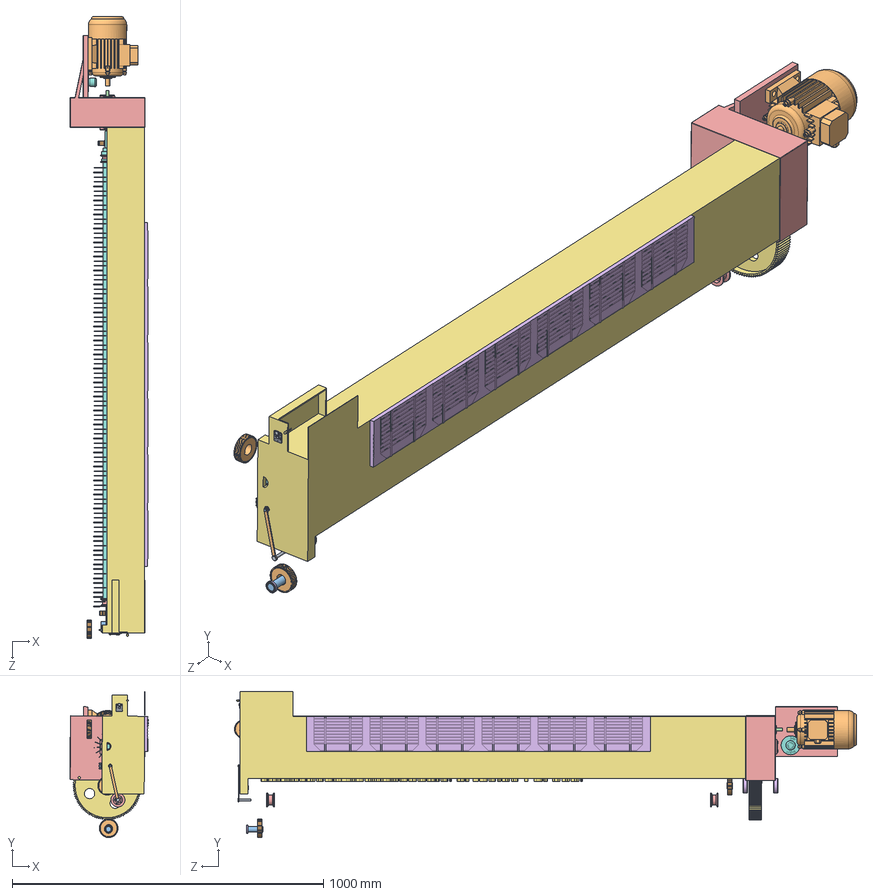
[picture p115: CAD file, 2026-04-28]
Solid/FINAL_PROJECT_MECHATRONICS_1_Reza_behrad.SLDASM
251.2 x 469.9 x 1999.8 mm
40mm key x 2
Gear 2
skf_bearing_6303_2_01 x 2
skf_bearing_6303_2_02 x 2
skf_bearing_6303_2_03 x 2
30mm key
18_dsh-20
13_dsh-15 x 3
Gear 1
skf_bearing_6301_2_01 x 2
skf_bearing_6301_2_02 x 2
skf_bearing_6301_2_03 x 2
Shaft 1
Pinion 1
skf_bearing_628-2z_2_01 x 2
skf_bearing_628-2z_2_02 x 2
skf_bearing_628-2z_2_03 x 2
skf_bearing_628-2z_2_04 x 2
skf_bearing_628-2z_2_05 x 2
drag
15_dsh-17 x 3
15mm key wheel x 2
Wheel x 3
15 mm key 3x3 for brush
Roller Brush
skf_bearing_61803_2_01 x 2
skf_bearing_61803_2_02 x 2
skf_bearing_61803_2_03 x 2
wheel small shaft
motor DC
Beetle ESP32-C6
ACİL STOP
led
Small solar panel
2SMALL_pulley x 4
rotary encoder
macro-servo2
servo link
pin
