rezaxr14/solar-panel-cleaning-robot/Solid/skf_bearing_61803_2.SLDASM

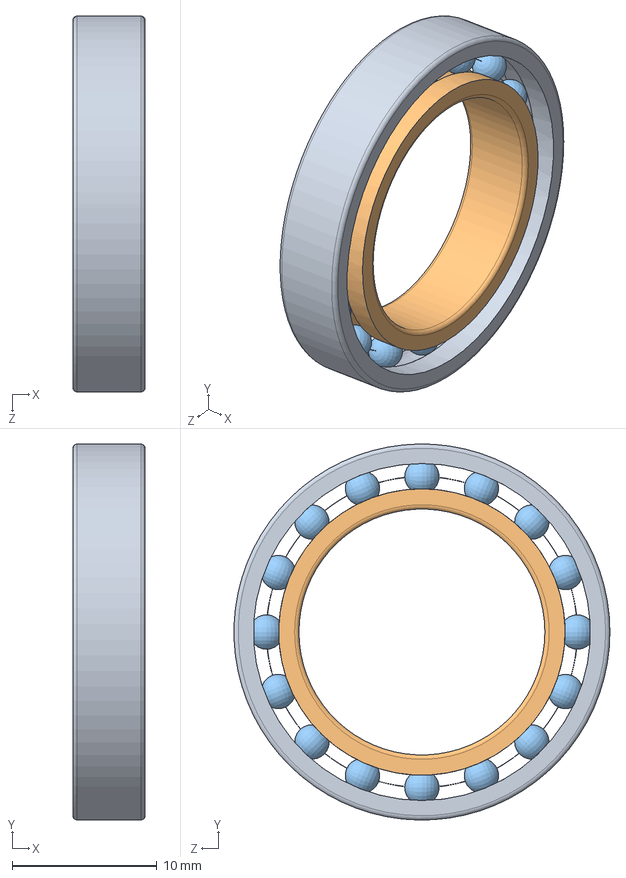
[picture p116: CAD file, 2026-04-28]
Solid/skf_bearing_61803_2.SLDASM
5.00 x 26.0 x 26.0 mm
skf_bearing_61803_2_01
skf_bearing_61803_2_02
skf_bearing_61803_2_03
