rezaxr14/solar-panel-cleaning-robot/Solid/Gear Box Assem.SLDASM

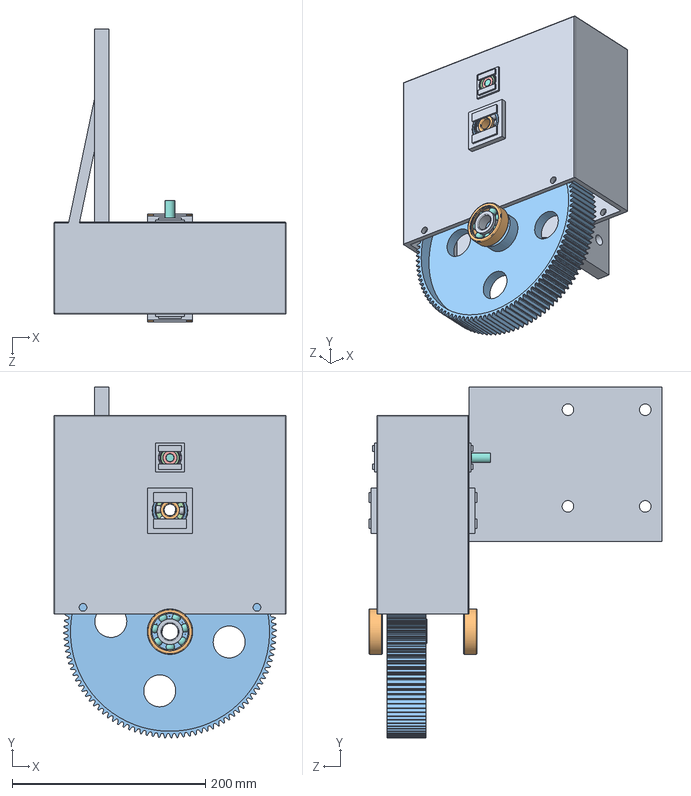
[picture p117: CAD file, 2026-04-28]
Solid/Gear Box Assem.SLDASM
240.0 x 363.2 x 303.5 mm
40mm key x 2
Gear 2
skf_bearing_6303_2_01 x 2
skf_bearing_6303_2_02 x 2
skf_bearing_6303_2_03 x 2
30mm key
18_dsh-20
13_dsh-15 x 3
Gear 1
skf_bearing_6301_2_01 x 2
skf_bearing_6301_2_02 x 2
skf_bearing_6301_2_03 x 2
Shaft 1
Pinion 1
skf_bearing_628-2z_2_01 x 2
skf_bearing_628-2z_2_02 x 2
skf_bearing_628-2z_2_03 x 2
skf_bearing_628-2z_2_04 x 2
skf_bearing_628-2z_2_05 x 2
drag
