rezaxr14/solar-panel-cleaning-robot/Solid/skf_bearing_6301_2.SLDASM

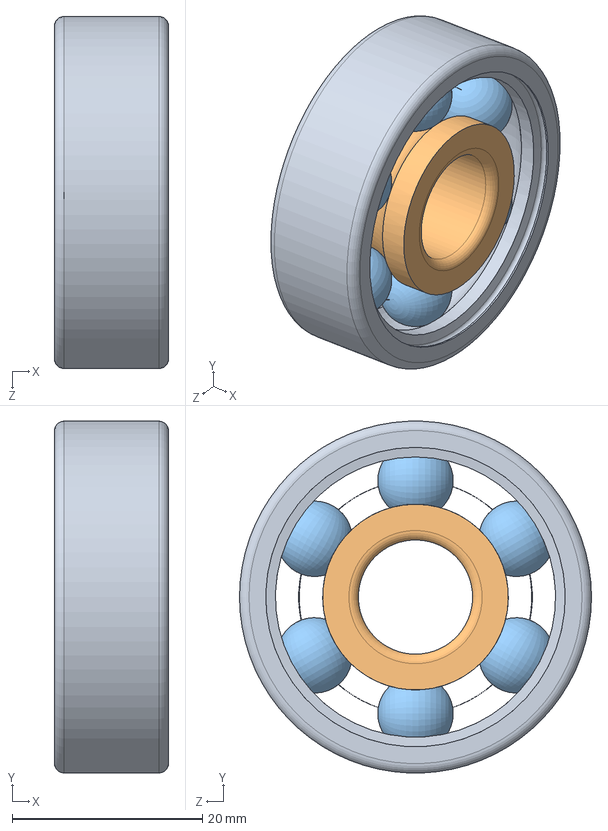
[picture p118: CAD file, 2026-04-28]
Solid/skf_bearing_6301_2.SLDASM
12.0 x 37.0 x 37.0 mm
skf_bearing_6301_2_01
skf_bearing_6301_2_02
skf_bearing_6301_2_03
