rezaxr14/solar-panel-cleaning-robot/Solid/skf_bearing_628-2z_2.SLDASM

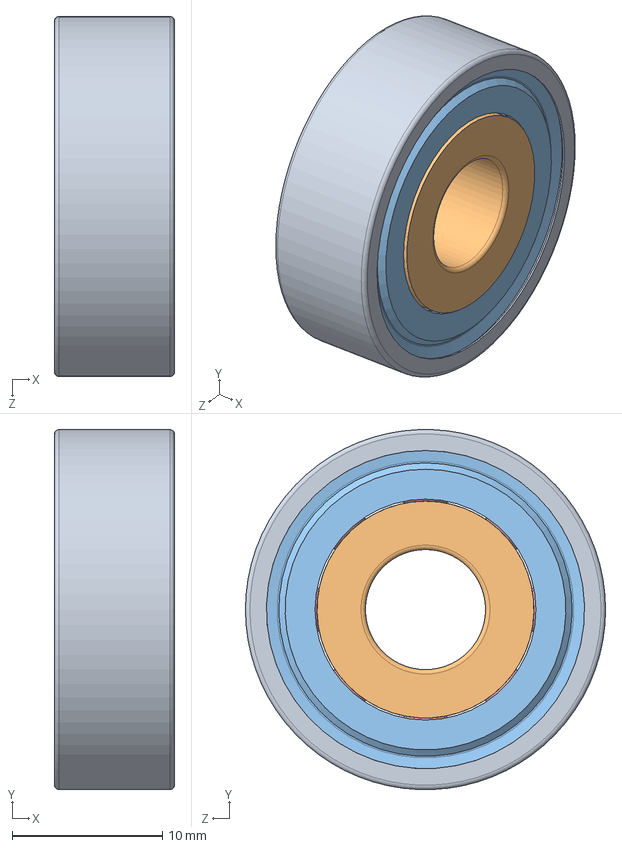
[picture p119: CAD file, 2026-04-28]
Solid/skf_bearing_628-2z_2.SLDASM
8.00 x 24.0 x 24.0 mm
skf_bearing_628-2z_2_01
skf_bearing_628-2z_2_02
skf_bearing_628-2z_2_03
skf_bearing_628-2z_2_04
skf_bearing_628-2z_2_05
