rezaxr14/solar-panel-cleaning-robot/Solid/Assem3.SLDASM

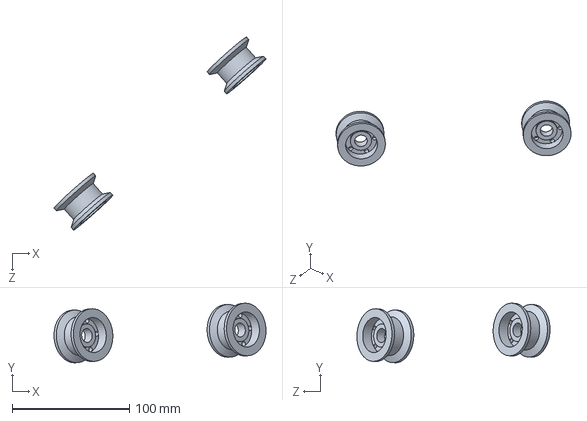
[picture p120: CAD file, 2026-04-28]
Solid/Assem3.SLDASM
181.0 x 50.9 x 164.8 mm
2SMALL_pulley x 2
