rezaxr14/solar-panel-cleaning-robot/MATLAB/cope_Default_sldprt.STEP

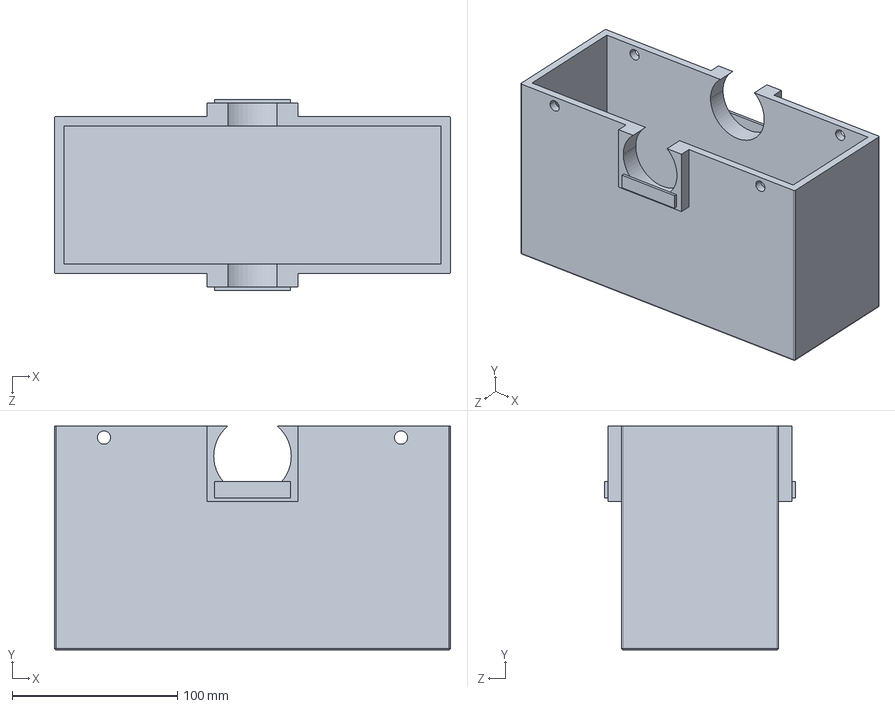
[picture p121: CAD file, 2026-04-28]
MATLAB/cope_Default_sldprt.STEP
240.0 x 135.7 x 115.8 mm
