rezaxr14/solar-panel-cleaning-robot/Solid/Roller Brush.SLDPRT

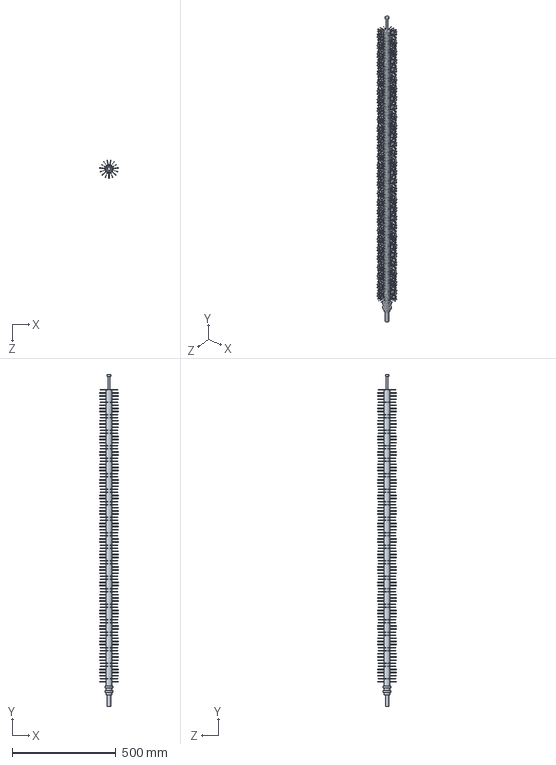
[picture p122: CAD file, 2026-04-28]
Solid/Roller Brush.SLDPRT
87.6 x 1603.0 x 87.1 mm
