rezaxr14/solar-panel-cleaning-robot/MATLAB/skf_bearing_61803_2_01_Default_sldprt.STEP

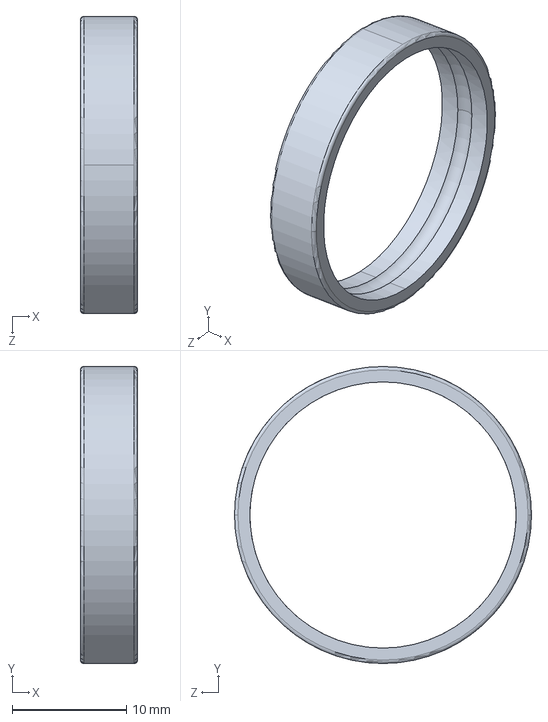
[picture p123: CAD file, 2026-04-28]
MATLAB/skf_bearing_61803_2_01_Default_sldprt.STEP
5.00 x 26.0 x 26.0 mm
