rezaxr14/solar-panel-cleaning-robot/MATLAB/skf_bearing_628-2z_2_04_Default_sldprt.STEP

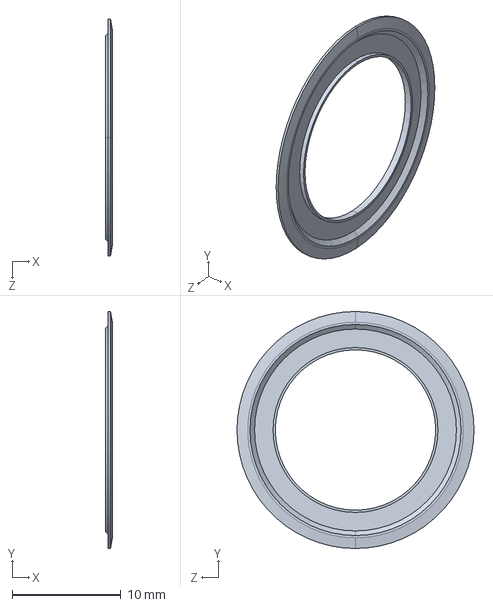
[picture p124: CAD file, 2026-04-28]
MATLAB/skf_bearing_628-2z_2_04_Default_sldprt.STEP
0.63 x 21.8 x 21.8 mm
