rezaxr14/solar-panel-cleaning-robot/MATLAB/Body-HR12-9_Default_sldprt.STEP

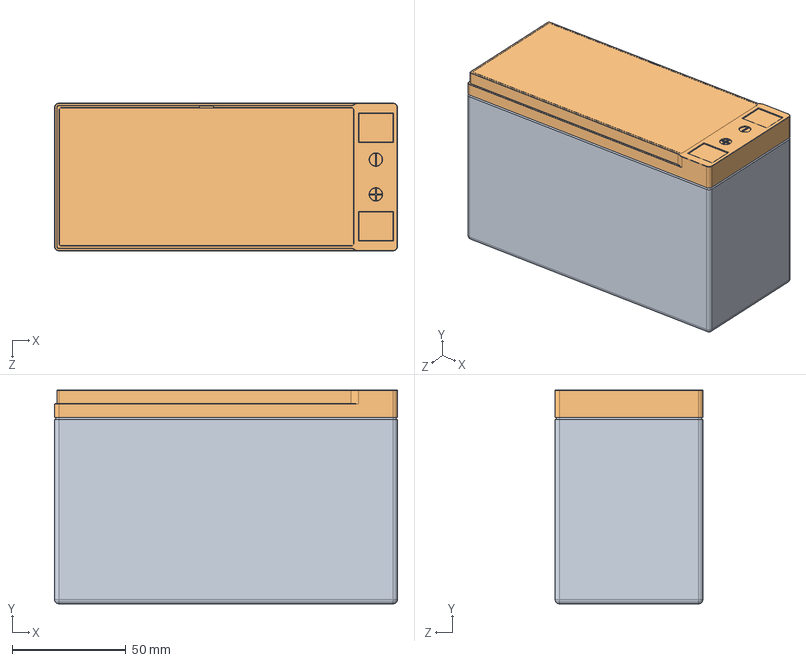
[picture p125: CAD file, 2026-04-28]
MATLAB/Body-HR12-9_Default_sldprt.STEP
150.8 x 94.0 x 65.0 mm
