rezaxr14/solar-panel-cleaning-robot/Solid/skf_bearing_61803_2_02.SLDPRT

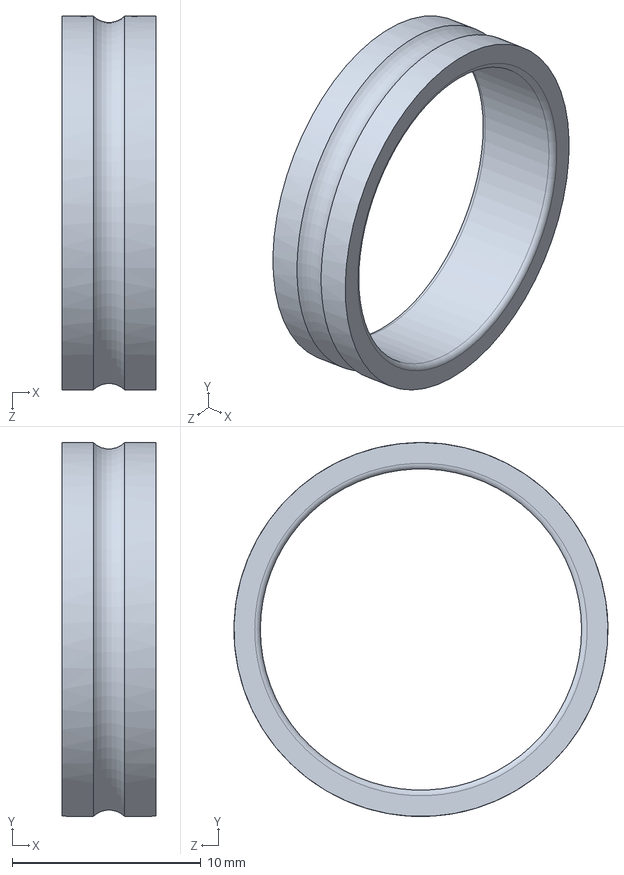
[picture p126: CAD file, 2026-04-28]
Solid/skf_bearing_61803_2_02.SLDPRT
5.00 x 19.8 x 19.8 mm
