rezaxr14/solar-panel-cleaning-robot/MATLAB/Belt2-3-Assem2_Default_sldprt.STEP

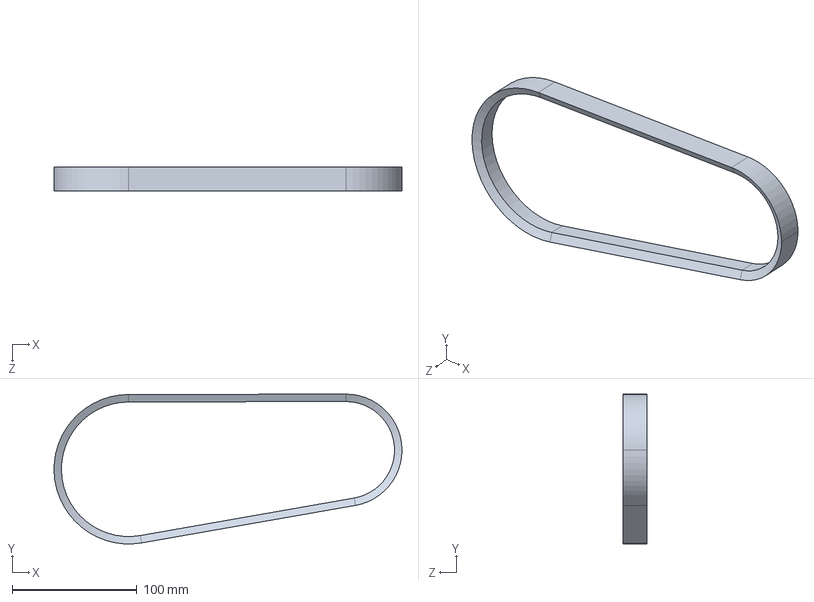
[picture p127: CAD file, 2026-04-28]
MATLAB/Belt2-3-Assem2_Default_sldprt.STEP
279.3 x 120.3 x 19.0 mm
