rezaxr14/solar-panel-cleaning-robot/Solid/skf_bearing_6303_2_01.SLDPRT

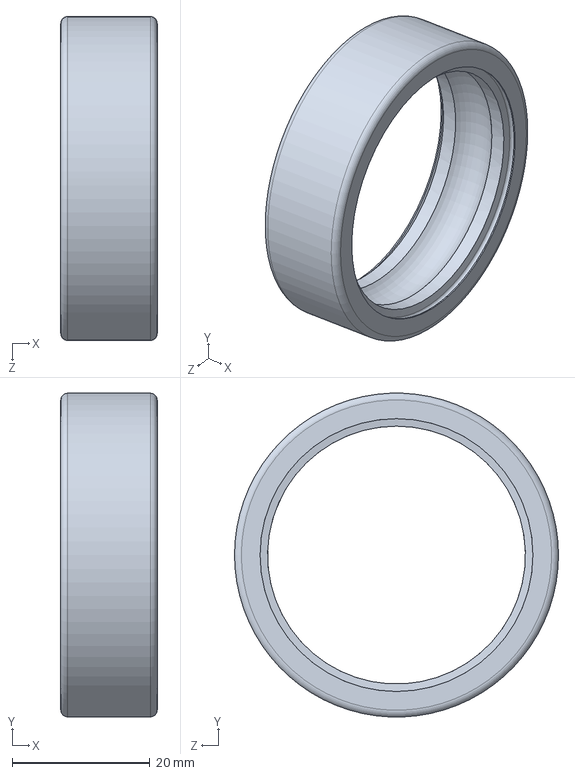
[picture p128: CAD file, 2026-04-28]
Solid/skf_bearing_6303_2_01.SLDPRT
14.0 x 47.0 x 47.0 mm
