rezaxr14/solar-panel-cleaning-robot/MATLAB/skf_bearing_6301_2_01_Default_sldprt.STEP

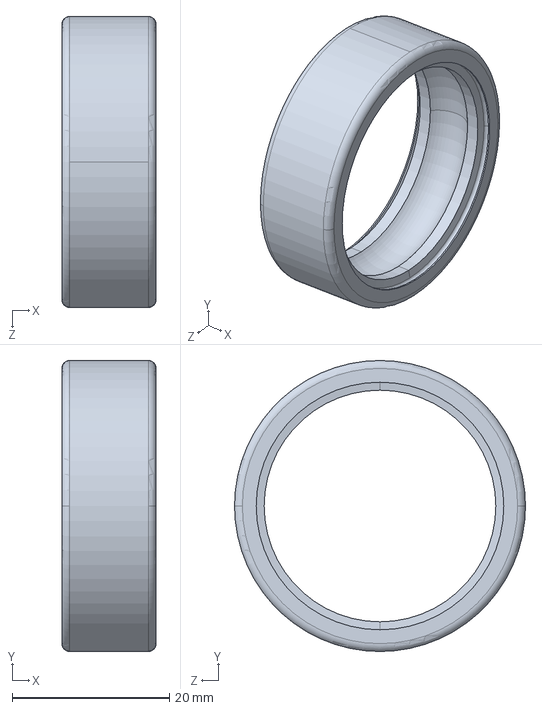
[picture p129: CAD file, 2026-04-28]
MATLAB/skf_bearing_6301_2_01_Default_sldprt.STEP
12.0 x 37.0 x 37.0 mm
