rezaxr14/solar-panel-cleaning-robot/Solid/wheel small shaft.SLDPRT

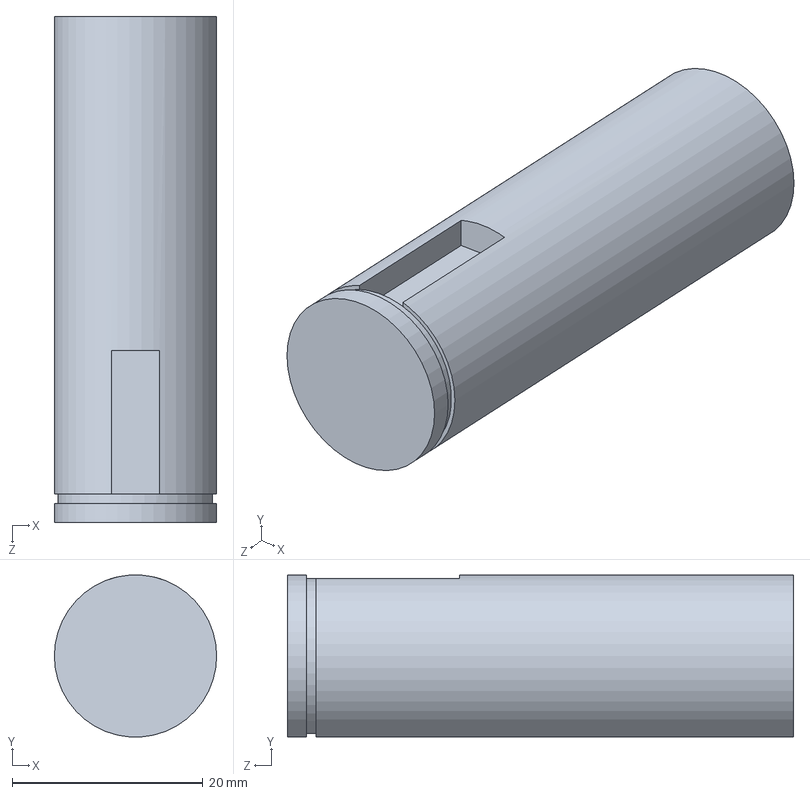
[picture p130: CAD file, 2026-04-28]
Solid/wheel small shaft.SLDPRT
17.0 x 17.0 x 53.0 mm
