rezaxr14/solar-panel-cleaning-robot/MATLAB/led_Varsayilan_sldprt.STEP

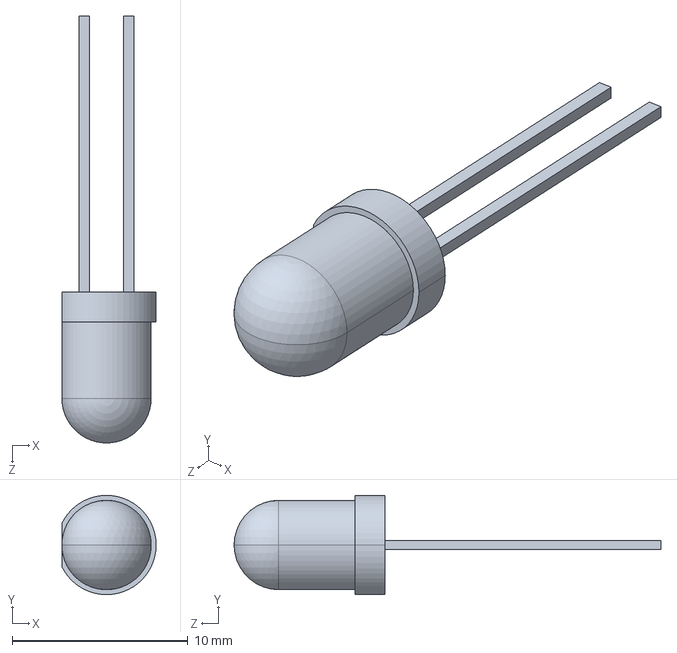
[picture p131: CAD file, 2026-04-28]
MATLAB/led_Varsayilan_sldprt.STEP
5.37 x 5.65 x 24.3 mm
