rezaxr14/solar-panel-cleaning-robot/Solid/skf_bearing_6301_2_03.SLDPRT

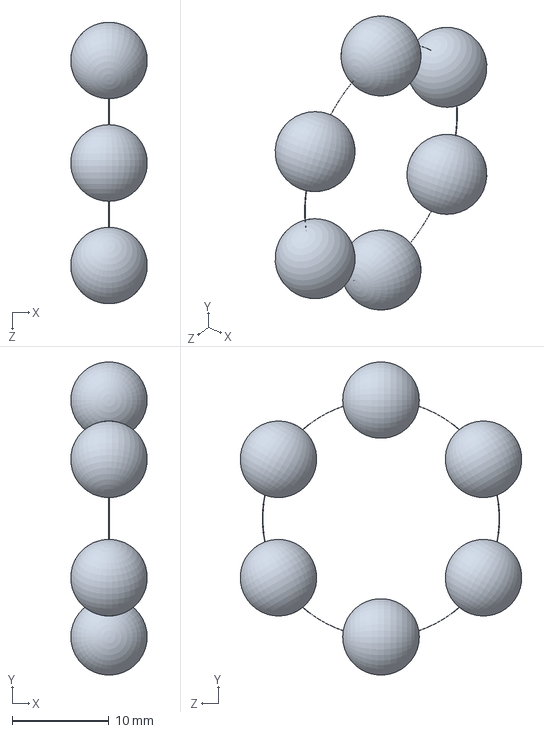
[picture p132: CAD file, 2026-04-28]
Solid/skf_bearing_6301_2_03.SLDPRT
7.91 x 32.4 x 29.1 mm
