rezaxr14/solar-panel-cleaning-robot/MATLAB/box_Default_sldprt.STEP

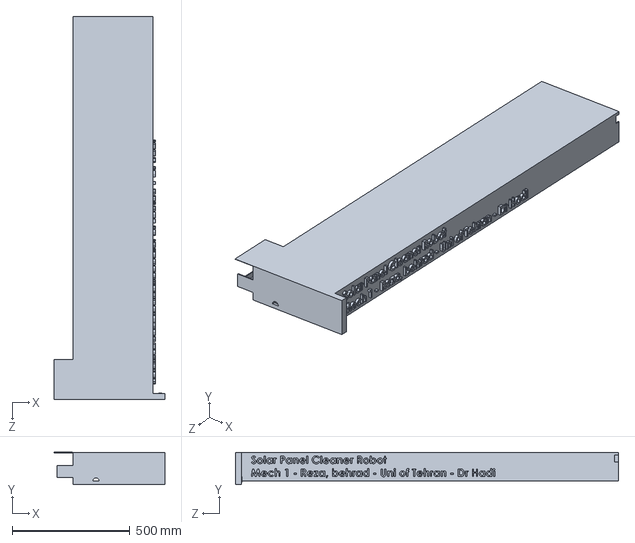
[picture p133: CAD file, 2026-04-28]
MATLAB/box_Default_sldprt.STEP
470.0 x 136.0 x 1625.0 mm
