rezaxr14/solar-panel-cleaning-robot/Solid/Pinion 1.SLDPRT

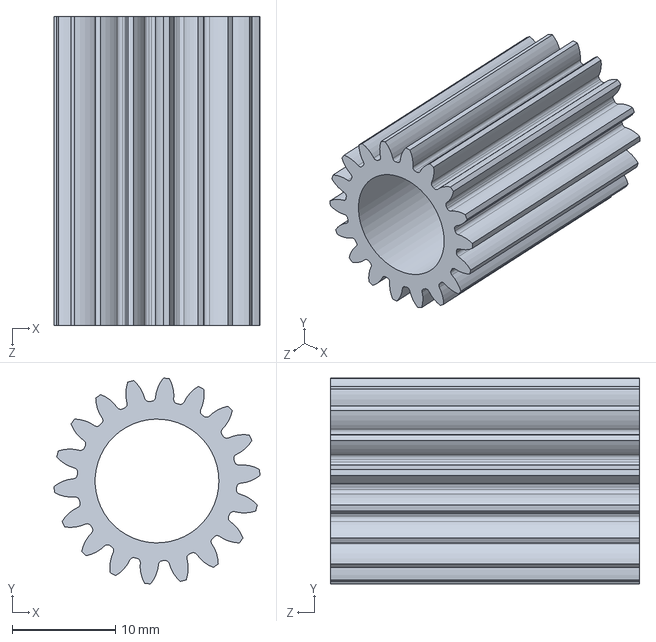
[picture p134: CAD file, 2026-04-28]
Solid/Pinion 1.SLDPRT
20.0 x 20.0 x 30.0 mm
