rezaxr14/solar-panel-cleaning-robot/MATLAB/18_dsh-20_Default_sldprt.STEP

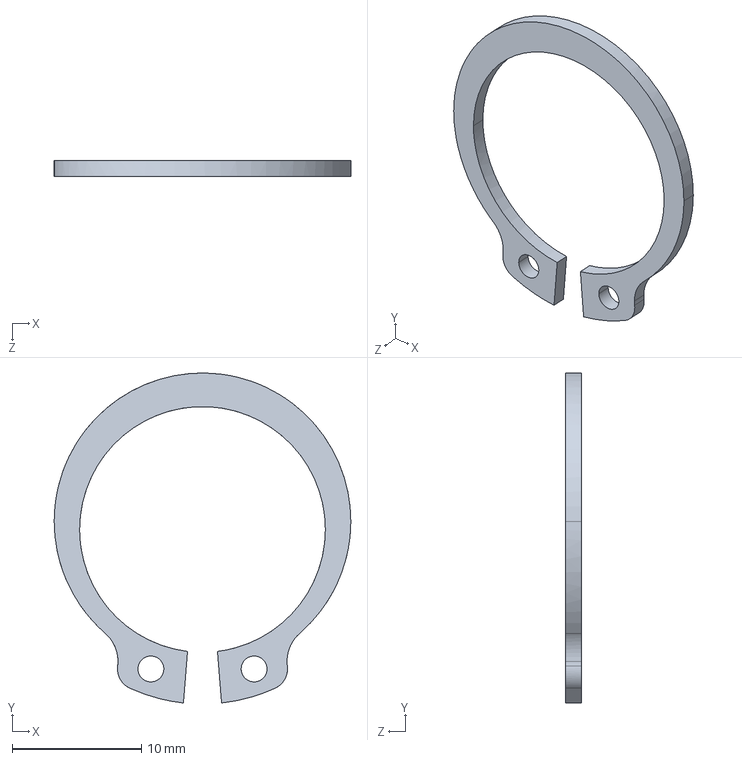
[picture p135: CAD file, 2026-04-28]
MATLAB/18_dsh-20_Default_sldprt.STEP
22.9 x 25.5 x 1.20 mm
