rezaxr14/solar-panel-cleaning-robot/Solid/pin.SLDPRT

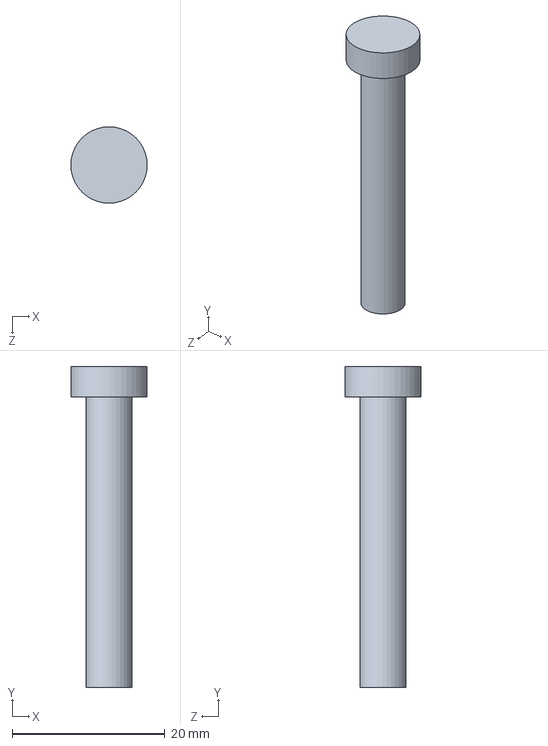
[picture p136: CAD file, 2026-04-28]
Solid/pin.SLDPRT
10.0 x 42.0 x 10.0 mm
