rezaxr14/solar-panel-cleaning-robot/MATLAB/Stand 2_Default_sldprt.STEP

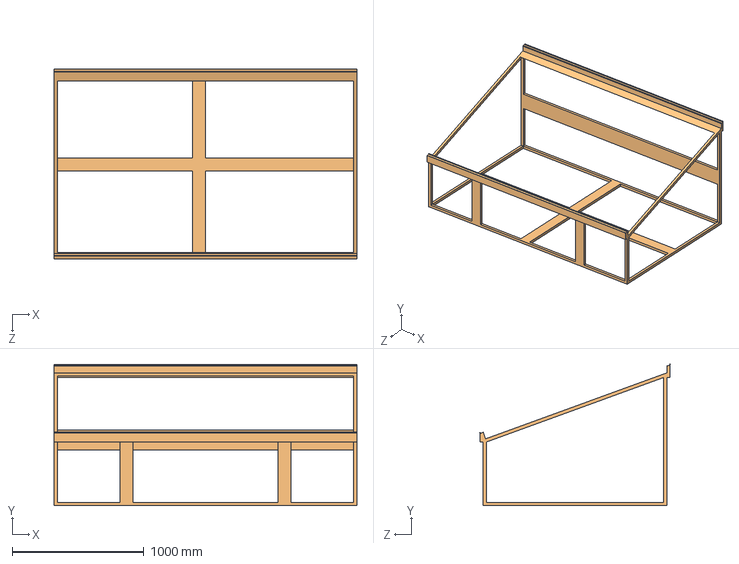
[picture p137: CAD file, 2026-04-28]
MATLAB/Stand 2_Default_sldprt.STEP
2300.0 x 1072.2 x 1445.4 mm
