rezaxr14/solar-panel-cleaning-robot/Solid/skf_bearing_628-2z_2_05.SLDPRT

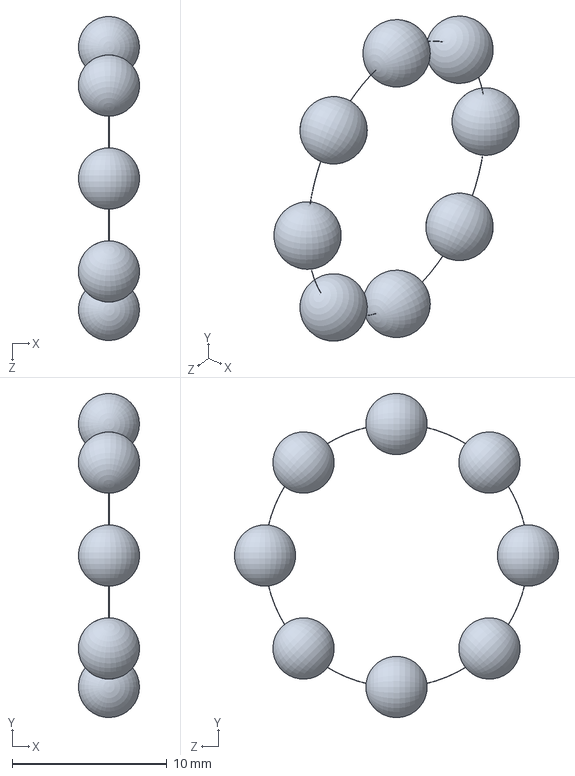
[picture p138: CAD file, 2026-04-28]
Solid/skf_bearing_628-2z_2_05.SLDPRT
3.94 x 20.9 x 20.9 mm
