rezaxr14/solar-panel-cleaning-robot/MATLAB/railsStand 55.STEP

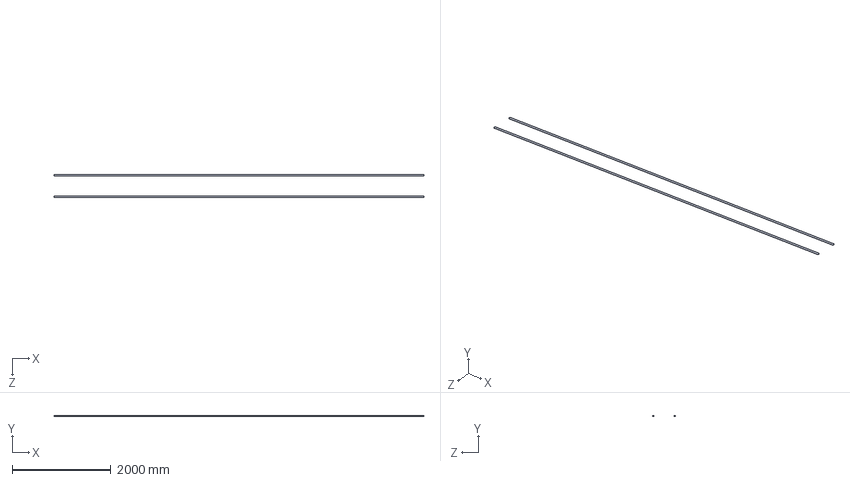
[picture p139: CAD file, 2026-04-28]
MATLAB/railsStand 55.STEP
7500.0 x 16.9 x 470.0 mm
