rezaxr14/solar-panel-cleaning-robot/Solid/skf_bearing_6301_2_02.SLDPRT

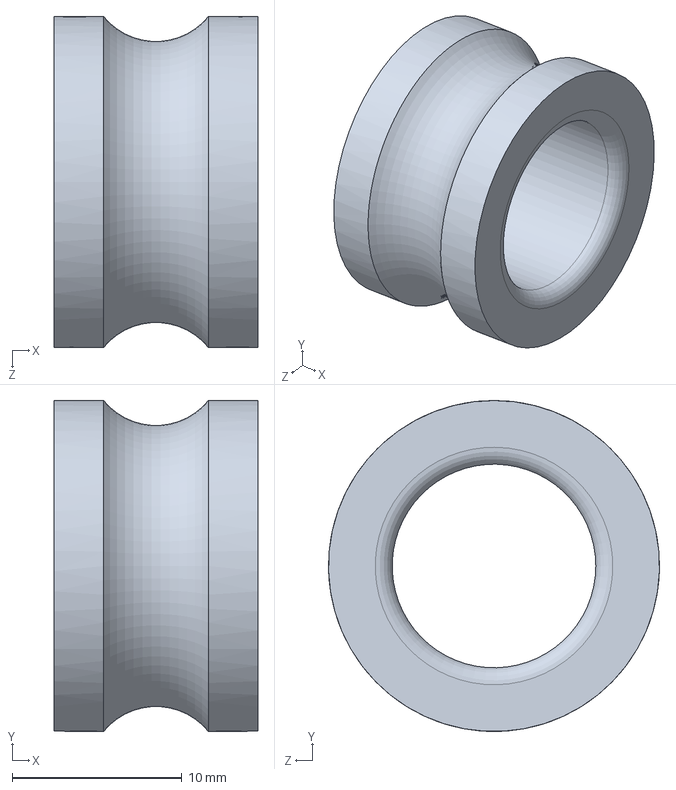
[picture p140: CAD file, 2026-04-28]
Solid/skf_bearing_6301_2_02.SLDPRT
12.0 x 19.5 x 19.5 mm
