rezaxr14/solar-panel-cleaning-robot/MATLAB/Shaft 2_Default_sldprt.STEP

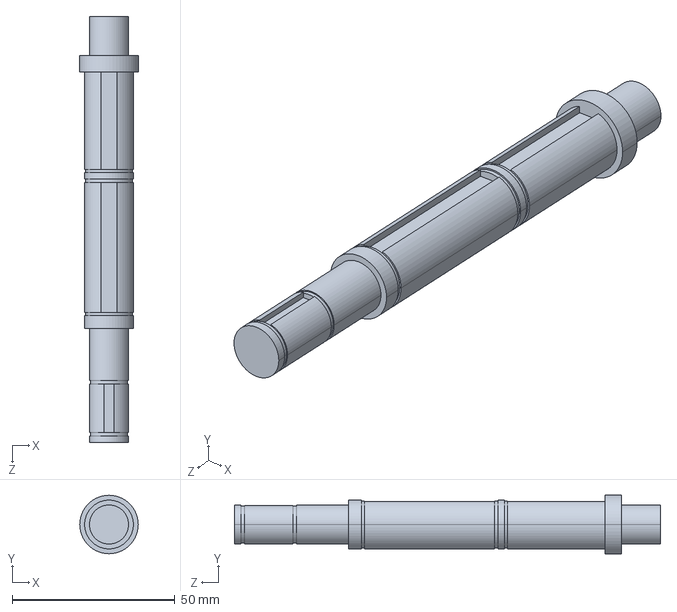
[picture p141: CAD file, 2026-04-28]
MATLAB/Shaft 2_Default_sldprt.STEP
18.0 x 18.0 x 131.0 mm
