rezaxr14/solar-panel-cleaning-robot/Solid/zedmini_camera.stp

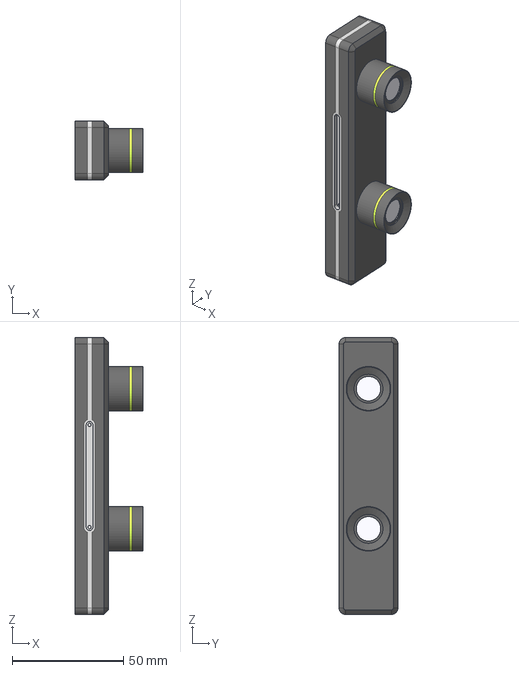
[picture p142: CAD file, 2026-04-28]
Solid/zedmini_camera.stp
30.5 x 26.5 x 124.5 mm
