rezaxr14/solar-panel-cleaning-robot/MATLAB/15_dsh-17_Default_sldprt.STEP

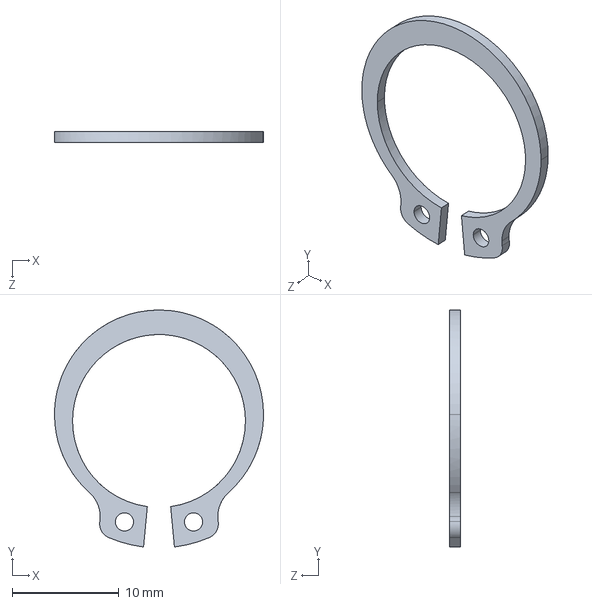
[picture p143: CAD file, 2026-04-28]
MATLAB/15_dsh-17_Default_sldprt.STEP
19.6 x 22.2 x 1.00 mm
