rezaxr14/solar-panel-cleaning-robot/MATLAB/Belt4-2-Assem3_Default_sldprt.STEP

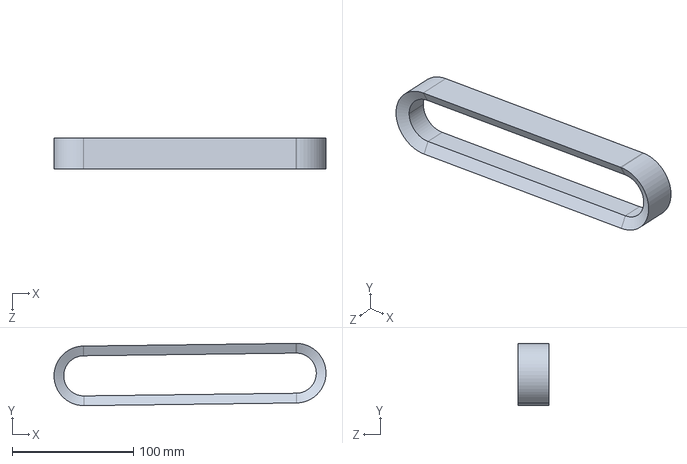
[picture p144: CAD file, 2026-04-28]
MATLAB/Belt4-2-Assem3_Default_sldprt.STEP
224.0 x 51.3 x 25.4 mm
