rezaxr14/solar-panel-cleaning-robot/MATLAB/10_dsh-12_Default_sldprt.STEP

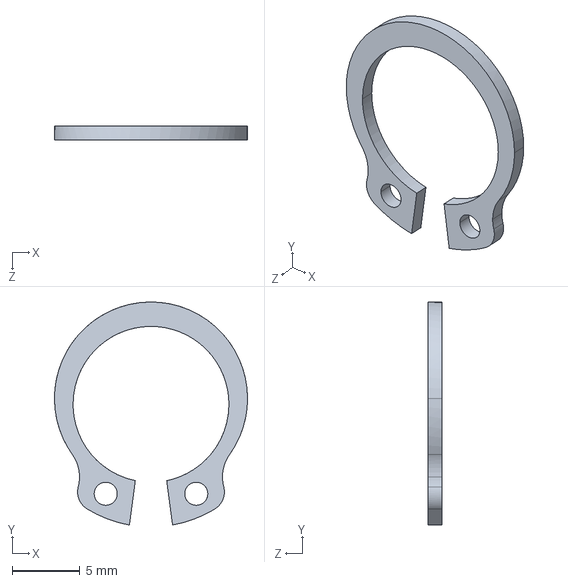
[picture p145: CAD file, 2026-04-28]
MATLAB/10_dsh-12_Default_sldprt.STEP
14.2 x 16.5 x 1.00 mm
