rezaxr14/solar-panel-cleaning-robot/MATLAB/drag_Default_sldprt.STEP

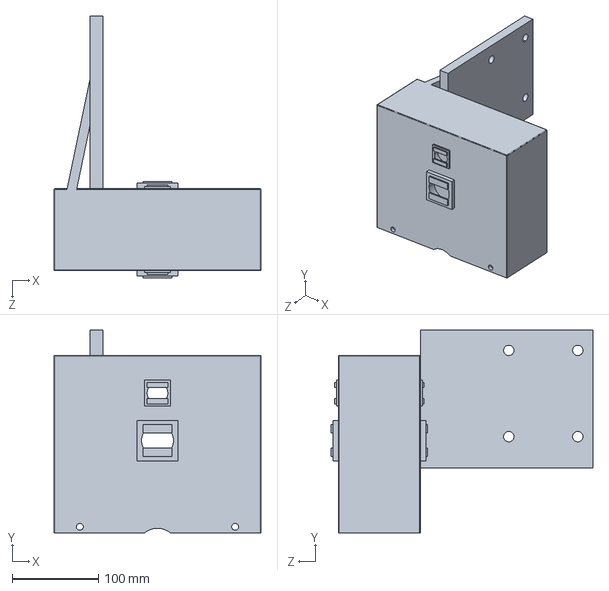
[picture p146: CAD file, 2026-04-28]
MATLAB/drag_Default_sldprt.STEP
240.0 x 235.0 x 303.5 mm
