rezaxr14/solar-panel-cleaning-robot/Solid/rotary encoder.SLDPRT

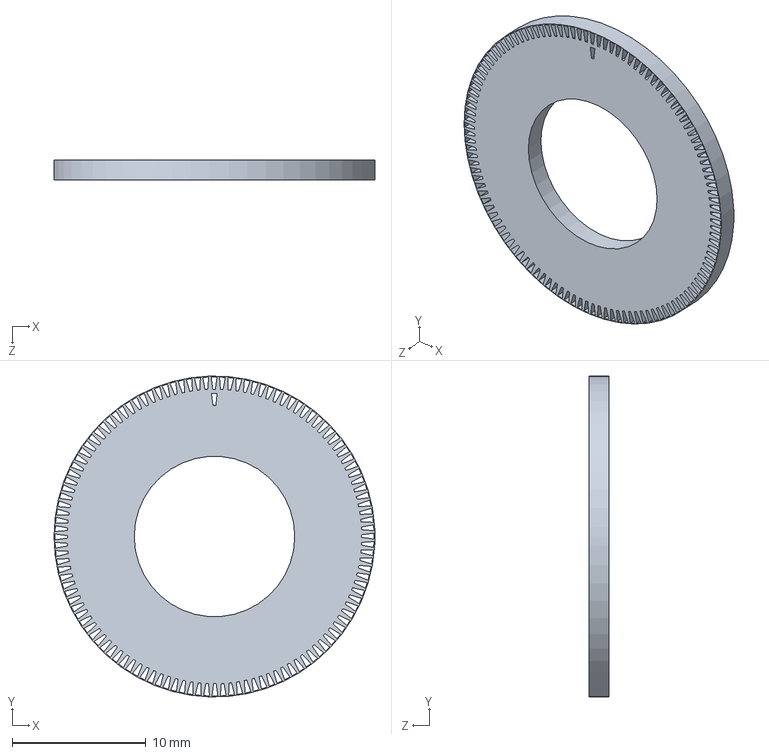
[picture p147: CAD file, 2026-04-28]
Solid/rotary encoder.SLDPRT
24.0 x 24.0 x 1.50 mm
