rezaxr14/solar-panel-cleaning-robot/MATLAB/Plum coupling 14-10mm_Default_sldprt.STEP

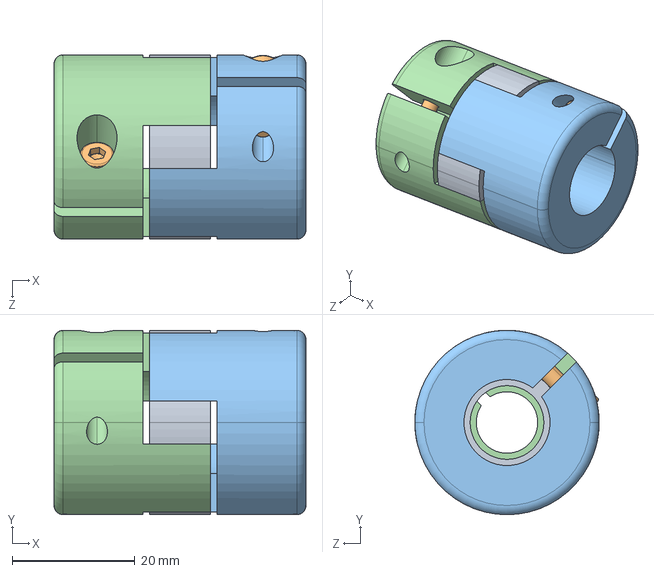
[picture p148: CAD file, 2026-04-28]
MATLAB/Plum coupling 14-10mm_Default_sldprt.STEP
41.0 x 30.0 x 30.0 mm
