rezaxr14/solar-panel-cleaning-robot/Solid/Gear 1.SLDPRT

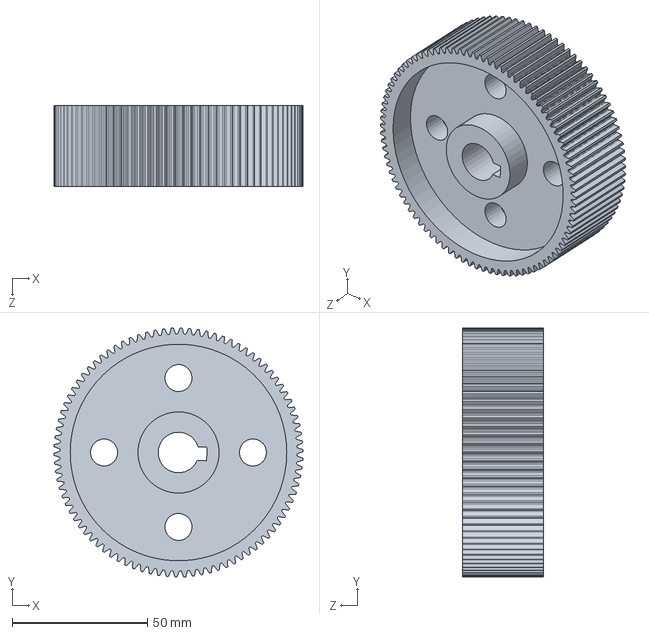
[picture p149: CAD file, 2026-04-28]
Solid/Gear 1.SLDPRT
92.0 x 92.0 x 30.0 mm
