rezaxr14/solar-panel-cleaning-robot/Solid/15 mm key 3x3 for brush.SLDPRT

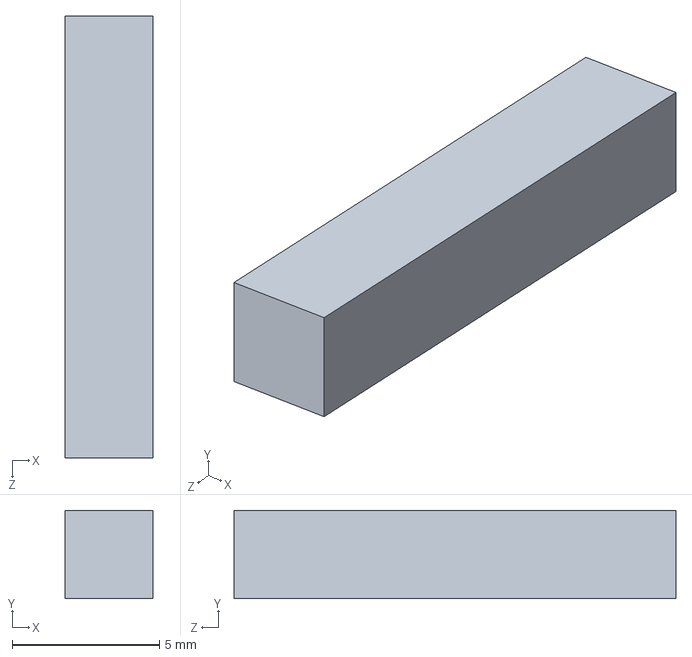
[picture p150: CAD file, 2026-04-28]
Solid/15 mm key 3x3 for brush.SLDPRT
3.00 x 3.00 x 15.0 mm
