rezaxr14/solar-panel-cleaning-robot/MATLAB/SMALL_pulley_Default_sldprt.STEP

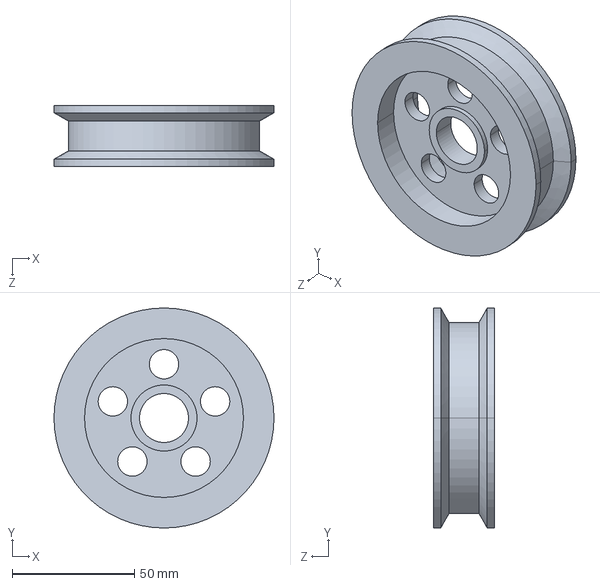
[picture p151: CAD file, 2026-04-28]
MATLAB/SMALL_pulley_Default_sldprt.STEP
90.0 x 90.0 x 25.0 mm
