rezaxr14/solar-panel-cleaning-robot/Solid/30mm key.SLDPRT

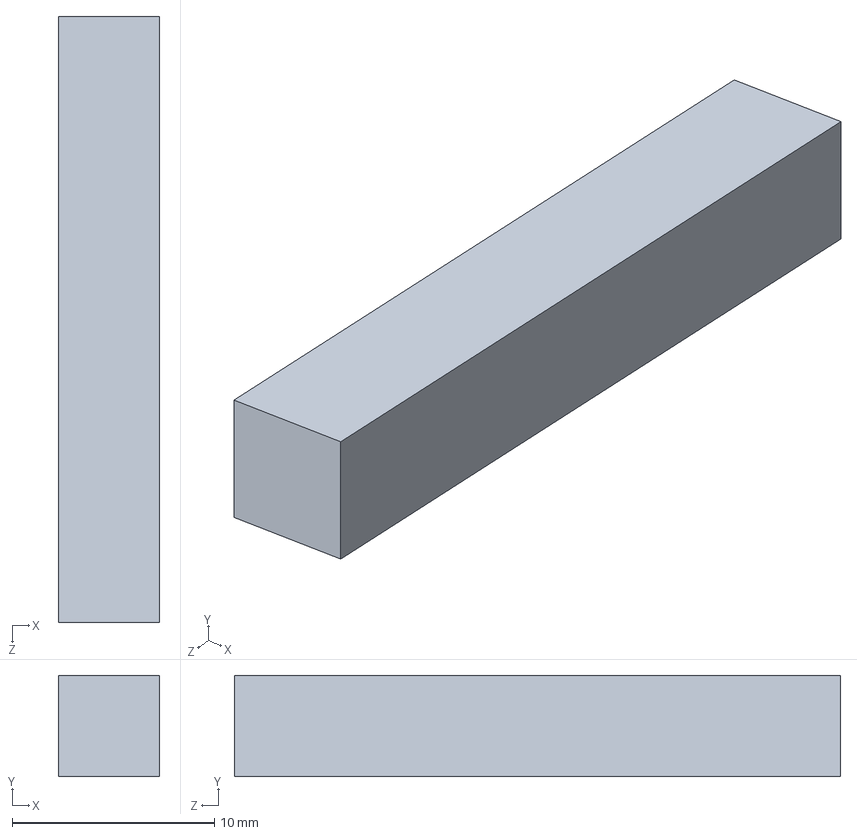
[picture p152: CAD file, 2026-04-28]
Solid/30mm key.SLDPRT
5.00 x 5.00 x 30.0 mm
