rezaxr14/solar-panel-cleaning-robot/MATLAB/40mm key_Default_sldprt.STEP

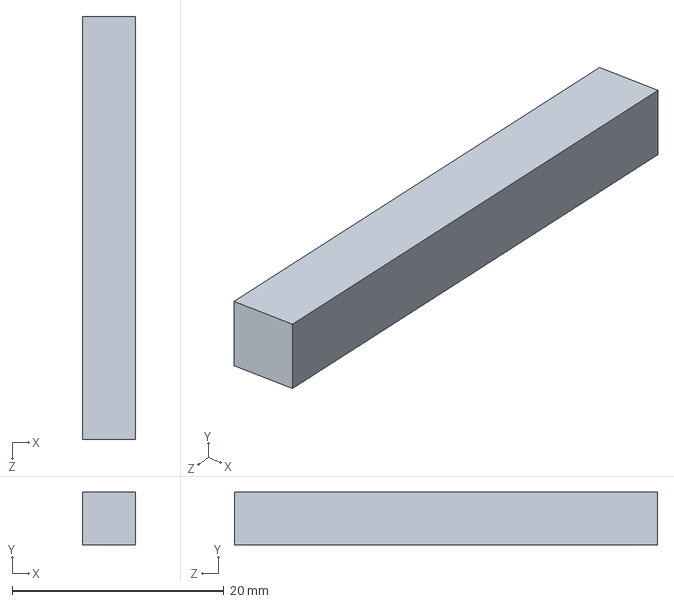
[picture p153: CAD file, 2026-04-28]
MATLAB/40mm key_Default_sldprt.STEP
5.00 x 5.00 x 40.0 mm
