rezaxr14/solar-panel-cleaning-robot/MATLAB/13_dsh-15_Default_sldprt.STEP

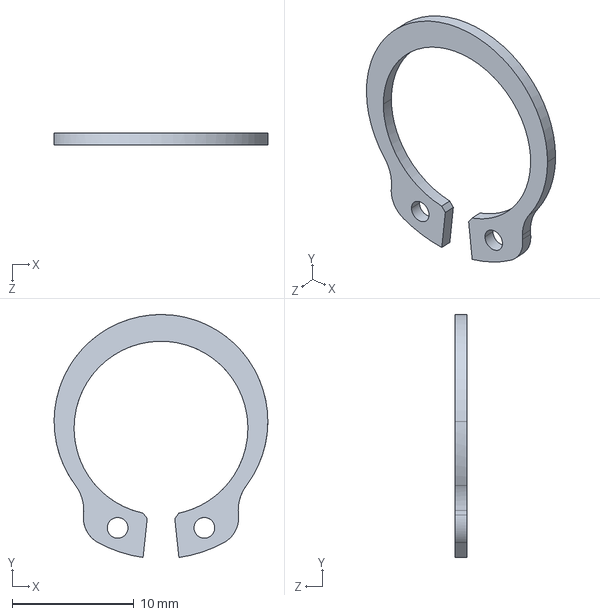
[picture p154: CAD file, 2026-04-28]
MATLAB/13_dsh-15_Default_sldprt.STEP
17.6 x 20.0 x 1.00 mm
