rezaxr14/solar-panel-cleaning-robot/Solid/skf_bearing_628-2z_2_01.SLDPRT

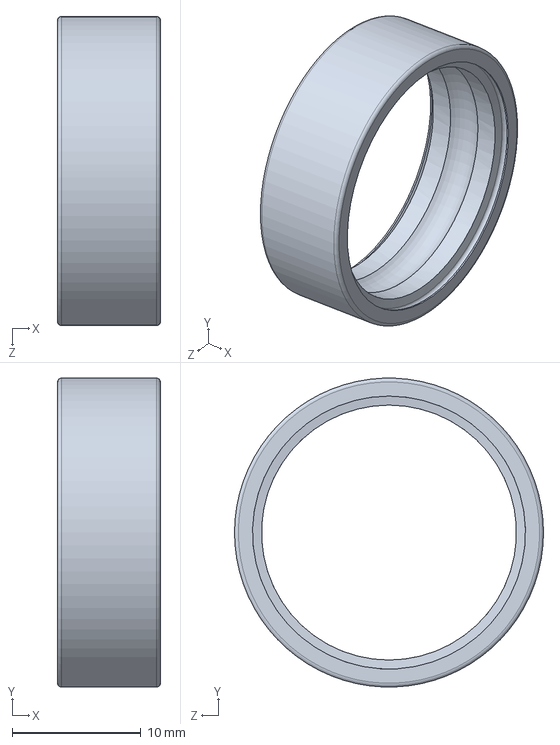
[picture p155: CAD file, 2026-04-28]
Solid/skf_bearing_628-2z_2_01.SLDPRT
8.00 x 24.0 x 24.0 mm
