rezaxr14/solar-panel-cleaning-robot/MATLAB/Terminal-HR12-9_Default_sldprt.STEP

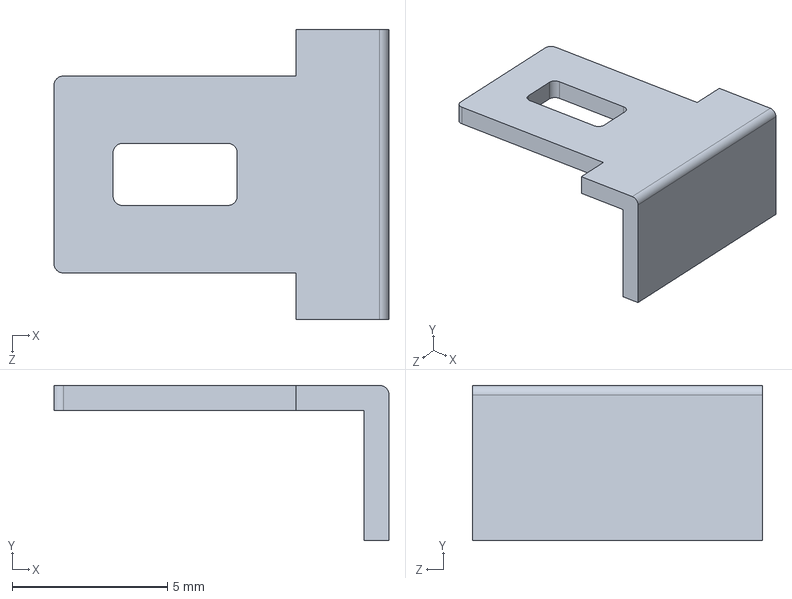
[picture p156: CAD file, 2026-04-28]
MATLAB/Terminal-HR12-9_Default_sldprt.STEP
10.8 x 5.00 x 9.35 mm
