rezaxr14/solar-panel-cleaning-robot/MATLAB/Gear 2_Default_sldprt.STEP

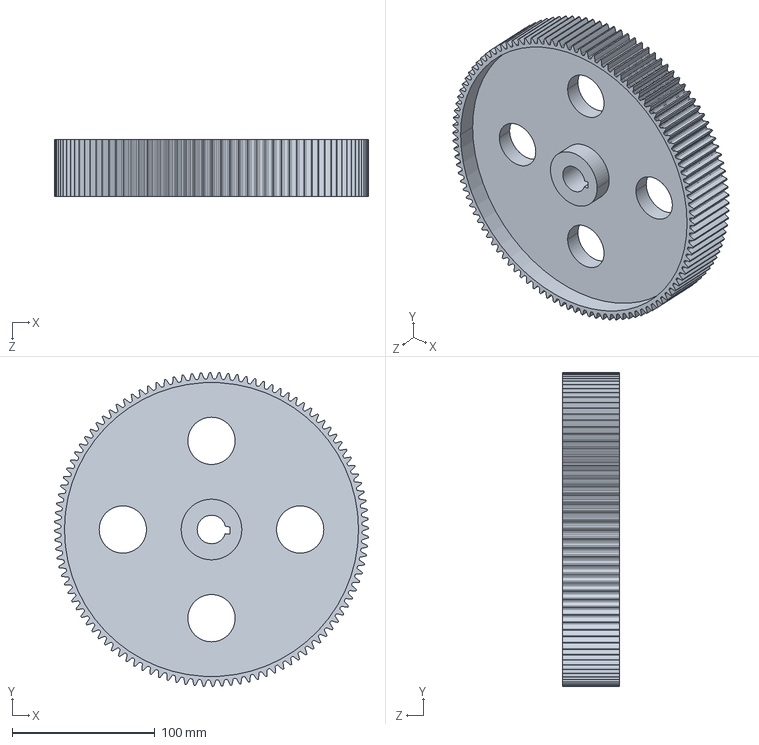
[picture p157: CAD file, 2026-04-28]
MATLAB/Gear 2_Default_sldprt.STEP
220.0 x 220.0 x 40.0 mm
