rezaxr14/solar-panel-cleaning-robot/MATLAB/Part1_Default_sldprt.STEP

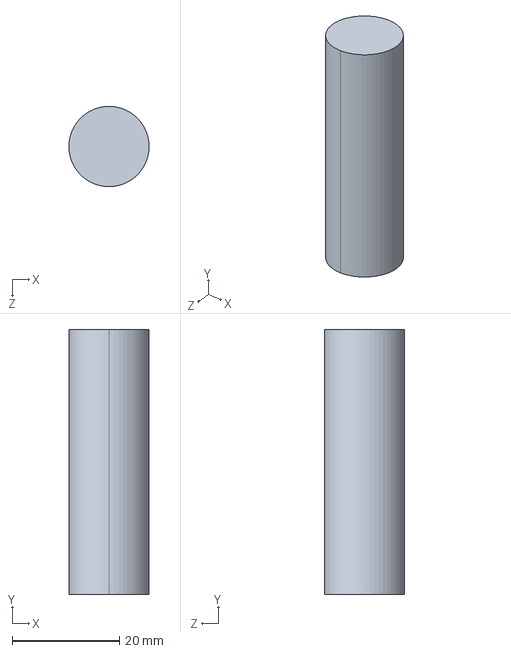
[picture p158: CAD file, 2026-04-28]
MATLAB/Part1_Default_sldprt.STEP
15.0 x 49.5 x 15.0 mm
