rezaxr14/solar-panel-cleaning-robot/Solid/2SMALL_pulley.SLDPRT

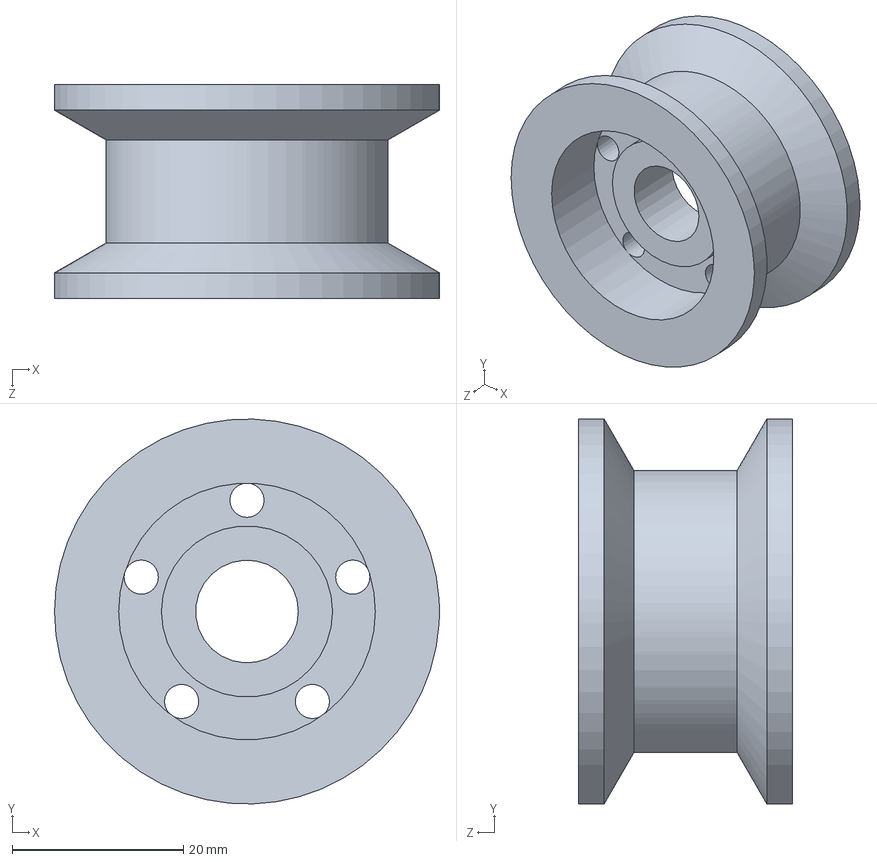
[picture p159: CAD file, 2026-04-28]
Solid/2SMALL_pulley.SLDPRT
45.0 x 45.0 x 25.0 mm
