rezaxr14/solar-panel-cleaning-robot/MATLAB/skf_bearing_61803_2_03_Default_sldprt.STEP

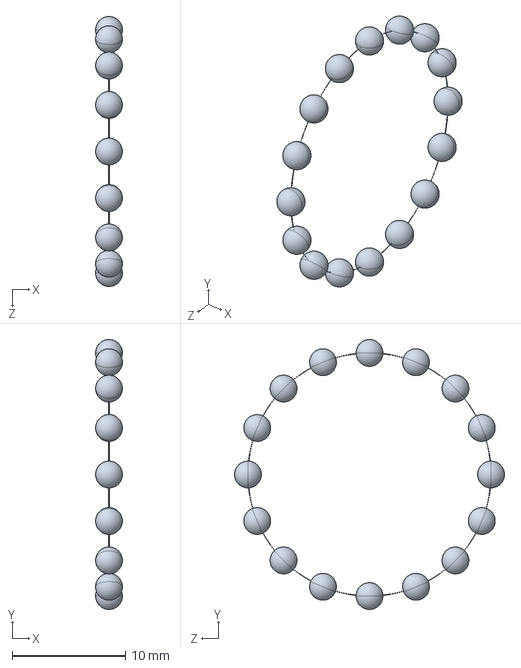
[picture p160: CAD file, 2026-04-28]
MATLAB/skf_bearing_61803_2_03_Default_sldprt.STEP
2.38 x 23.9 x 23.9 mm
