rezaxr14/solar-panel-cleaning-robot/Solid/esp32-wroom-32-v9.step

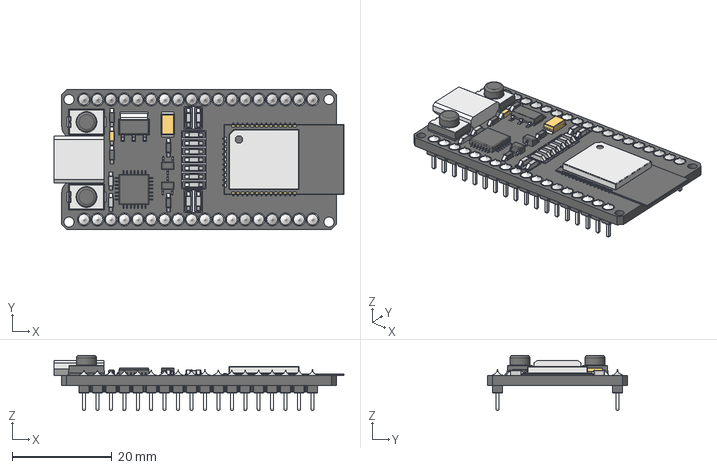
[picture p161: CAD file, 2026-04-28]
Solid/esp32-wroom-32-v9.step
58.0 x 28.0 x 11.1 mm
Component1(Mirror)
