rezaxr14/solar-panel-cleaning-robot/MATLAB/skf_bearing_628-2z_2_05_Default_sldprt.STEP

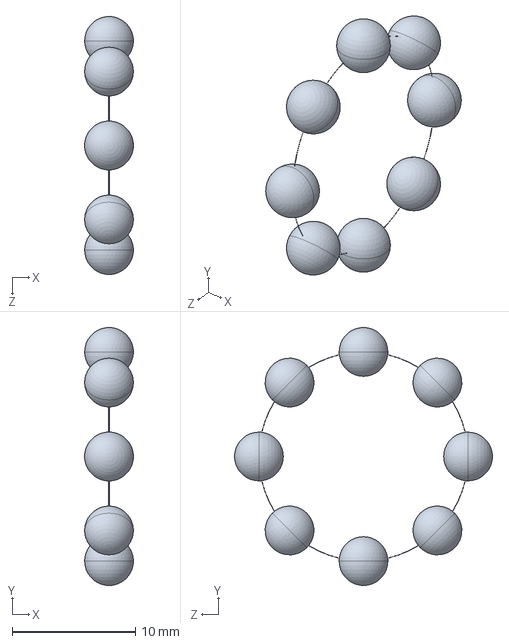
[picture p162: CAD file, 2026-04-28]
MATLAB/skf_bearing_628-2z_2_05_Default_sldprt.STEP
3.97 x 21.0 x 21.0 mm
