rezaxr14/solar-panel-cleaning-robot/MATLAB/shaft 3_Default_sldprt.STEP

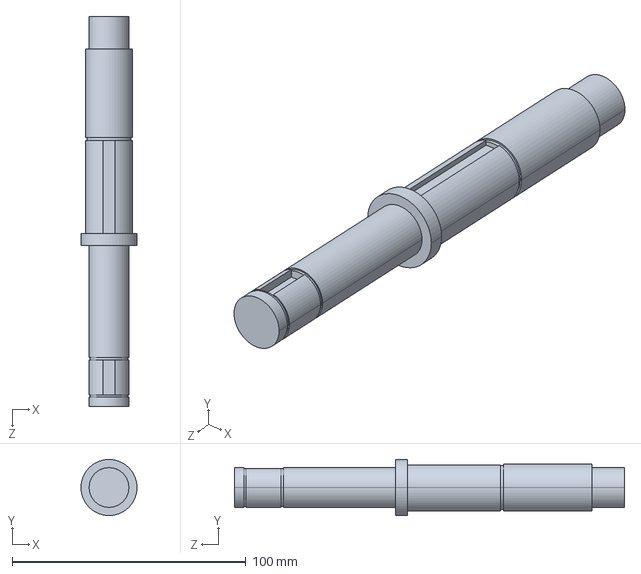
[picture p163: CAD file, 2026-04-28]
MATLAB/shaft 3_Default_sldprt.STEP
24.0 x 24.0 x 167.0 mm
