rezaxr14/solar-panel-cleaning-robot/Solid/skf_bearing_61803_2_03.SLDPRT

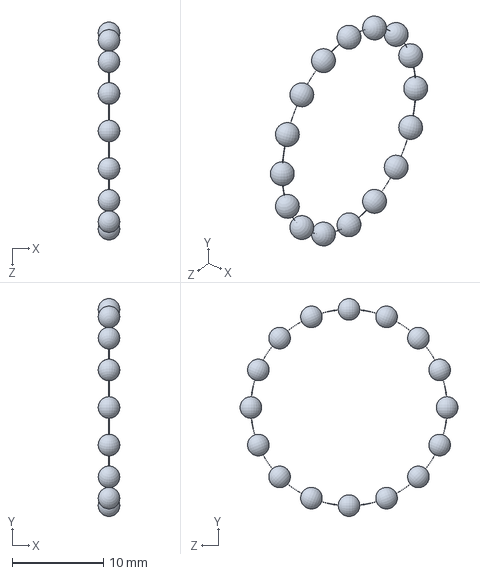
[picture p164: CAD file, 2026-04-28]
Solid/skf_bearing_61803_2_03.SLDPRT
2.38 x 23.9 x 23.9 mm
