rezaxr14/solar-panel-cleaning-robot/MATLAB/railsStand.STEP

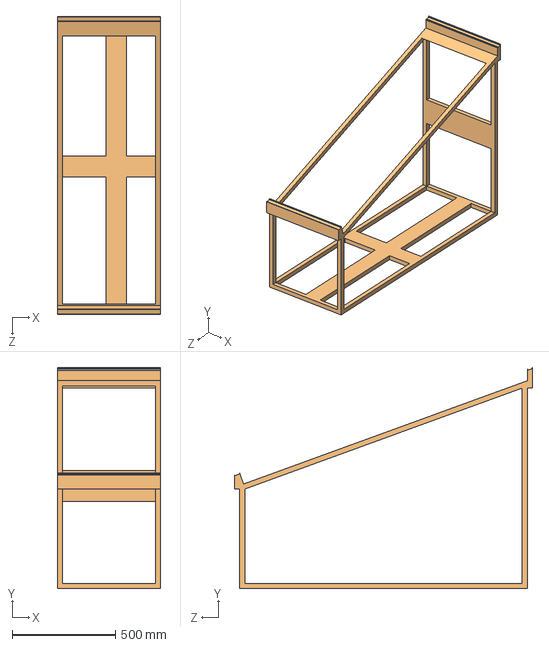
[picture p165: CAD file, 2026-04-28]
MATLAB/railsStand.STEP
500.0 x 1072.2 x 1445.4 mm
