rezaxr14/solar-panel-cleaning-robot/Solid/skf_bearing_628-2z_2_02.SLDPRT

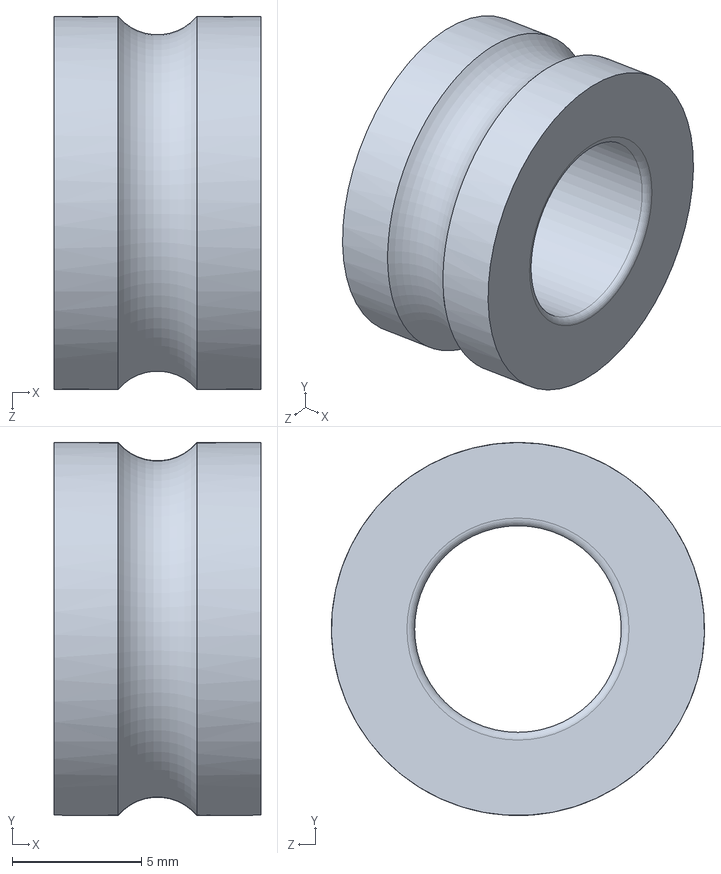
[picture p166: CAD file, 2026-04-28]
Solid/skf_bearing_628-2z_2_02.SLDPRT
8.00 x 14.4 x 14.4 mm
