rezaxr14/solar-panel-cleaning-robot/MATLAB/skf_bearing_6303_2_03_Default_sldprt.STEP

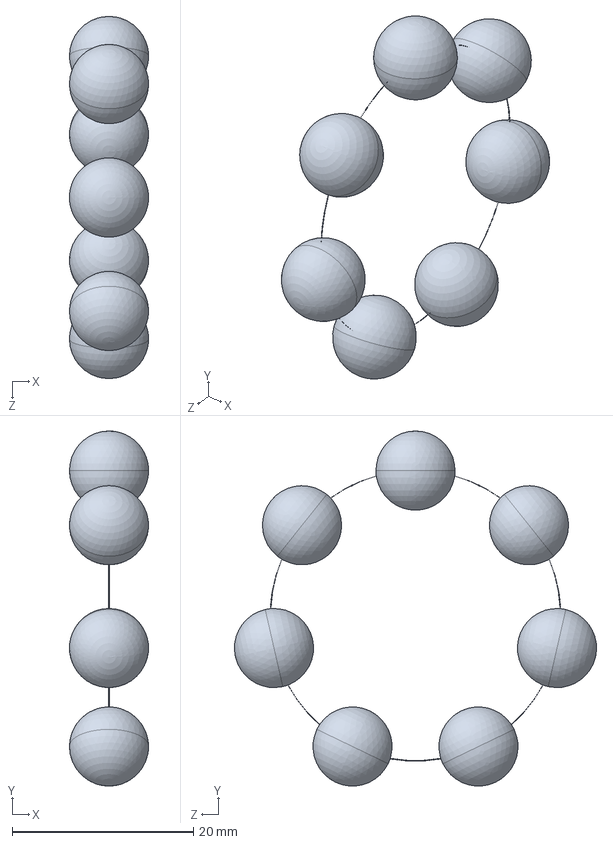
[picture p167: CAD file, 2026-04-28]
MATLAB/skf_bearing_6303_2_03_Default_sldprt.STEP
8.73 x 39.1 x 39.9 mm
