rezaxr14/solar-panel-cleaning-robot/Solid/Shaft 1.SLDPRT

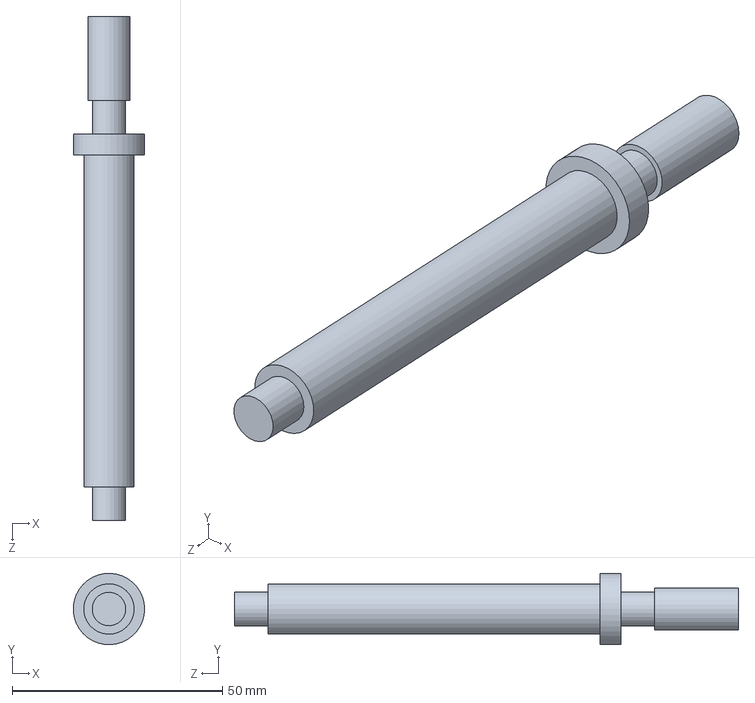
[picture p168: CAD file, 2026-04-28]
Solid/Shaft 1.SLDPRT
17.0 x 17.0 x 120.0 mm
