rezaxr14/solar-panel-cleaning-robot/Solid/Small solar panel.SLDPRT

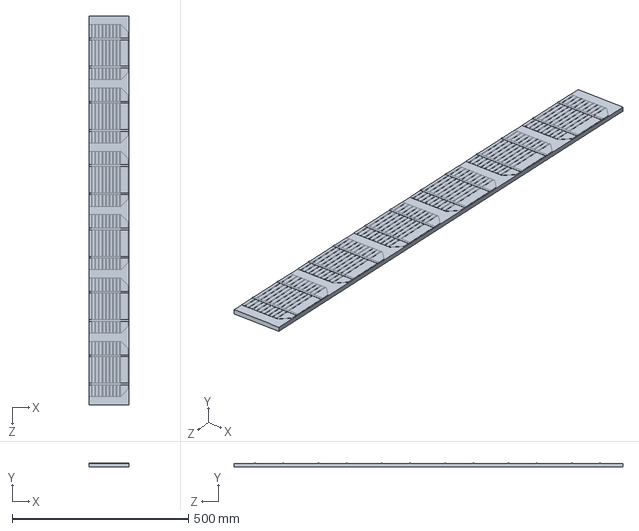
[picture p169: CAD file, 2026-04-28]
Solid/Small solar panel.SLDPRT
112.4 x 10.7 x 1105.0 mm
