rezaxr14/solar-panel-cleaning-robot/MATLAB/15mm key wheel_Default_sldprt.STEP

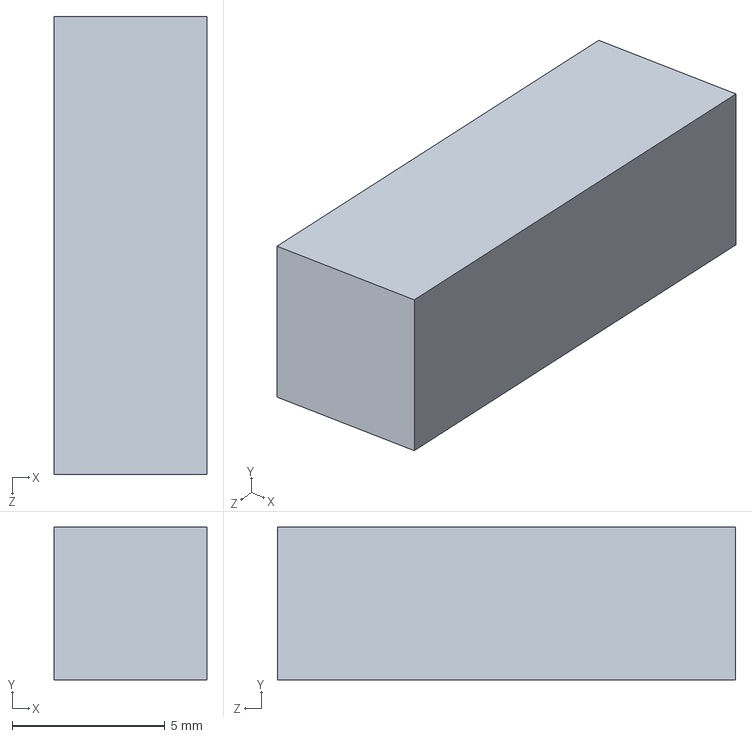
[picture p170: CAD file, 2026-04-28]
MATLAB/15mm key wheel_Default_sldprt.STEP
5.00 x 5.00 x 15.0 mm
