rezaxr14/solar-panel-cleaning-robot/Solid/ACİL STOP.SLDPRT

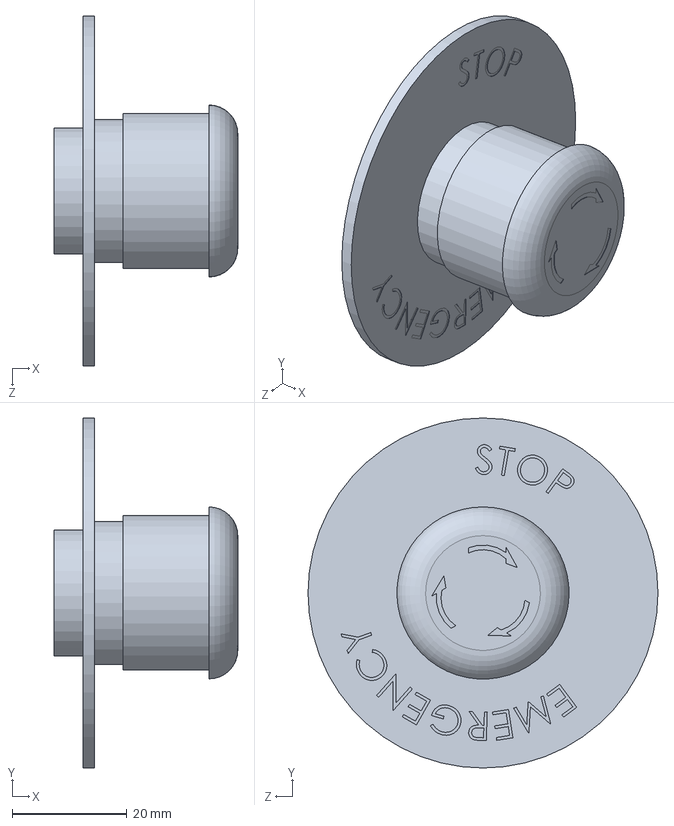
[picture p171: CAD file, 2026-04-28]
Solid/ACİL STOP.SLDPRT
32.0 x 61.0 x 61.0 mm
