rezaxr14/solar-panel-cleaning-robot/Solid/servo link.SLDPRT

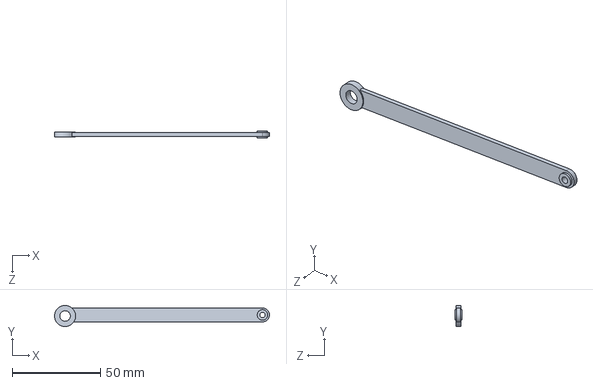
[picture p172: CAD file, 2026-04-28]
Solid/servo link.SLDPRT
122.0 x 12.0 x 4.00 mm
