rezaxr14/solar-panel-cleaning-robot/Solid/box.SLDPRT

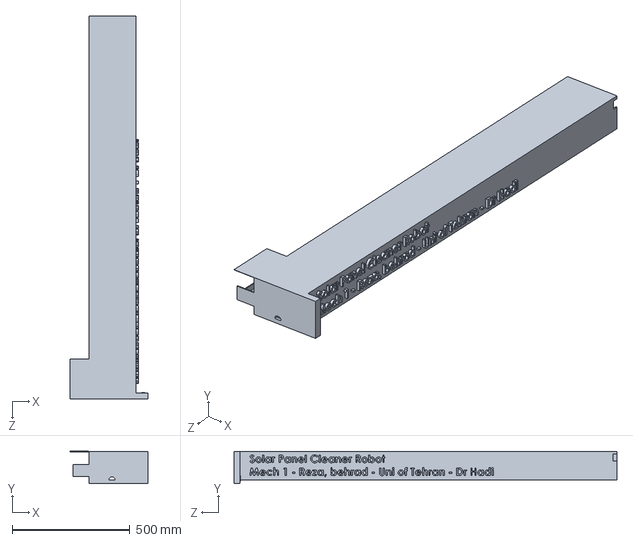
[picture p173: CAD file, 2026-04-28]
Solid/box.SLDPRT
330.0 x 136.0 x 1625.0 mm
