rezaxr14/solar-panel-cleaning-robot/MATLAB/BIG_pulley_Default_sldprt.STEP

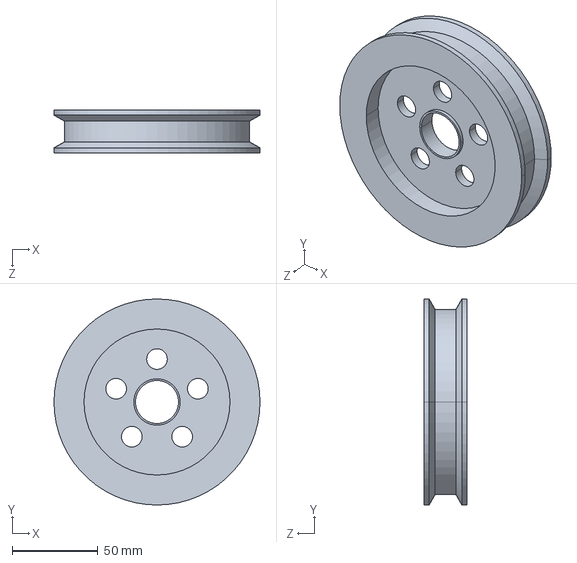
[picture p174: CAD file, 2026-04-28]
MATLAB/BIG_pulley_Default_sldprt.STEP
120.0 x 120.0 x 25.0 mm
