rezaxr14/solar-panel-cleaning-robot/Solid/macro-servo2.SLDPRT

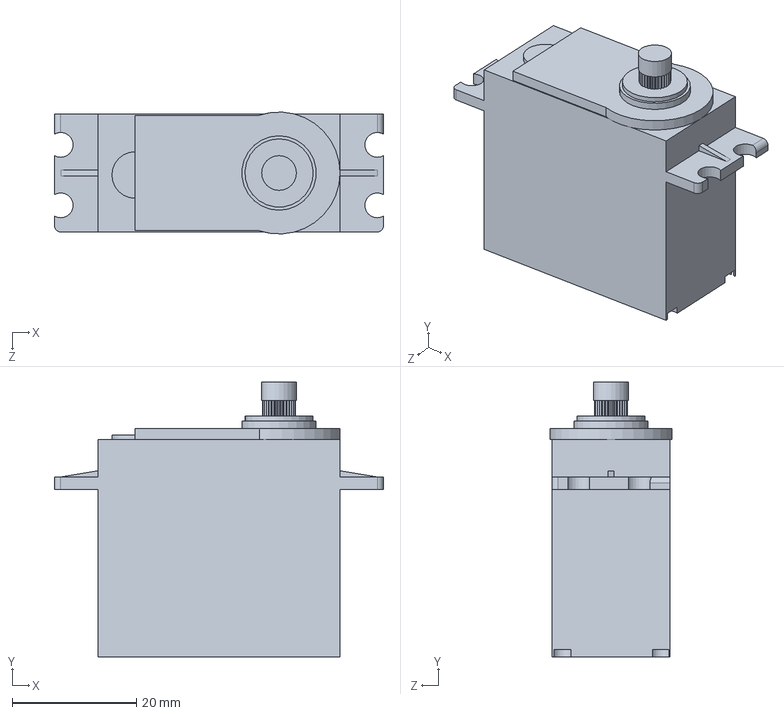
[picture p175: CAD file, 2026-04-28]
Solid/macro-servo2.SLDPRT
53.0 x 44.3 x 19.6 mm
