rezaxr14/solar-panel-cleaning-robot/MATLAB/motor DC_Default_sldprt.STEP

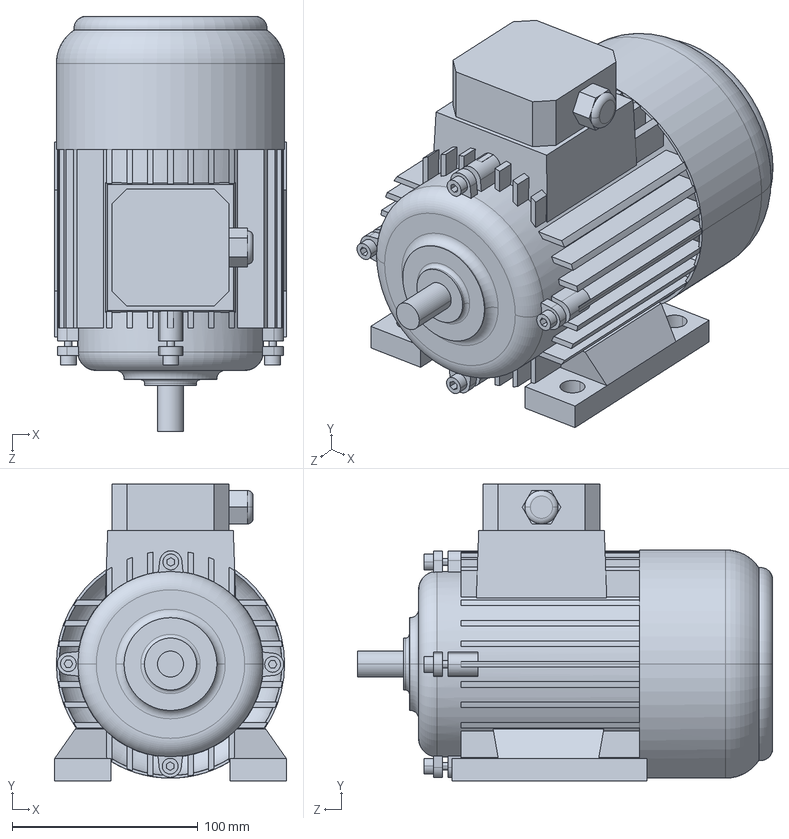
[picture p176: CAD file, 2026-04-28]
MATLAB/motor DC_Default_sldprt.STEP
125.0 x 160.0 x 223.8 mm
