rezaxr14/solar-panel-cleaning-robot/Solid/skf_bearing_6303_2_02.SLDPRT

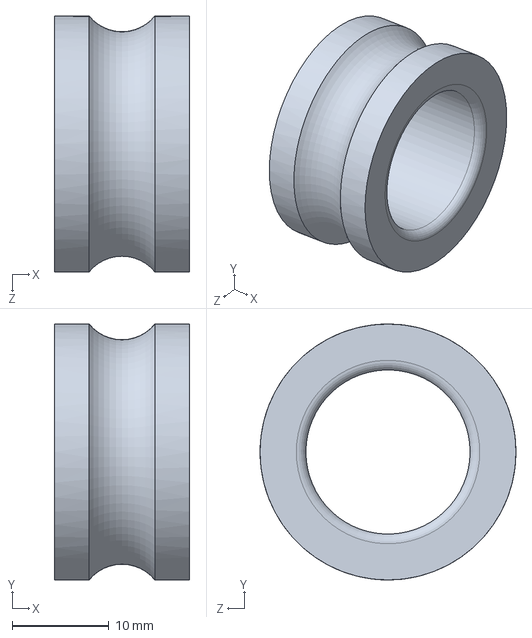
[picture p177: CAD file, 2026-04-28]
Solid/skf_bearing_6303_2_02.SLDPRT
14.0 x 26.5 x 26.5 mm
