rezaxr14/solar-panel-cleaning-robot/Solid/Beetle ESP32-C6.SLDPRT

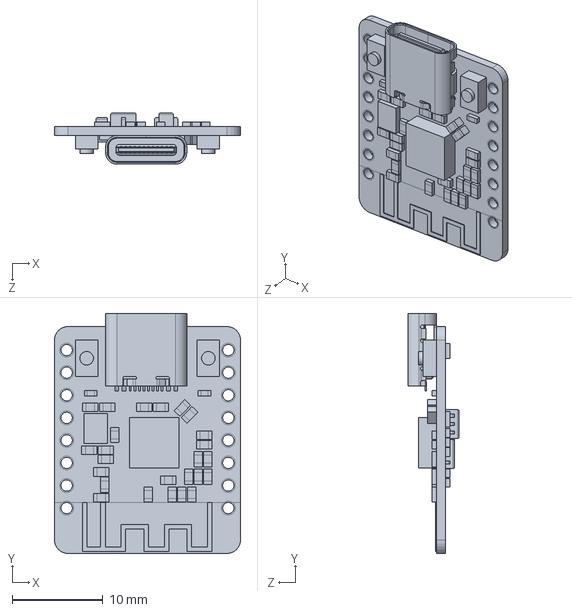
[picture p178: CAD file, 2026-04-28]
Solid/Beetle ESP32-C6.SLDPRT
20.5 x 26.4 x 5.66 mm
