rezaxr14/solar-panel-cleaning-robot/MATLAB/2SMALL_pulley_Default_sldprt.STEP

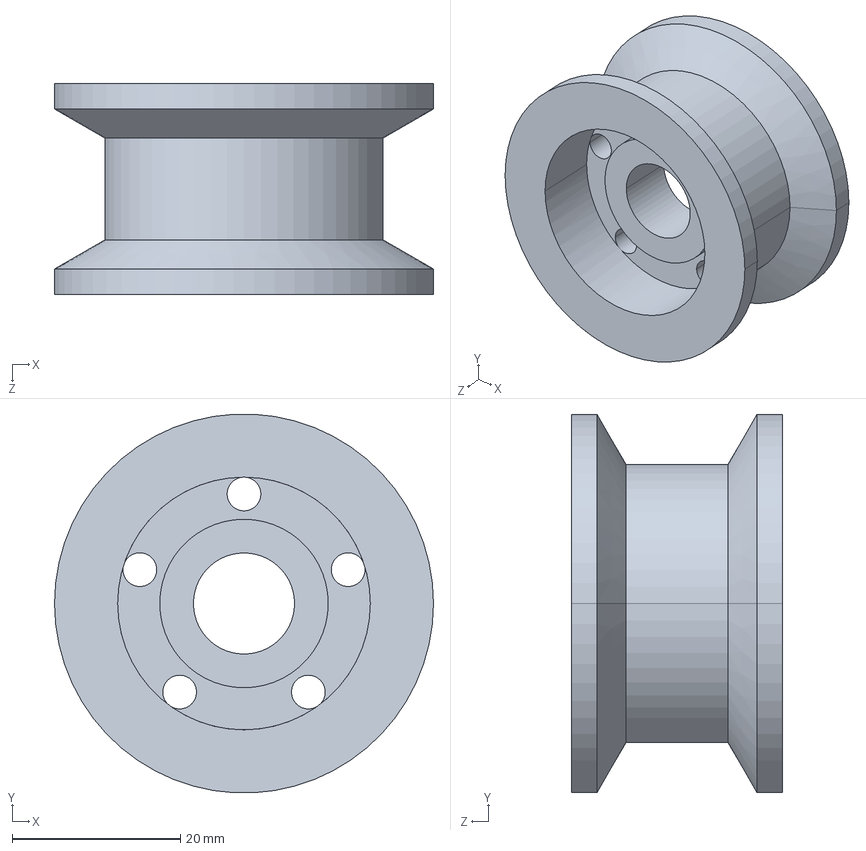
[picture p179: CAD file, 2026-04-28]
MATLAB/2SMALL_pulley_Default_sldprt.STEP
45.0 x 44.9 x 25.0 mm
