rezaxr14/solar-panel-cleaning-robot/Solid/Lora antenna SMA connector.step

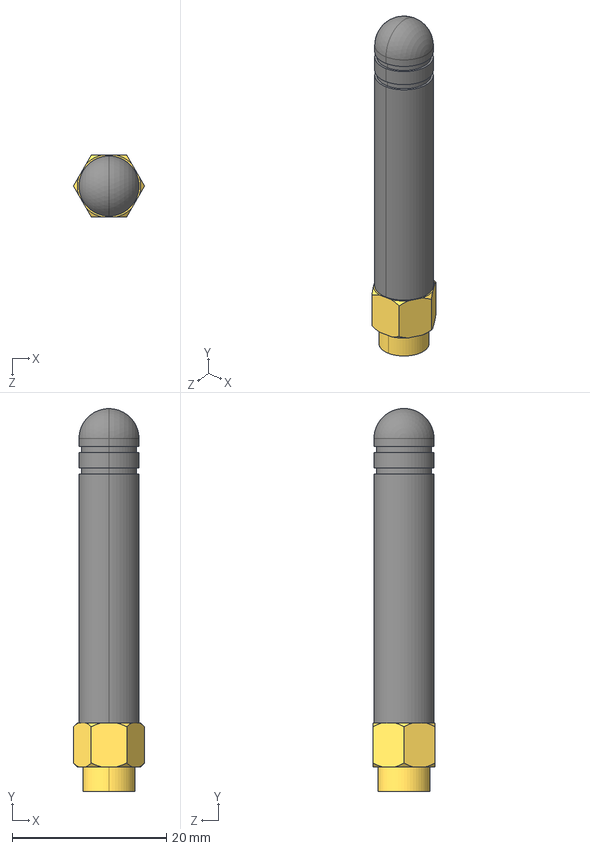
[picture p180: CAD file, 2026-04-28]
Solid/Lora antenna SMA connector.step
9.24 x 49.7 x 8.00 mm
