rezaxr14/solar-panel-cleaning-robot/MATLAB/railsStand2.STEP

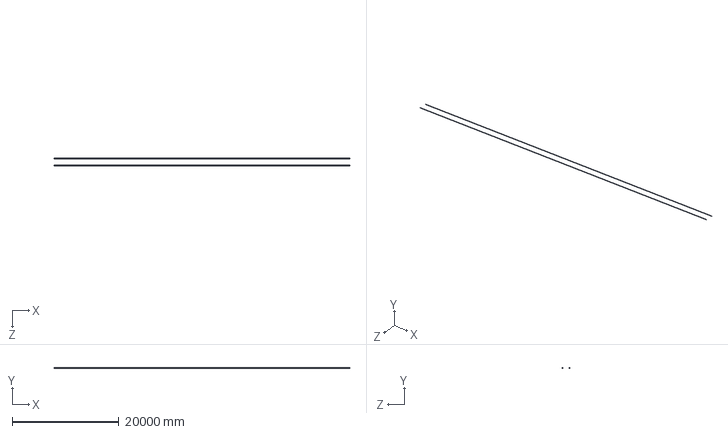
[picture p181: CAD file, 2026-04-28]
MATLAB/railsStand2.STEP
55500.0 x 25.0 x 1395.4 mm
