rezaxr14/solar-panel-cleaning-robot/MATLAB/Pinion 2_Default_sldprt.STEP

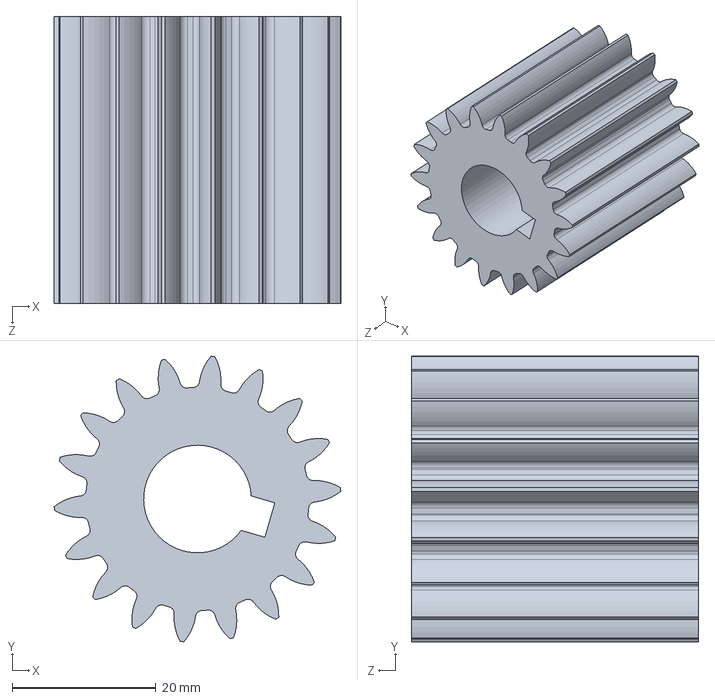
[picture p182: CAD file, 2026-04-28]
MATLAB/Pinion 2_Default_sldprt.STEP
39.9 x 39.8 x 40.0 mm
