rezaxr14/solar-panel-cleaning-robot/Solid/Wheel.SLDPRT

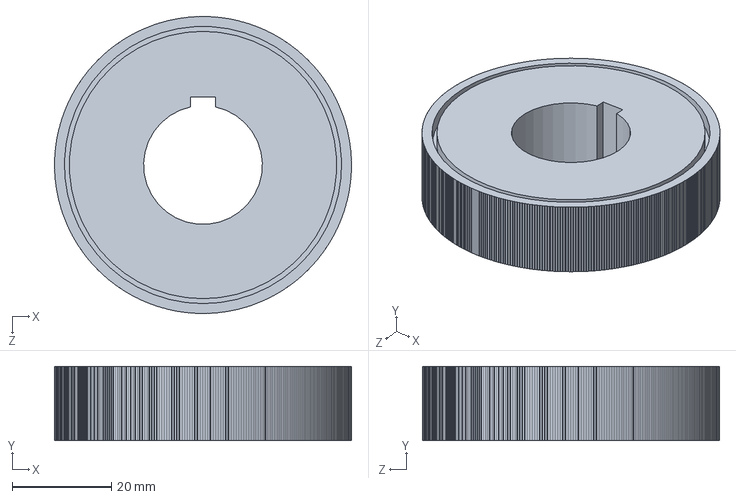
[picture p183: CAD file, 2026-04-28]
Solid/Wheel.SLDPRT
60.0 x 15.0 x 60.0 mm
