rezaxr14/solar-panel-cleaning-robot/Solid/IR_Sensor_YL63_UnPinned.SLDPRT

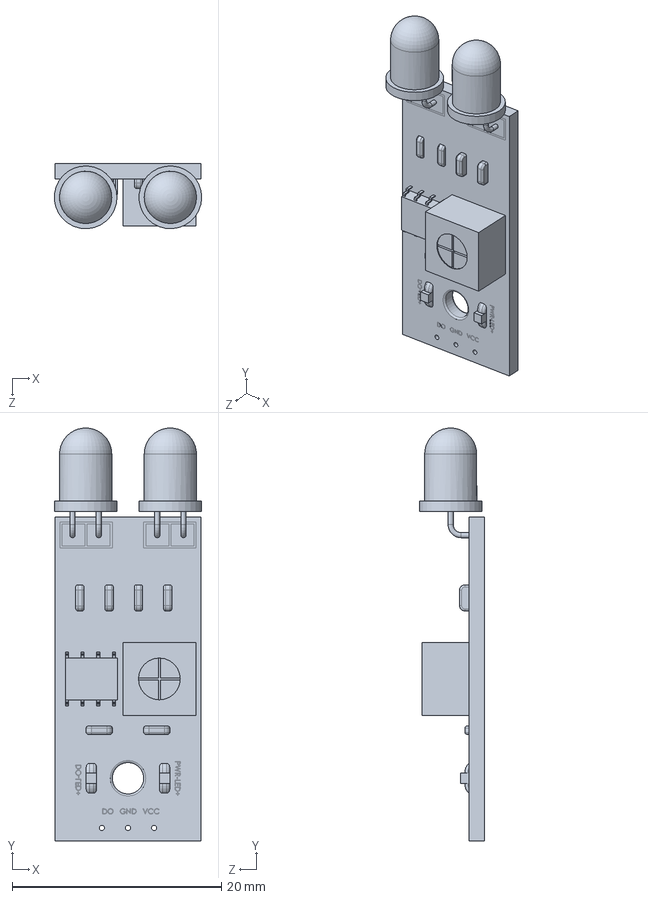
[picture p184: CAD file, 2026-04-28]
Solid/IR_Sensor_YL63_UnPinned.SLDPRT
14.1 x 39.5 x 6.25 mm
