rezaxr14/solar-panel-cleaning-robot/MATLAB/railsStand 5.STEP

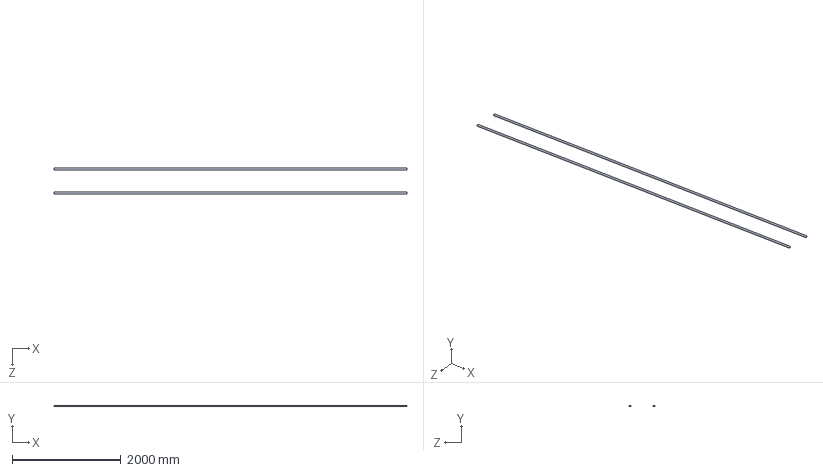
[picture p185: CAD file, 2026-04-28]
MATLAB/railsStand 5.STEP
6500.0 x 16.9 x 470.0 mm
