rezaxr14/solar-panel-cleaning-robot/Solid/Part1.SLDPRT

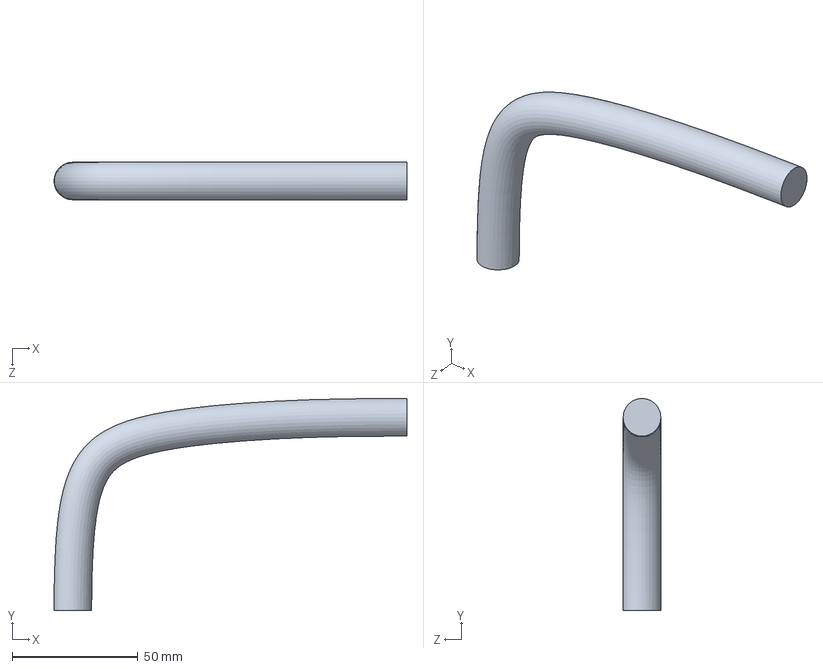
[picture p186: CAD file, 2026-04-28]
Solid/Part1.SLDPRT
140.5 x 84.4 x 15.0 mm
