rezaxr14/solar-panel-cleaning-robot/Solid/A6M80-750H2A1-M17.step

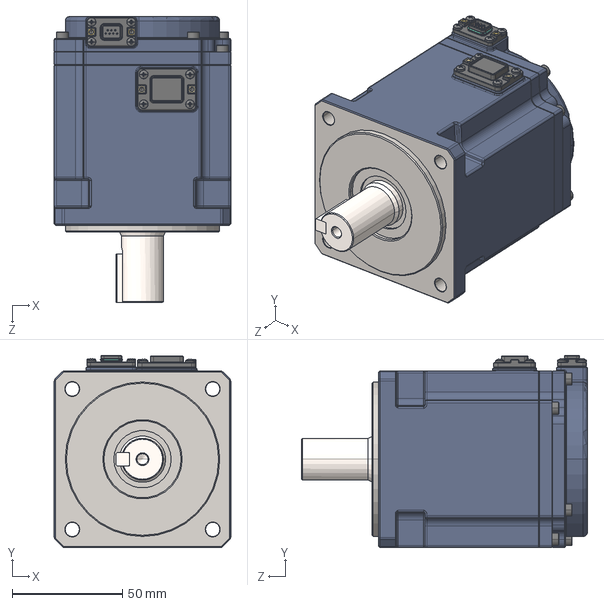
[picture p187: CAD file, 2026-04-28]
Solid/A6M80-750H2A1-M17.step
80.0 x 87.0 x 129.6 mm
