rezaxr14/solar-panel-cleaning-robot/Solid/HR12-9.SLDASM

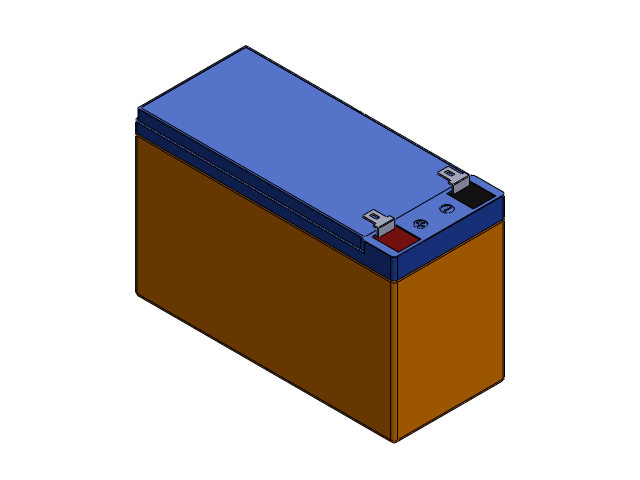
[picture p188: CAD file, 2026-04-28]
Solid/HR12-9.SLDASM
Body^HR12-9
Terminal^HR12-9 x 2
