rezaxr14/solar-panel-cleaning-robot/(list of files, cad)

Other CAD files:
Solid/18_dsh-20.SLDPRT
Solid/15_dsh-17.SLDPRT
MATLAB/Gear 1_Default_sldprt.STEP
Solid/drag.SLDPRT
Solid/skf_bearing_628-2z_2_04.SLDPRT
MATLAB/2second_Roller Brush_Default_sldprt.STEP
Solid/skf_bearing_6301_2_01.SLDPRT
Solid/skf_bearing_61803_2_01.SLDPRT
MATLAB/wheel small shaft_Default_sldprt.STEP
MATLAB/30mm key_Default_sldprt.STEP
MATLAB/skf_bearing_6301_2_02_Default_sldprt.STEP
Solid/Gear 2.SLDPRT
MATLAB/skf_bearing_6303_2_01_Default_sldprt.STEP
MATLAB/skf_bearing_61803_2_02_Default_sldprt.STEP
MATLAB/ACIL STOP_Varsayilan_sldprt.STEP
Solid/15mm key wheel.SLDPRT
MATLAB/Shaft 1_Default_sldprt.STEP
Solid/13_dsh-15.SLDPRT
MATLAB/Small solar panel_Default_sldprt.STEP
MATLAB/Pinion 1_Default_sldprt.STEP
Solid/skf_bearing_6303_2_03.SLDPRT
Solid/motor DC.SLDPRT
MATLAB/Wheel_Default_sldprt.STEP
Solid/skf_bearing_628-2z_2_03.SLDPRT
MATLAB/skf_bearing_628-2z_2_02_Default_sldprt.STEP
Solid/40mm key.SLDPRT
MATLAB/Beetle ESP32-C6_Default_sldprt.STEP
Solid/led.SLDPRT
MATLAB/skf_bearing_628-2z_2_01_Default_sldprt.STEP
MATLAB/skf_bearing_6301_2_03_Default_sldprt.STEP
MATLAB/skf_bearing_6303_2_02_Default_sldprt.STEP
MATLAB/skf_bearing_628-2z_2_03_Default_sldprt.STEP
Solid/Shaft 2.SLDPRT
Solid/Pinion 2.SLDPRT
MATLAB/15 mm key 3x3 for brush_Default_sldprt.STEP
MATLAB/Roller Brush_Default_sldprt.STEP
Solid/10_dsh-12.SLDPRT
Solid/2second_Roller Brush.SLDPRT
Solid/cope.SLDPRT
Solid/Plum coupling 14-10mm.STEP
Solid/shaft 3.SLDPRT
MATLAB/707353_Default_sldprt.STEP
MATLAB/formed hex screw_am_B18.2.3.2M - Formed hex screw- M12 x 1.75 x 35 --35WN_sldprt.STEP
MATLAB/formed hex screw_am_B18.2.3.2M - Formed hex screw- M8 x 1.25 x 12 --12WN_sldprt.STEP
MATLAB/hex nut heavy_am_B18.2.4.6M - Heavy hex nut- M12 x 1.75 --W-N_sldprt.STEP
MATLAB/plate screw_Default_sldprt.STEP
Solid/707353.SLDPRT
Solid/Plum coupling 14-10mm.SLDPRT
Solid/plate screw.SLDPRT
