rezaxr14/solar-panel-cleaning-robot/(notices)

Notices in the files:
README.MD:
License: MIT
